jochenalt/Lisbeth/docs/source/index.rst

Welcome to Lisbeth's documentation
==================================

**Lisbeth** is my moody dog. 

.. toctree::
   :hidden:
   :maxdepth: 2

   introduction
   controller
   mechanics
   imu
