jochenalt/Lisbeth/docs/theory.xlsx

Calculation Belt length and shaft distance in HTD 3M
Teeth distance | 3 | [mm]
Teeth1 | 10 | #
Teeth2 | 30 | #
Estimated shaft distance | 71 | [mm]
Length of the belt (without teeth) | 203.3 | [mm]
Actual belt Length | 204 | [mm]
Used Belt lenth | 204 | [mm]
Shaft Distance | 71.36 | [mm]
