jochenalt/Lisbeth/docs/source/images/all/IMG_20220222_164507.jpg

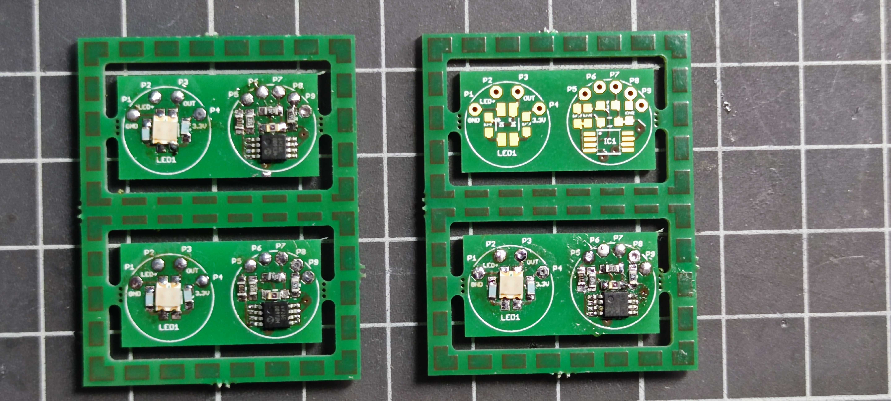
docs/source/images/all/IMG_20220222_164507.jpg
