jochenalt/Lisbeth/docs/source/images/all/IMG_20220223_130408.jpg

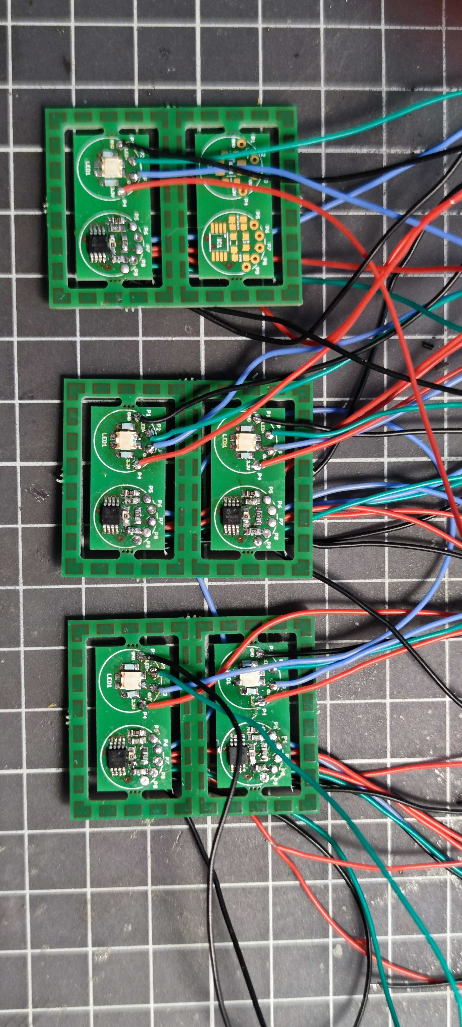
docs/source/images/all/IMG_20220223_130408.jpg
