jochenalt/Lisbeth/docs/source/images/all/IMG_20220223_134208.jpg

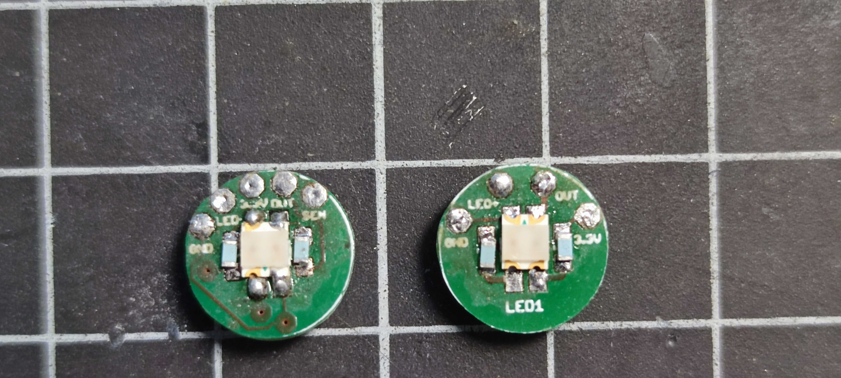
docs/source/images/all/IMG_20220223_134208.jpg
