jochenalt/Lisbeth/docs/source/images/all/IMG_20220308_162108.jpg

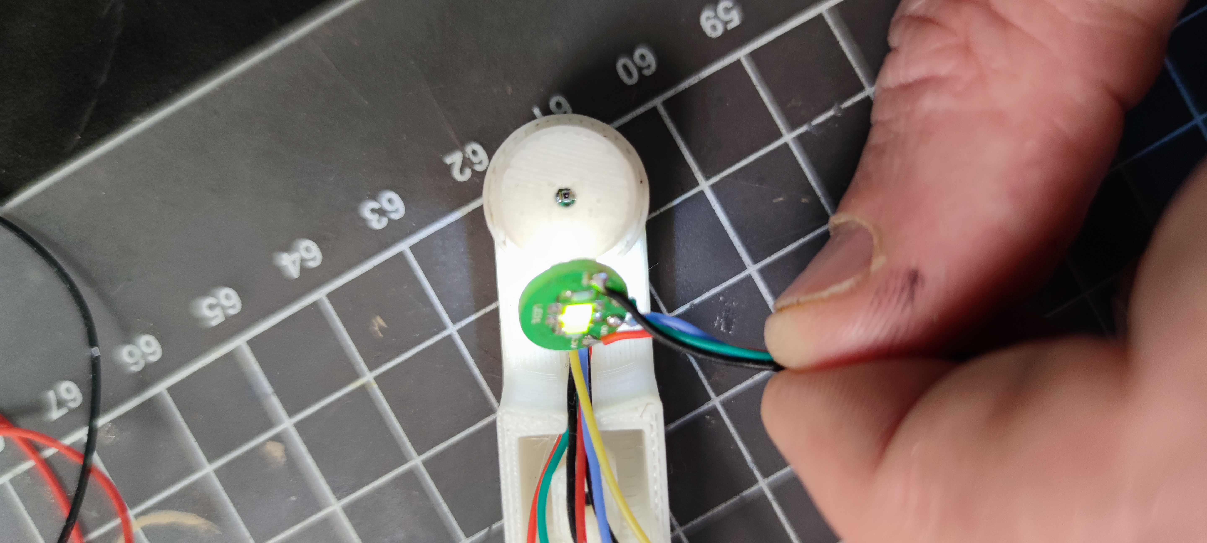
docs/source/images/all/IMG_20220308_162108.jpg
