jochenalt/Lisbeth/docs/source/images/all/IMG_20220308_224854.jpg

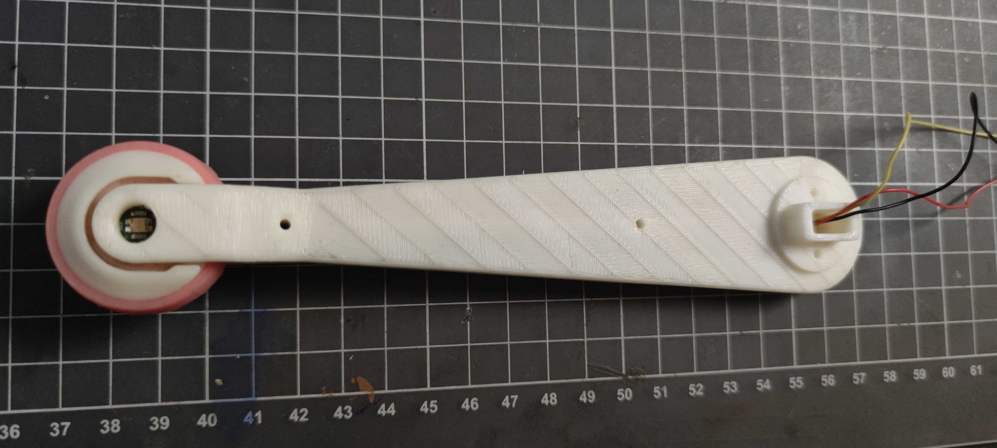
docs/source/images/all/IMG_20220308_224854.jpg
