jochenalt/Lisbeth/docs/source/images/all/IMG_20220308_225036.jpg

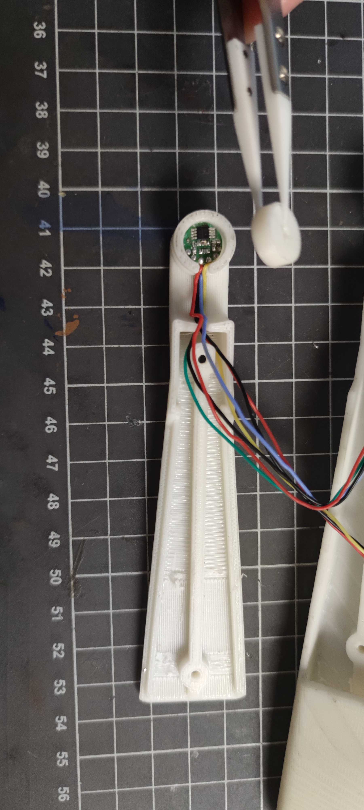
docs/source/images/all/IMG_20220308_225036.jpg
