jochenalt/Lisbeth/docs/source/images/all/IMG_20220308_225524.jpg

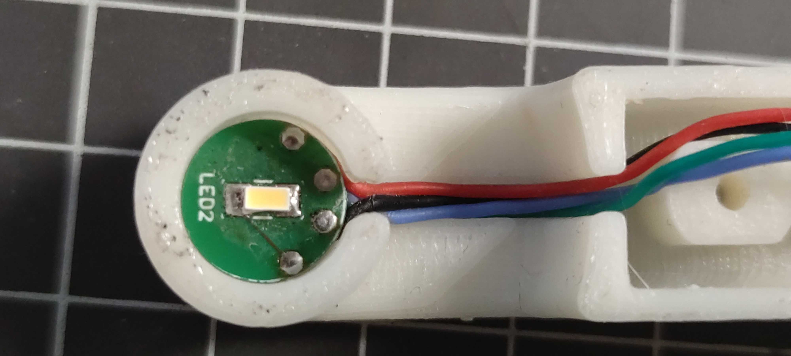
docs/source/images/all/IMG_20220308_225524.jpg
