jochenalt/Lisbeth/docs/source/images/all/WhatsApp Image 2022-03-12 at 16.48.09.jpeg

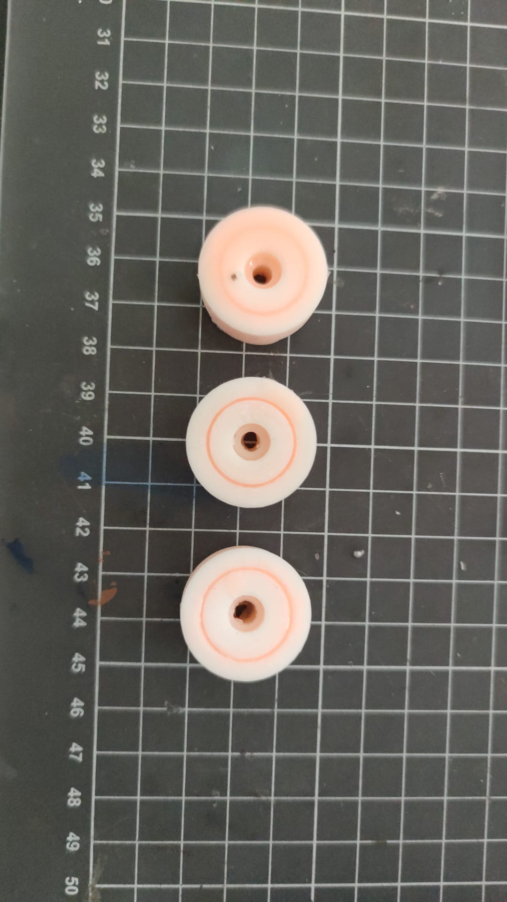
docs/source/images/all/WhatsApp Image 2022-03-12 at 16.48.09.jpeg
