jochenalt/Lisbeth/docs/source/images/IMU_and_Magnetometer_mounted.jpg

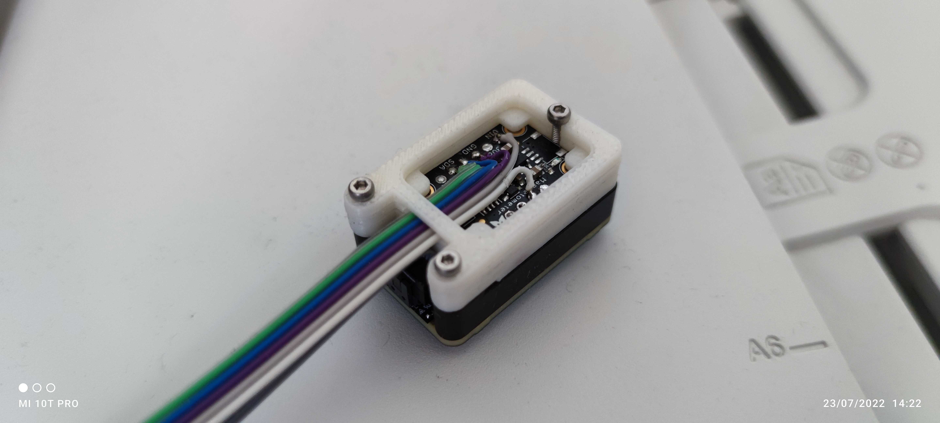
docs/source/images/IMU_and_Magnetometer_mounted.jpg
