jochenalt/Lisbeth/docs/source/images/IMU_Holder.png

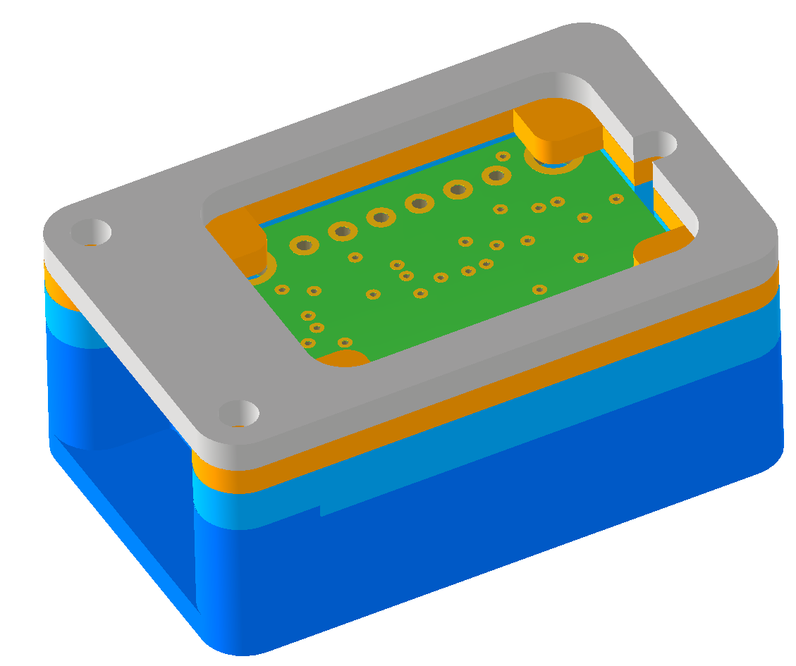
docs/source/images/IMU_Holder.png
