jochenalt/Lisbeth/docs/source/images/Lord_Microstrain_3DMCV5-IMU.png

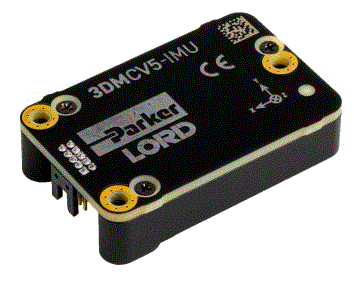
docs/source/images/Lord_Microstrain_3DMCV5-IMU.png
