jochenalt/Lisbeth/docs/source/images/Magnetometer_Original.png

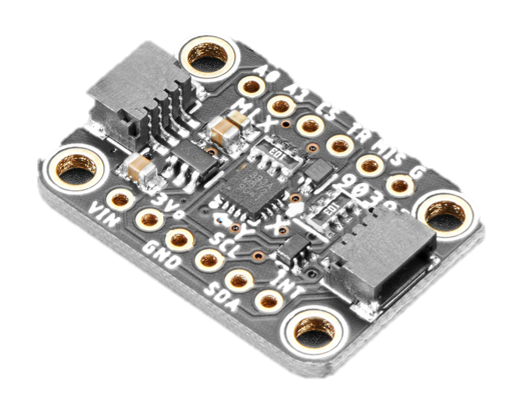
docs/source/images/Magnetometer_Original.png
