jochenalt/Lisbeth/docs/source/images/Magnetometer_without_sockets.png

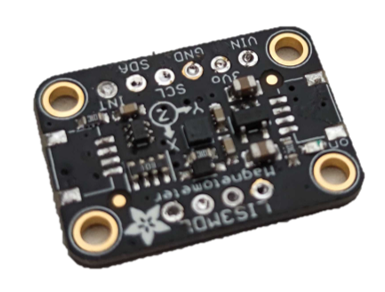
docs/source/images/Magnetometer_without_sockets.png
