jochenalt/Lisbeth/docs/source/images/ODrive_pinout.png

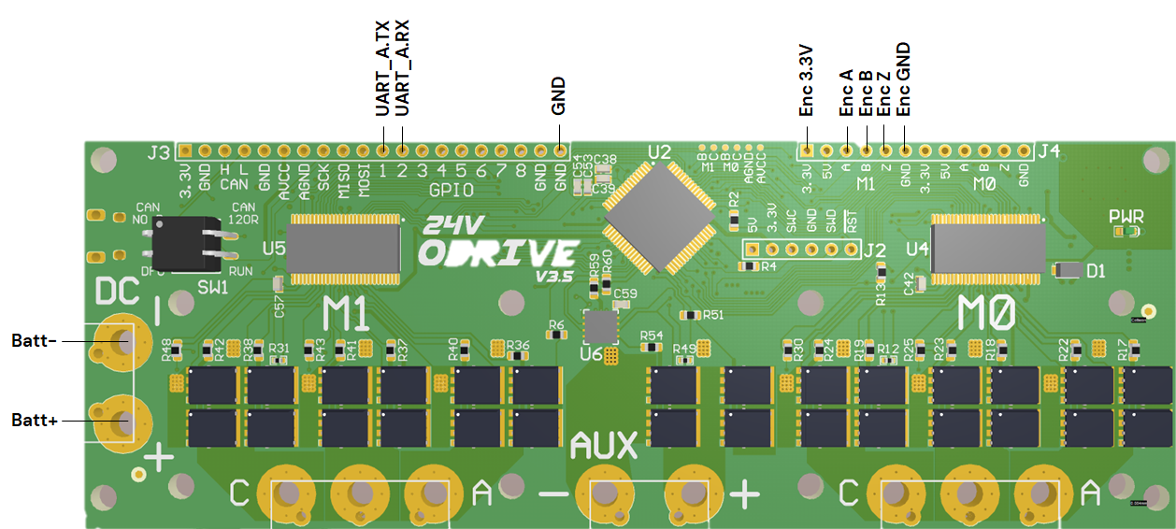
docs/source/images/ODrive_pinout.png
