jochenalt/Lisbeth/docs/source/images/Raspberry_Pinout.png

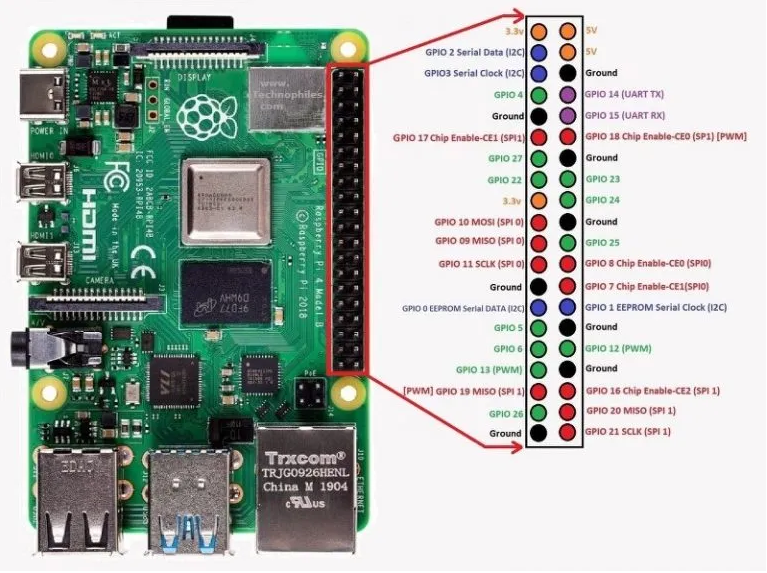
docs/source/images/Raspberry_Pinout.png
