jochenalt/Lisbeth/docs/source/videos/SensorConnect.gif

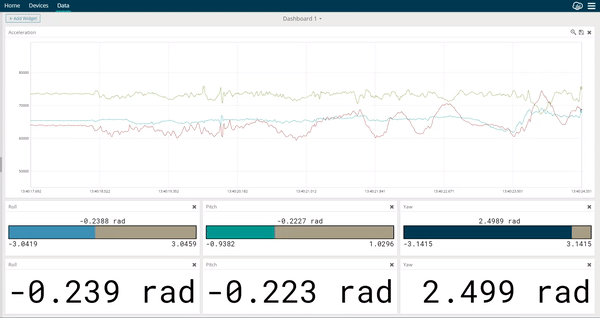
docs/source/videos/SensorConnect.gif
