jochenalt/Lisbeth/BOM.xlsx

Phase | Name | Count | Supplier
Motor Preparation | Reely 2mm Gold Connectors | 18 | https://www.conrad.com/p/reely-1373188-battery-plug-2-mm-gold-plated-2-pair-1373188
