jochenalt/Lisbeth/docs/BOM.xlsx

Sheet: Tabelle1
Phase | Name | Count | Supplier
Motor Preparation | Reely 2mm Gold Connectors | 18 | https://www.conrad.com/p/reely-1373188-battery-plug-2-mm-gold-plated-2-pair-1373188

Sheet: Footsensor
Sensor PCB
Quantity per Sensor | Part | Value | Description | Order code | Part number | Necessary Quantity
1 | IC1 | MCP6V261 | SMD OP Amp rail-to-rail | RS 7559568 | MCP6V26-E/MS | 4
2 | LED1, LED3 | HSFM-C155 | SMD dual LED red/green 20mA 2,1V | Farnell 5790888 | HSMF-C155 | 8
1 | LED2 | LED_SMD_WHITE_1206 | SMD LED White 20mA 3V | Farnell 2470224 | 158301260 | 4
1 | Q1 | ALS-PT19-315C | SMD phototransistor | Digi-Key 1080-1244-1-ND | ALS-PT19-315C/L177/TR8 | 4
1 | R1, R2, R6, R7 | S51R_0603 | SMD resistor 51Ohm | Farnell 2614454 | MCT06030C5109FP500 | 4
1 | R3 | S10K_0603 | SMD resistor 10kOhm | Farnell 2613718 | RN73C1J10KBTDF | 4
1 | R4 | S51K_0603 | SMD resistor 10kOhm | Farnell 2613718 | RN73C1J10KBTDF | 4
1 | R5 | S5.1K_0603 | SMD resistor 20kOhm | Farnell 1469774 | CRCW060320K0FKEA | 4
1 | R8 | S560R_0603 | SMD resistor 560Ohm | Farnell 2502470 | WR06X5600FTL | 4
