jochenalt/Lisbeth/schematics/cerebellar/bom.xlsx

Board | ID | Number | Type | Product | price | Mouser | Digikey | ordered | stock
Central board | U2 | 1 | MOSFET 100V, 100A |  | 1,89 | https://eu.mouser.com/ProductDetail/Diodes-Incorporated/DMTH8003SPS-13?qs=fAHHVMwC%252BbjFPwZ285SuFQ%3D%3D | https://www.digikey.de/de/products/detail/stmicroelectronics/STL100N10F7/3993110?so=75928733 | 4
Central board | U1 | 1 | MOSFET Gate Driver 80V |  | 5,04 | https://eu.mouser.com/ProductDetail/Analog-Devices/LTC4440EMS8E-5PBF?qs=hVkxg5c3xu%2FQJdHaPBlLZQ%3D%3D | https://www.digikey.de/de/products/detail/analog-devices-inc/LTC7001IMSE-PBF/7363804?so=75928733 | 4
Central board | IC2 | 1 | MAX3232 |  | 6,05 | https://eu.mouser.com/ProductDetail/Maxim-Integrated/MAX3232CSE%2b?qs=1THa7WoU59Fh9XTSJvlIug%3D%3D | https://www.digikey.de/de/products/detail/analog-devices-inc-maxim-integrated/MAX3222ECWN-T/1514556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 | 1 | 1
Central board | R3 | 1 | Shunt 0.0004Ohm
Central board | C1 | 1 | LDO Regulator 3.3.V | AP2128K-3.3TRG1 |  |  | https://www.digikey.de/de/products/detail/diodes-incorporated/AP2128K-3-3TRG1/4470794?so=75928733 | 4 | 0
