jochenalt/Lisbeth/CAD/Common/Encoder/encoder_codewheel_5000cpr_pwb_7mm.SLDPRT

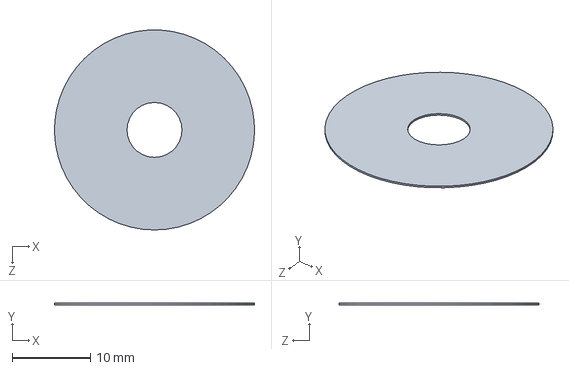
[picture p53: CAD file, 2022-01-15]
CAD/Common/Encoder/encoder_codewheel_5000cpr_pwb_7mm.SLDPRT
25.5 x 0.2 x 25.5 mm
