jochenalt/Lisbeth/CAD/STL/Accessories/IMU Holder - middle.stl

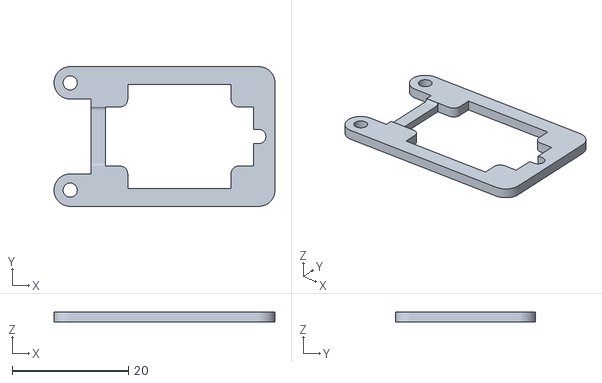
[picture p54: CAD file, 2022-07-19]
CAD/STL/Accessories/IMU Holder - middle.stl
38.1 x 24.1 x 1.80
