jochenalt/Lisbeth/CAD/STL/Body/BodyDampener Mold Lid.stl

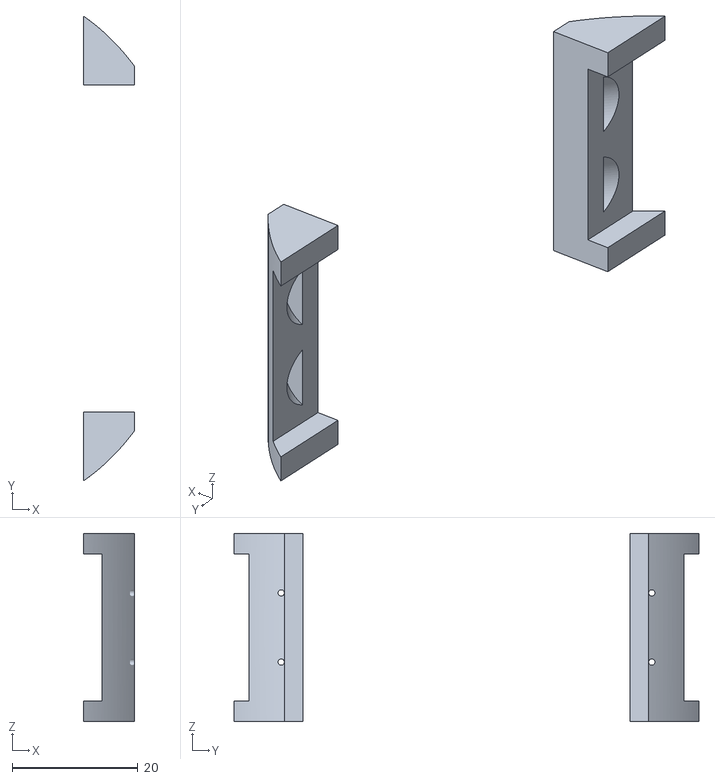
[picture p55: CAD file, 2022-04-11]
CAD/STL/Body/BodyDampener Mold Lid.stl
8.16 x 74.0 x 30.0
