jochenalt/Lisbeth/CAD/STL/Hip/HipBody Short Base.stl

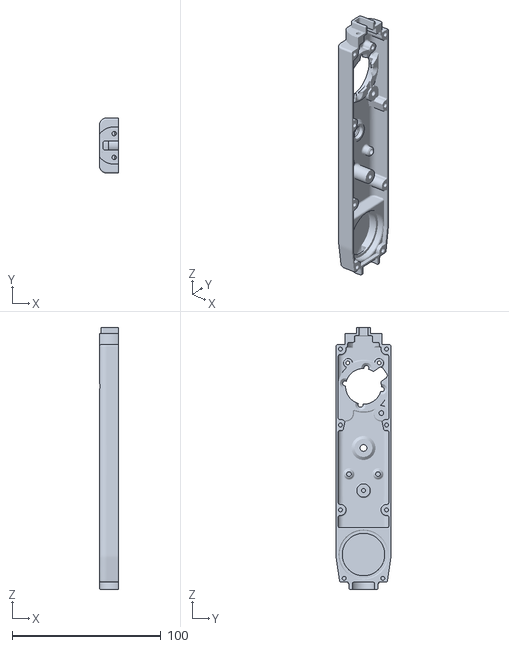
[picture p56: CAD file, 2022-04-11]
CAD/STL/Hip/HipBody Short Base.stl
13.0 x 37.0 x 176.0
