jochenalt/Lisbeth/CAD/STL/Lower Leg/LowerLeg Base.stl

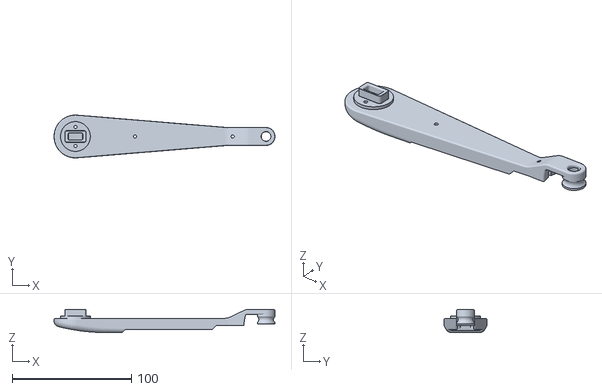
[picture p57: CAD file, 2022-03-24]
CAD/STL/Lower Leg/LowerLeg Base.stl
185.5 x 36.0 x 19.5
