jochenalt/Lisbeth/CAD/STL/Lumbar/Lumbar Long Base.stl

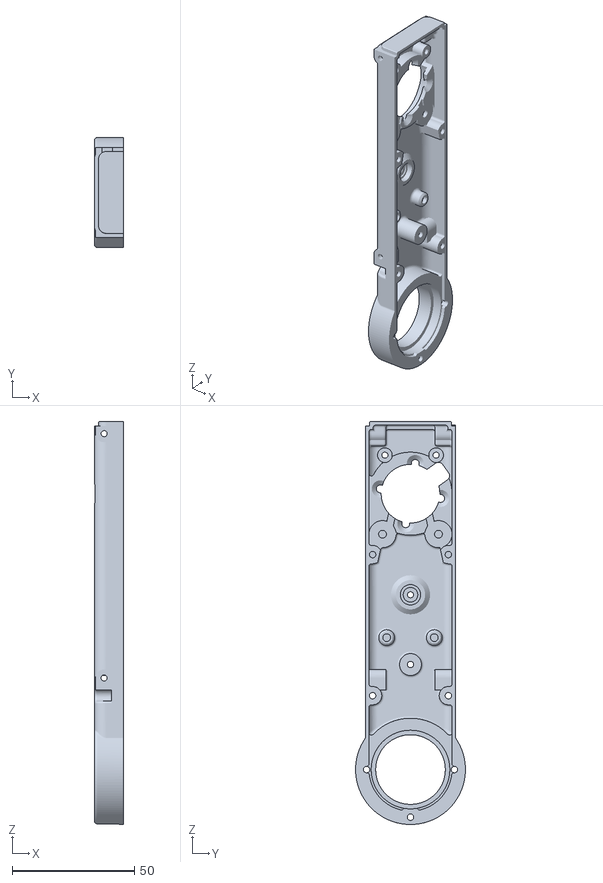
[picture p58: CAD file, 2022-04-11]
CAD/STL/Lumbar/Lumbar Long Base.stl
12.0 x 45.0 x 165.0
