jochenalt/Lisbeth/CAD/STL/Thigh/ThighBody Base.stl

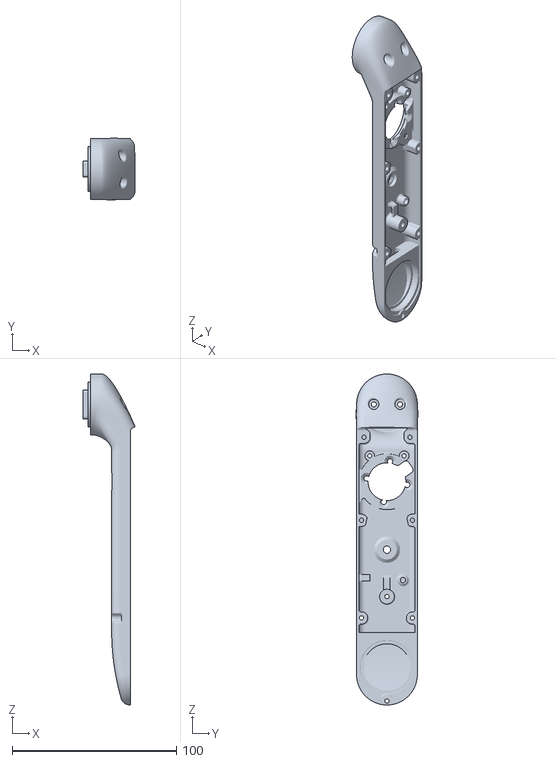
[picture p59: CAD file, 2022-04-11]
CAD/STL/Thigh/ThighBody Base.stl
31.8 x 37.5 x 201.5
