jochenalt/Lisbeth/CAD/STL/Toe Mold/ToeMold InnerTop.stl

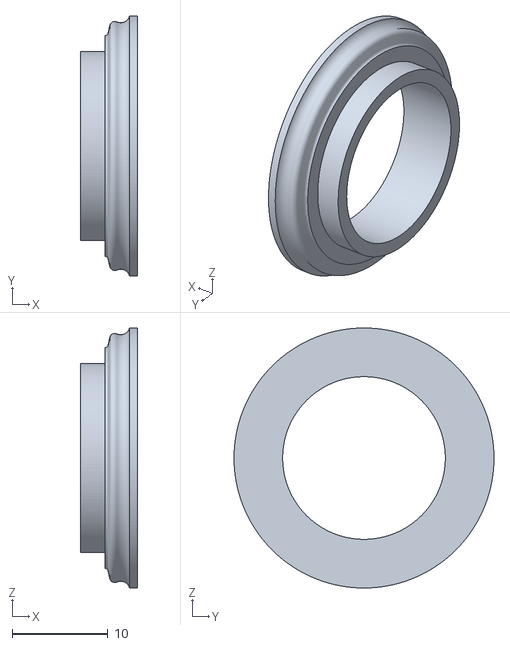
[picture p60: CAD file, 2022-03-24]
CAD/STL/Toe Mold/ToeMold InnerTop.stl
6.00 x 27.2 x 27.2
