jochenalt/Lisbeth/CAD/STL/Tools/FootSensorCalibrationTool.stl

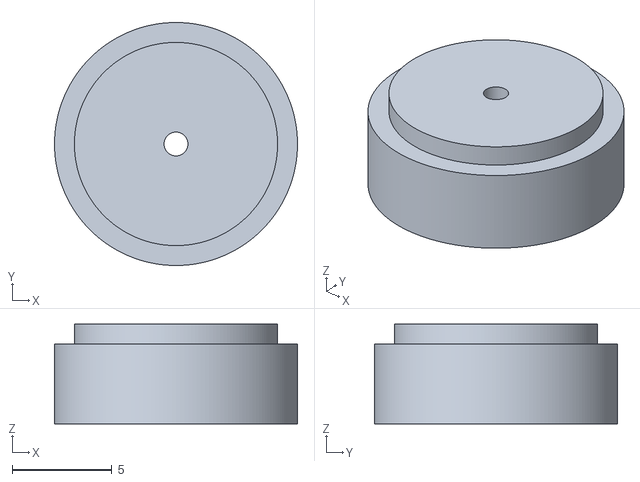
[picture p61: CAD file, 2022-03-09]
CAD/STL/Tools/FootSensorCalibrationTool.stl
12.2 x 12.2 x 5.00
