jochenalt/Lisbeth/CAD/STL/Transmission/EncoderCodeWheelMount.stl

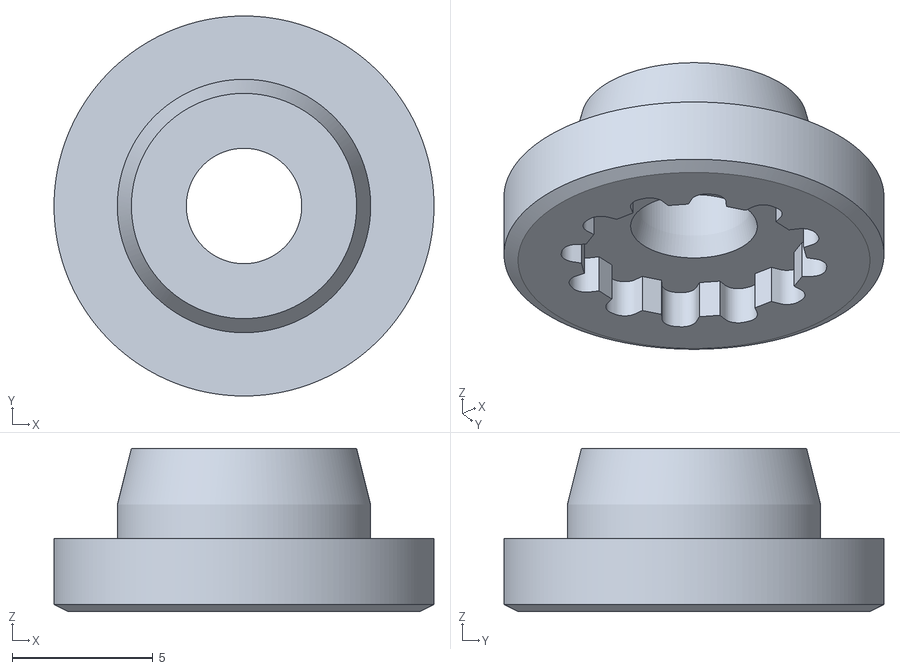
[picture p62: CAD file, 2022-04-11]
CAD/STL/Transmission/EncoderCodeWheelMount.stl
13.5 x 13.5 x 5.80
