jochenalt/Lisbeth/CAD/Tools/Motor/tool_code_wheel_bonding.STL

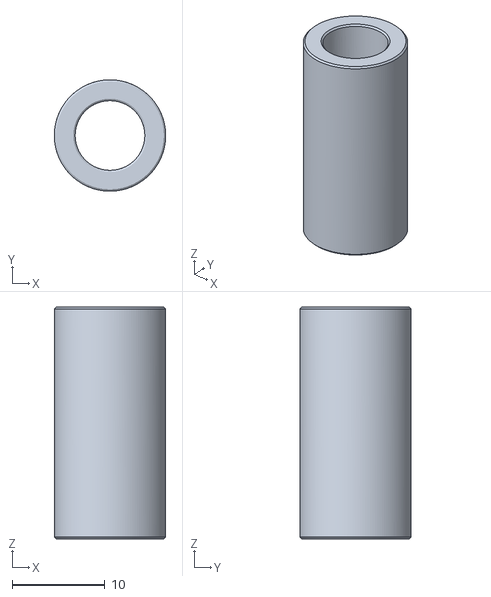
[picture p63: CAD file, 2022-03-09]
CAD/Tools/Motor/tool_code_wheel_bonding.STL
12.0 x 12.0 x 25.0
