jochenalt/Lisbeth/code/controller/scripts/bauzil_stairs.stl

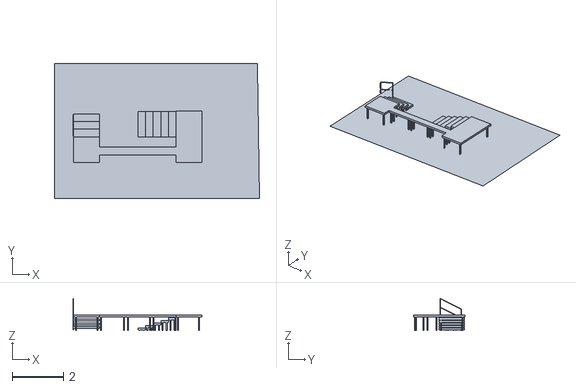
[picture p64: CAD file, 2022-01-27]
code/controller/scripts/bauzil_stairs.stl
8.00 x 5.25 x 1.25
