jochenalt/Lisbeth/description/meshes/stl/hip_fe_fl.stl

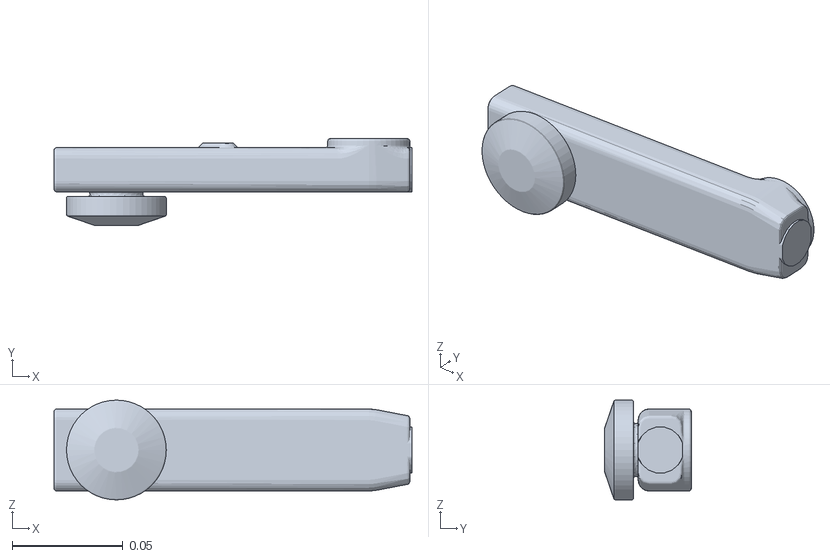
[picture p65: CAD file, 2022-02-14]
description/meshes/stl/hip_fe_fl.stl
0.161 x 0.0391 x 0.045
