jochenalt/Lisbeth/CAD/STL/Accessories/IMU Holder - top.stl

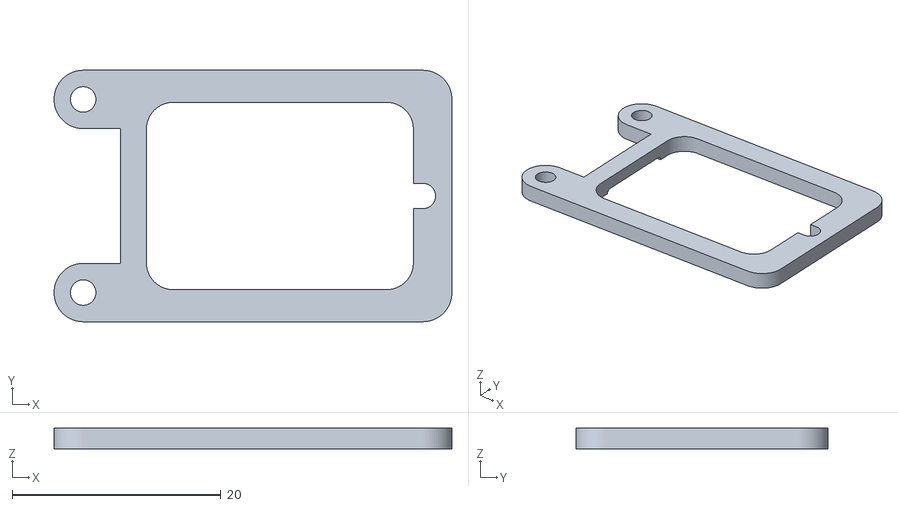
[picture p66: CAD file, 2022-07-19]
CAD/STL/Accessories/IMU Holder - top.stl
38.1 x 24.1 x 2.00
