jochenalt/Lisbeth/CAD/STL/Body/BodyDampener Mold Mid.stl

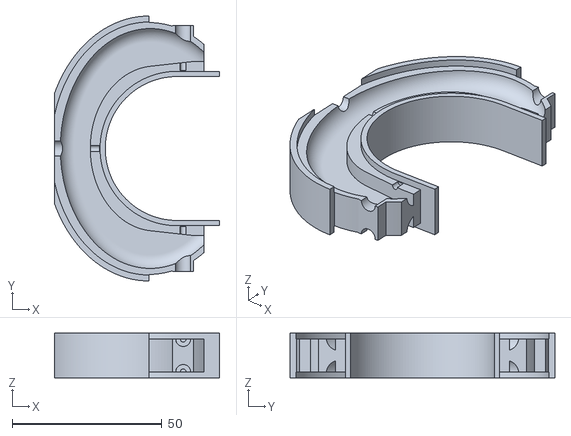
[picture p67: CAD file, 2022-04-11]
CAD/STL/Body/BodyDampener Mold Mid.stl
55.2 x 88.4 x 15.0
