jochenalt/Lisbeth/CAD/STL/Hip/HipBody Short Cover.stl

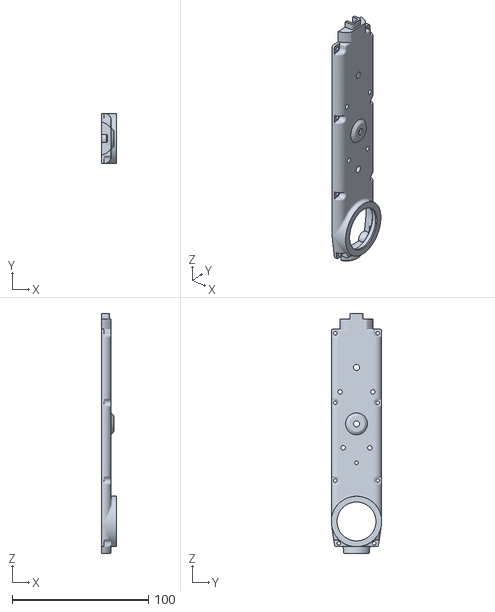
[picture p68: CAD file, 2022-04-11]
CAD/STL/Hip/HipBody Short Cover.stl
11.0 x 37.0 x 176.0
