jochenalt/Lisbeth/CAD/STL/Lower Leg/LowerLeg Cover.stl

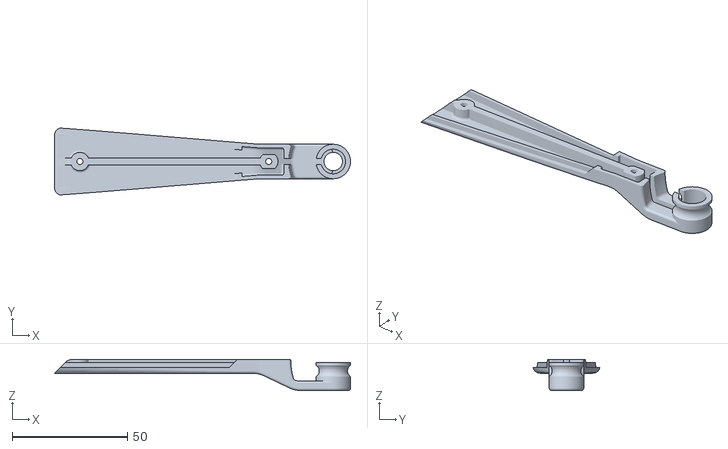
[picture p69: CAD file, 2022-03-24]
CAD/STL/Lower Leg/LowerLeg Cover.stl
128.5 x 29.0 x 13.5
