jochenalt/Lisbeth/CAD/STL/Thigh/ThighBody Cover.stl

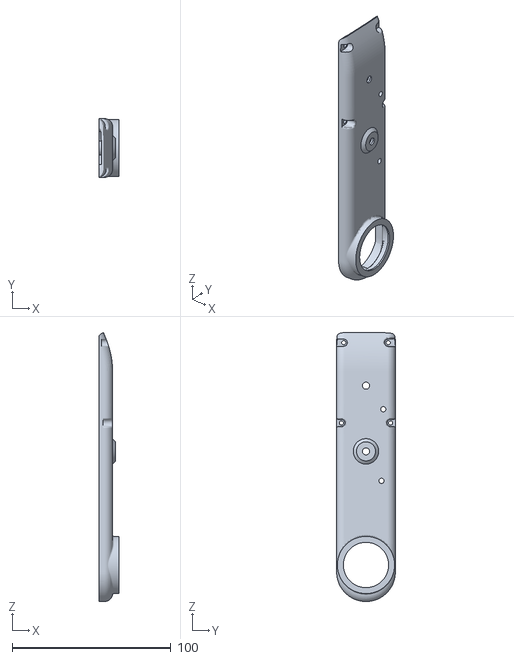
[picture p70: CAD file, 2022-04-11]
CAD/STL/Thigh/ThighBody Cover.stl
12.5 x 37.0 x 169.4
