jochenalt/Lisbeth/CAD/STL/Toe Mold/ToeMold Base.stl

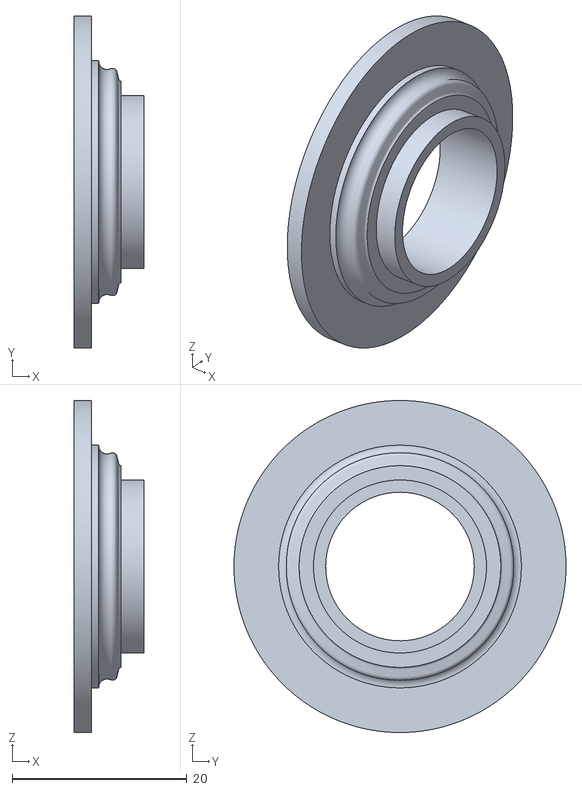
[picture p71: CAD file, 2022-03-24]
CAD/STL/Toe Mold/ToeMold Base.stl
8.00 x 38.0 x 38.0
