jochenalt/Lisbeth/CAD/STL/Transmission/TransmissionCenterBigPulley.stl

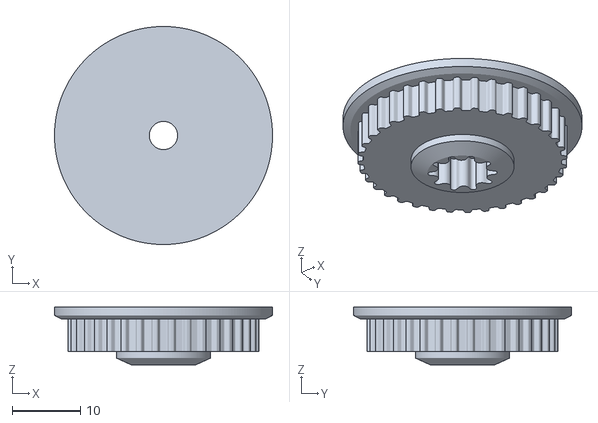
[picture p72: CAD file, 2022-04-11]
CAD/STL/Transmission/TransmissionCenterBigPulley.stl
32.0 x 32.0 x 8.50
