jochenalt/Lisbeth/CAD/Tools/Motor/tool_motor_shaft_pulley_bonding.STL

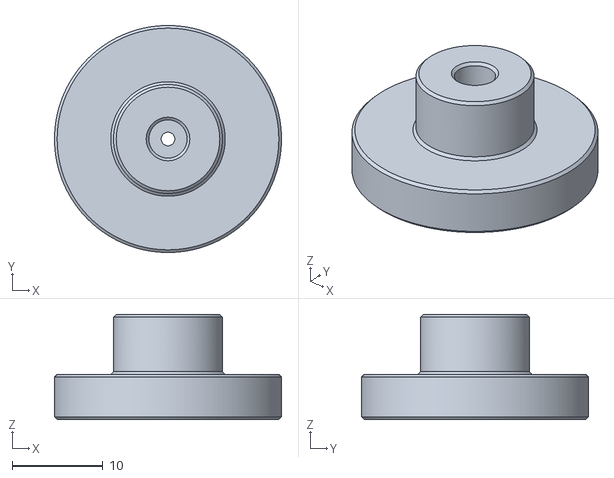
[picture p73: CAD file, 2022-03-09]
CAD/Tools/Motor/tool_motor_shaft_pulley_bonding.STL
25.0 x 25.0 x 11.6
