jochenalt/Lisbeth/CAD/STL/Accessories/IMU Holder - bottom.stl

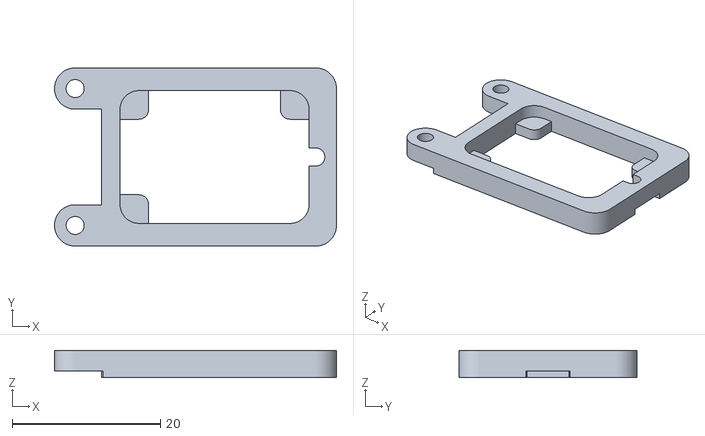
[picture p74: CAD file, 2022-07-19]
CAD/STL/Accessories/IMU Holder - bottom.stl
38.1 x 24.1 x 3.70
