jochenalt/Lisbeth/CAD/STL/Body/BodyDampener Mold Right.stl

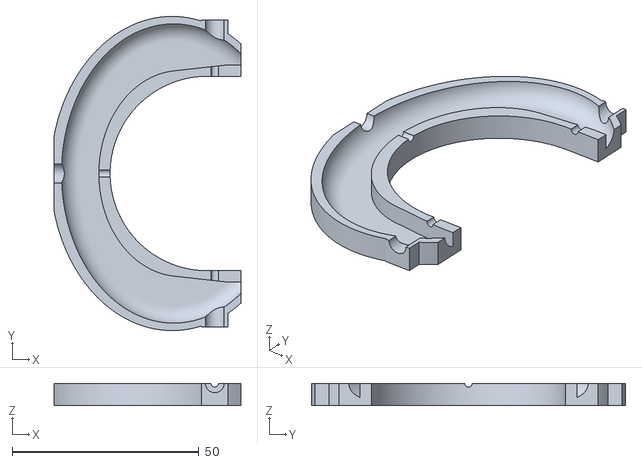
[picture p75: CAD file, 2022-04-11]
CAD/STL/Body/BodyDampener Mold Right.stl
50.0 x 84.0 x 6.00
