jochenalt/Lisbeth/CAD/STL/Hip/HipBody Long Base.stl

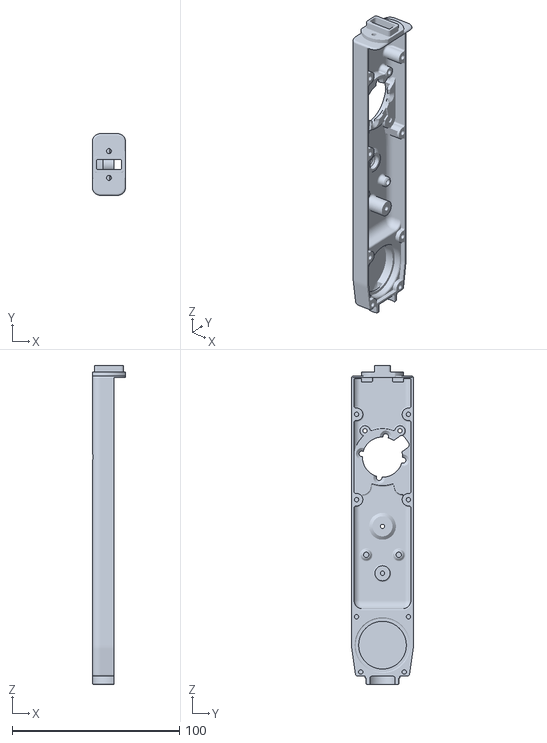
[picture p76: CAD file, 2022-03-24]
CAD/STL/Hip/HipBody Long Base.stl
20.0 x 37.0 x 190.7
