jochenalt/Lisbeth/CAD/STL/Lower Leg/Toe.stl

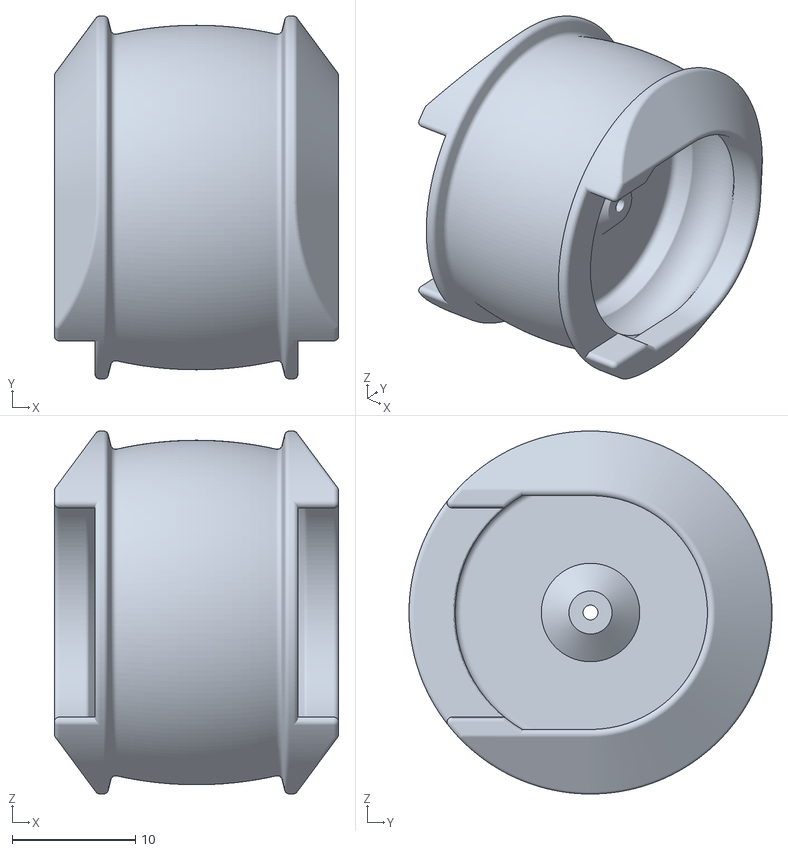
[picture p77: CAD file, 2022-03-24]
CAD/STL/Lower Leg/Toe.stl
23.1 x 29.5 x 29.5
