jochenalt/Lisbeth/CAD/STL/Lumbar/Lumbar Short Cover.stl

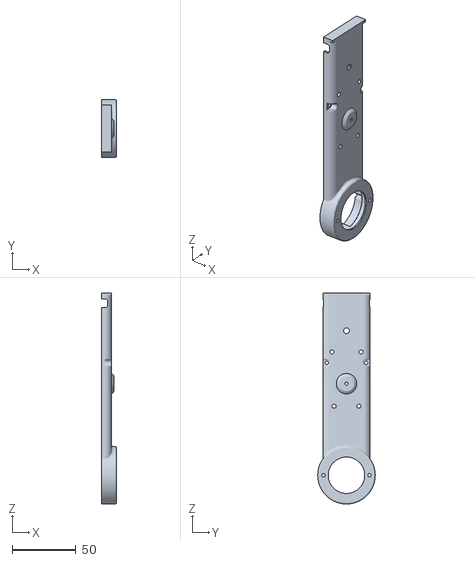
[picture p78: CAD file, 2022-04-11]
CAD/STL/Lumbar/Lumbar Short Cover.stl
12.0 x 45.0 x 165.0
