jochenalt/Lisbeth/CAD/STL/Toe Mold/ToeMold InnerPipe.stl

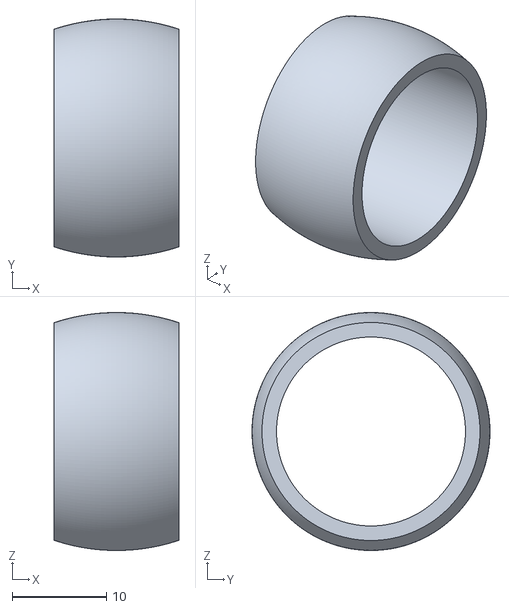
[picture p79: CAD file, 2022-03-24]
CAD/STL/Toe Mold/ToeMold InnerPipe.stl
13.2 x 25.2 x 25.2
