jochenalt/Lisbeth/CAD/STL/Transmission/TransmissionPulleyOutput.stl

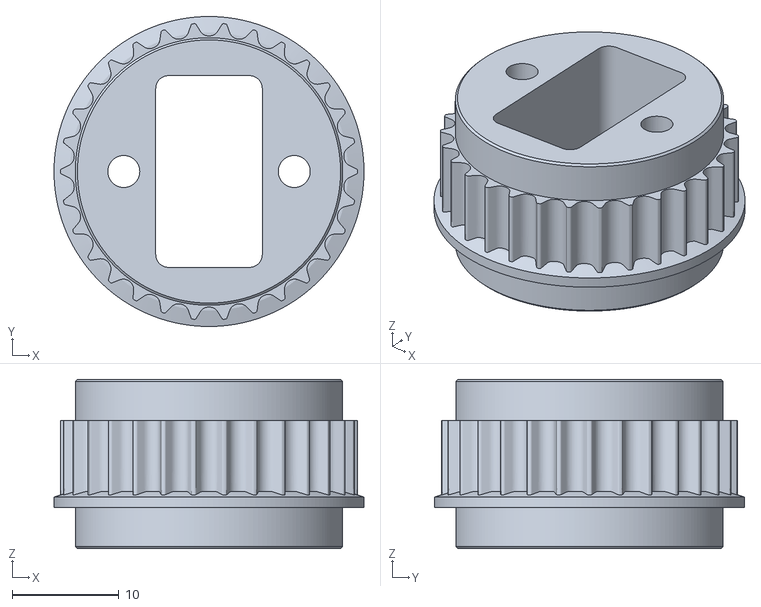
[picture p80: CAD file, 2022-03-24]
CAD/STL/Transmission/TransmissionPulleyOutput.stl
29.1 x 29.1 x 15.9
