jochenalt/Lisbeth/CAD/Tools/Motor/tool_motor_shaft_extraction.STL

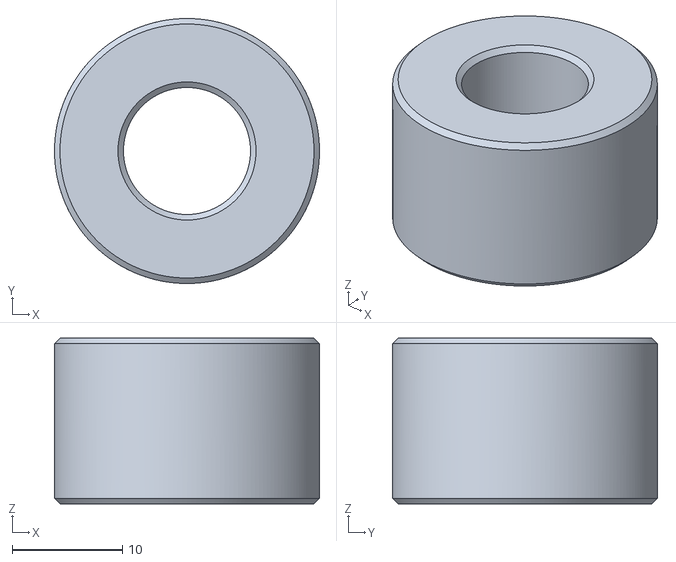
[picture p81: CAD file, 2022-01-15]
CAD/Tools/Motor/tool_motor_shaft_extraction.STL
24.0 x 24.0 x 15.0
