jochenalt/Lisbeth/CAD/STL/Hip/HipBody Long Cover.stl

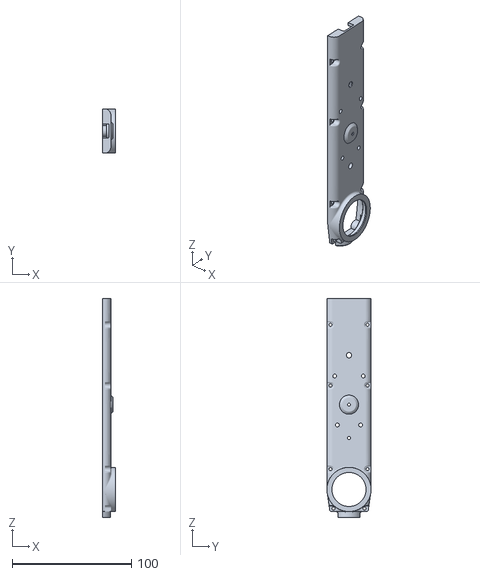
[picture p82: CAD file, 2022-03-24]
CAD/STL/Hip/HipBody Long Cover.stl
11.0 x 37.0 x 183.5
