jochenalt/Lisbeth/CAD/STL/Toe Mold/ToeMold OuterTop.stl

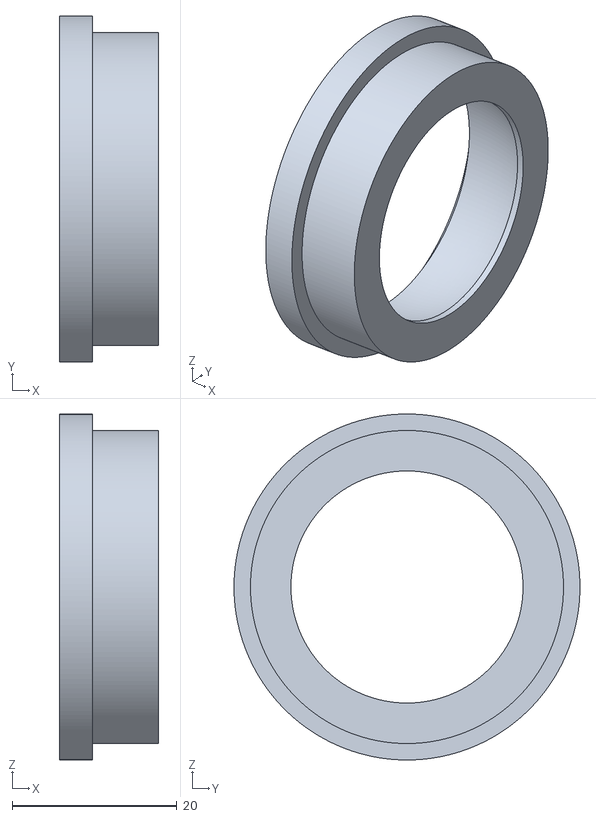
[picture p83: CAD file, 2022-03-24]
CAD/STL/Toe Mold/ToeMold OuterTop.stl
12.0 x 42.0 x 42.0
