jochenalt/Lisbeth/CAD/STL/Transmission/BeltTensionerRoller 10mm.stl

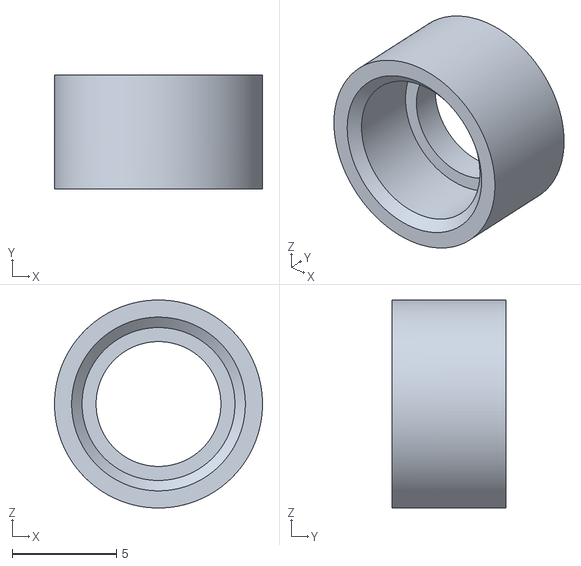
[picture p84: CAD file, 2022-03-09]
CAD/STL/Transmission/BeltTensionerRoller 10mm.stl
10.0 x 5.50 x 10.00
