jochenalt/Lisbeth/description/meshes/stl/foot.stl

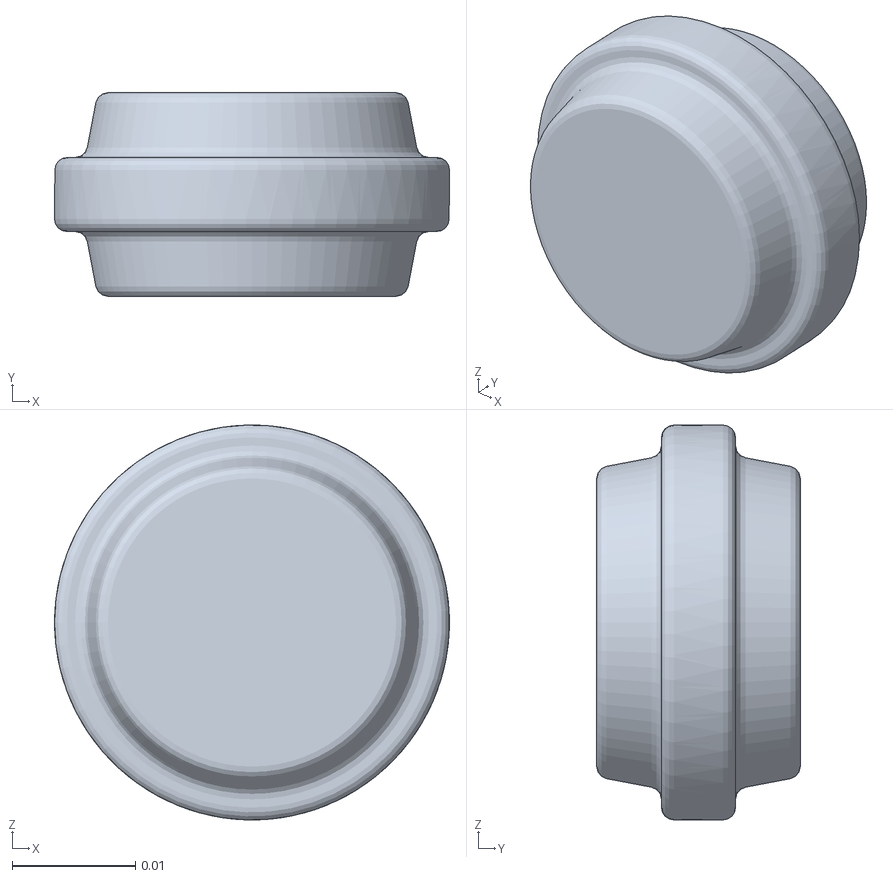
[picture p85: CAD file, 2022-02-14]
description/meshes/stl/foot.stl
0.032 x 0.0165 x 0.032
