jochenalt/Lisbeth/CAD/STL/Body/BodyDampener Holes.stl

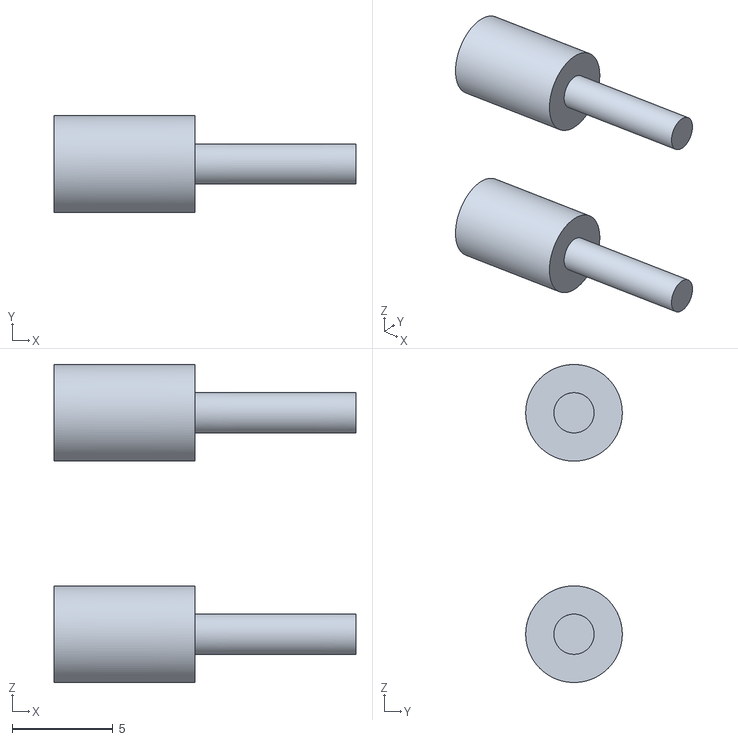
[picture p86: CAD file, 2022-04-11]
CAD/STL/Body/BodyDampener Holes.stl
15.0 x 4.80 x 15.8
