jochenalt/Lisbeth/CAD/STL/Toe Mold/ToeMold OuterBottom.stl

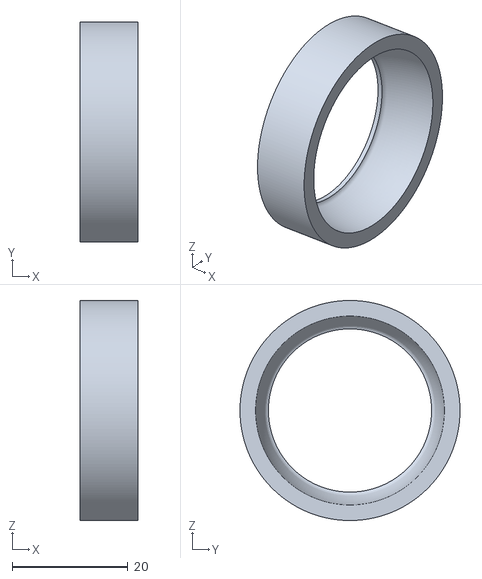
[picture p87: CAD file, 2022-03-24]
CAD/STL/Toe Mold/ToeMold OuterBottom.stl
10.0 x 38.0 x 38.0
