jochenalt/Lisbeth/CAD/STL/Transmission/MotorBeltTensionerRoller 10mm.stl

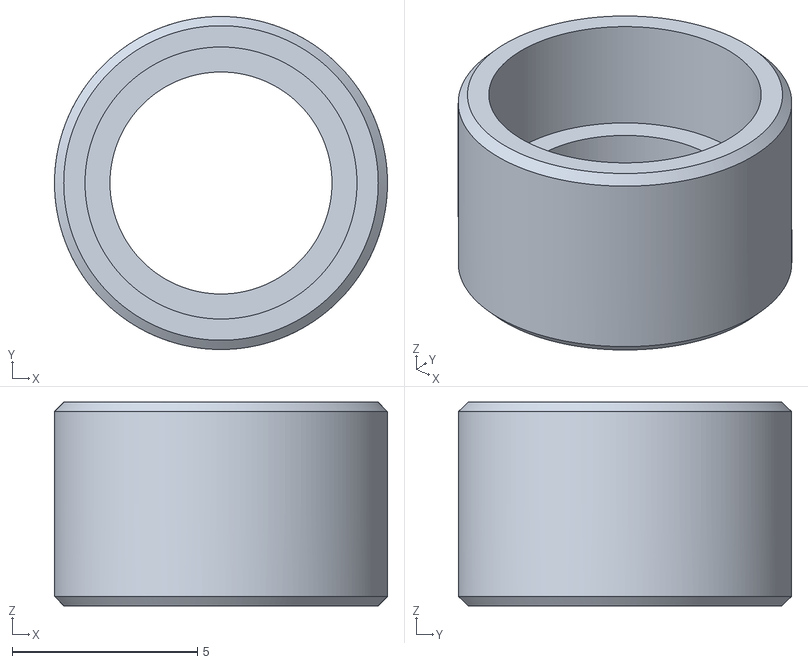
[picture p88: CAD file, 2022-03-09]
CAD/STL/Transmission/MotorBeltTensionerRoller 10mm.stl
9.00 x 9.00 x 5.50
