jochenalt/Lisbeth/description/meshes/stl/body.stl

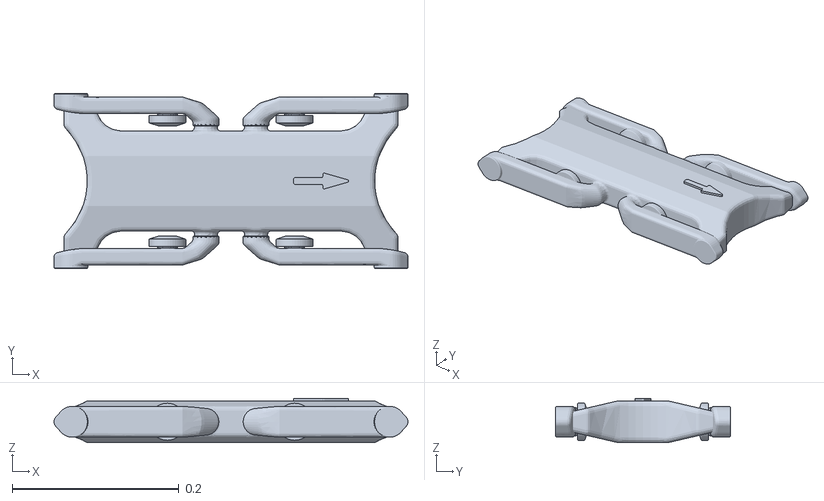
[picture p89: CAD file, 2022-02-14]
description/meshes/stl/body.stl
0.424 x 0.209 x 0.053
