jochenalt/Lisbeth/CAD/STL/Toe Mold/ToeDampenerMold Cover.stl

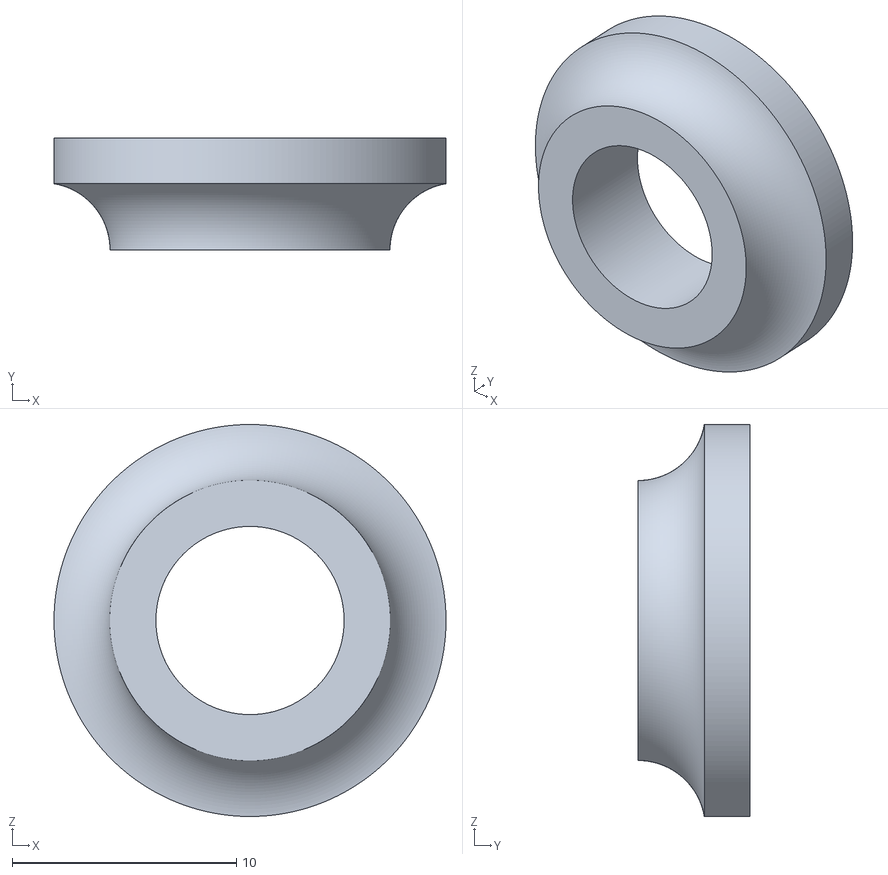
[picture p90: CAD file, 2022-03-09]
CAD/STL/Toe Mold/ToeDampenerMold Cover.stl
17.5 x 5.00 x 17.5
