jochenalt/Lisbeth/CAD/STL/Toe Mold/ToeDampenerMold Base.stl

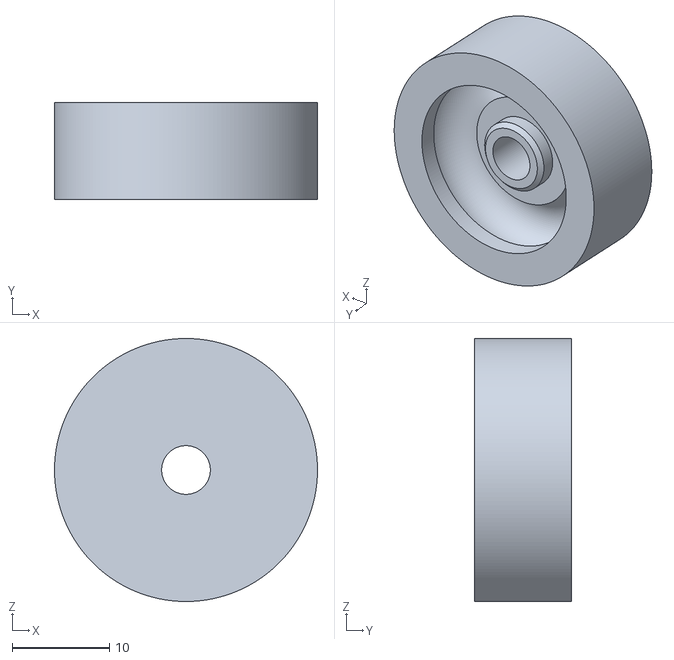
[picture p91: CAD file, 2022-03-09]
CAD/STL/Toe Mold/ToeDampenerMold Base.stl
27.0 x 10.0 x 27.0
