jochenalt/Lisbeth/description/meshes/stl/lower_leg_right_side.stl

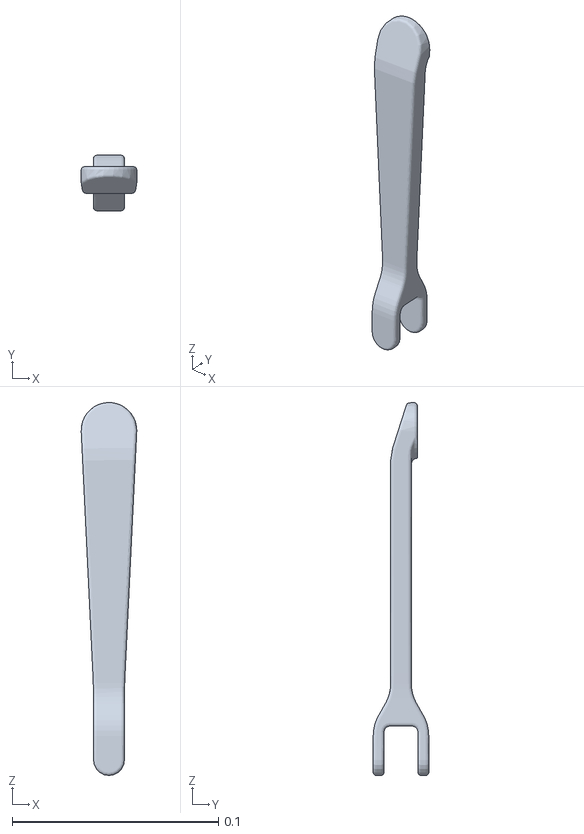
[picture p92: CAD file, 2022-02-14]
description/meshes/stl/lower_leg_right_side.stl
0.027 x 0.027 x 0.181
