jochenalt/Lisbeth/description/meshes/stl/upper_leg_left_side.stl

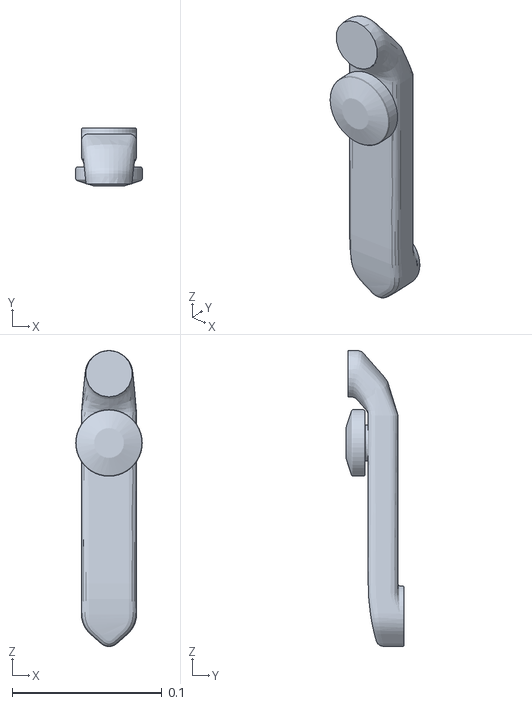
[picture p93: CAD file, 2022-02-14]
description/meshes/stl/upper_leg_left_side.stl
0.0444 x 0.0389 x 0.198
