jochenalt/Lisbeth/description/meshes/stl/base.stl

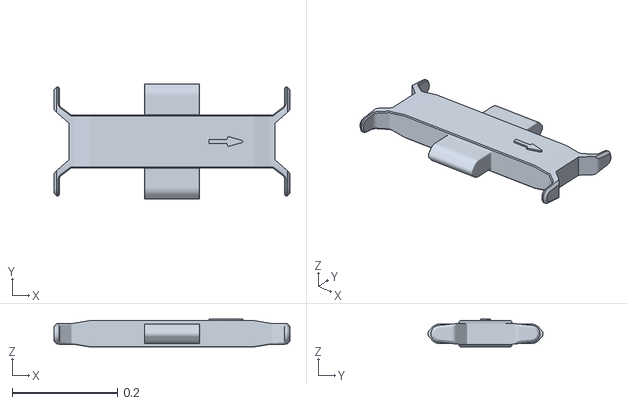
[picture p94: CAD file, 2022-02-14]
description/meshes/stl/base.stl
0.448 x 0.219 x 0.053
