jochenalt/Lisbeth/(list of files, cad)

Other CAD files:
CAD/STL/Lumbar/Lumbar Short Base.stl
description/meshes/stl/hip_fe_fr.stl
description/meshes/stl/hip_fe_hr.stl
CAD/STL/Body/BodyDampener Mold Left.stl
CAD/STL/Lumbar/Lumbar Long Cover.stl
CAD/STL/Body/BodyDampener MoldSleeve.stl
description/meshes/stl/hip_fe_hl.stl
description/meshes/stl/lower_leg_left_side.stl
description/meshes/stl/upper_leg_right_side.stl
CAD/Body/BodyCover.ipt
CAD/Body/BodyDampener Mold.ipt
CAD/Body/BodyDampener.ipt
CAD/Body/BodyHipSupport.iam
CAD/Body/BodyStructure Centre Top.ipt
CAD/Body/BodyStructure Front.ipt
CAD/Body/BodyStructure Head.ipt
CAD/Body/BodyStructure HipSupport.ipt
CAD/Body/BodyStructure LumbarSupport.ipt
CAD/Body/BodyStructure LumbarSupportSmall.ipt
CAD/Body/BodyStructure Plate.ipt
CAD/Body/BodyStructure Side.ipt
CAD/Body/BodyStructure Tail.ipt
CAD/BodyStructure.iam
CAD/Common/Accessories/Adafruit 2.4 OLED display.ipt
CAD/Common/Accessories/Battery Pack.ipt
CAD/Common/Accessories/IMU Holder.ipt
CAD/Common/Accessories/IMU+Mag.iam
CAD/Common/Accessories/LED 5mm.ipt
CAD/Common/Accessories/Lord Microstrain 3DM-CX5 OEM.ipt
CAD/Common/Bearing/bearing_25_20_4_sbn_ET25202ZVA.ipt
CAD/Common/Bearing/bearing_27_20_4 s61704-2rsr.ipt
CAD/Common/Bearing/bearing_32_25_4_sbn_61705RS.ipt
CAD/Common/Bearing/bearing_7_3_3_sbn_683_2ZVA.ipt
CAD/Common/Bearing/bearing_8_4_2_sbn_MR84VA.ipt
CAD/Common/Belt Tensioner/BeltTensioner 10mm.iam
CAD/Common/Belt Tensioner/BeltTensionerRoller 10mm.ipt
CAD/Common/Belt Tensioner/MotorBeltTensioner 10mm.iam
CAD/Common/Belt Tensioner/MotorBeltTensionerAxis.ipt
CAD/Common/Belt Tensioner/MotorBeltTensionerGuide.ipt
CAD/Common/Belt Tensioner/MotorBeltTensionerRoller 10mm.ipt
CAD/Common/Belt Tensioner/MotorBeltTensionerSleeve 5mm.ipt
CAD/Common/Belt Tensioner/OldVersions/Belt Tensioner 10mm.0001.iam
CAD/Common/Belt Tensioner/OutputBeltTensionerSleeve 5mm.ipt
CAD/Common/Encoder/EncoderCodeWheelMount HTD-3M.ipt
CAD/Common/Encoder/EncoderCodeWheelMount T2.5.ipt
CAD/Common/Encoder/EncoderCodeWheelMount.ipt
CAD/Common/Encoder/encoder.iam
CAD/Common/Encoder/encoder_avago_aedt_9810.ipt
CAD/Common/Encoder/encoder_codewheel_5000cpr_pwb_7mm.ipt
CAD/Common/Fastener/fastener_fhs_m3_10.ipt
CAD/Common/Fastener/fastener_fhs_m3_5.ipt
CAD/Common/Motor/Motor AntiGravity 4004 Custom Shaft.ipt
CAD/Common/Motor/Motor AntiGravity 4004 Rotor.ipt
CAD/Common/Motor/Motor AntiGravity 4004 Brass Spacer.ipt
CAD/Common/Motor/Motor AntiGravity 4004 Stator.ipt
CAD/Common/Motor/Motor AntiGravity 4004 with Custom Shaft.iam
CAD/Common/Motor/MotorModule.iam
CAD/Common/Pulley/HTD 3M/17031000.stp
CAD/Common/Pulley/HTD 3M/17033000.stp
CAD/Common/Pulley/MotorPulley.ipt
CAD/Common/Pulley/Pulley HTD 3M 10T.ipt
CAD/Common/Transmission/Transmission Pulley.iam
CAD/Common/Transmission/TransmissionCenterBigPulley.ipt
CAD/Common/Transmission/TransmissionPulleyCenter.iam
CAD/Common/Transmission/TransmissionPulleyCentreAxis.ipt
CAD/Common/Transmission/TransmissionPulleyOutput.ipt
CAD/Common/Transmission/transmission_output_pulley.iam
CAD/Common/Up2/0717A0BA99C.ipt
CAD/Common/Up2/1304300140.ipt
CAD/Common/Up2/1601000990.ipt
CAD/Common/Up2/1652503109.ipt
CAD/Common/Up2/1654801010.ipt
CAD/Common/Up2/1654809302.ipt
CAD/Common/Up2/1654818301.ipt
CAD/Common/Up2/1654907009.ipt
CAD/Common/Up2/1655802020.ipt
CAD/Common/Up2/1655910130.ipt
CAD/Common/Up2/2230-MINI-PCIE_3.ipt
CAD/Common/Up2/3VD1120X-XHJ0-4H_20160602.ipt
CAD/Common/Up2/530470210.ipt
CAD/Common/Up2/ASM0111_ASM.iam
CAD/Common/Up2/ASSEMBLY-1_ASM.iam
CAD/Common/Up2/AXK6S60547Y.ipt
CAD/Common/Up2/AYF333135-CLOSED.ipt
CAD/Common/Up2/CHIKE-1.ipt
CAD/Common/Up2/CHOKE.ipt
CAD/Common/Up2/CN3.ipt
CAD/Common/Up2/CPU.ipt
CAD/Common/Up2/FH35-21S-03SHW.ipt
CAD/Common/Up2/FH35-21S-0_3SHW_ASM.iam
CAD/Common/Up2/FH35-41S-03SHW.ipt
CAD/Common/Up2/FH35-41S-0_3SHW_ASM.iam
CAD/Common/Up2/HEATSINK-ALL-9W-ING.ipt
CAD/Common/Up2/M-2_ASM.iam
CAD/Common/Up2/MINI-PCI-EXPRESS-52PIN.ipt
CAD/Common/Up2/PCB-85-85.ipt
CAD/Common/Up2/PIN-HEADER-2P0-06.ipt
CAD/Common/Up2/PIN-HEADER-DUAL-254-040.ipt
CAD/Common/Up2/PRT0210_3.ipt
CAD/Common/Up2/PRT0211_3.ipt
CAD/Common/Up2/PRT0212_3.ipt
CAD/Common/Up2/PRT0213_3.ipt
CAD/Common/Up2/R47.ipt
CAD/Common/Up2/SO-GUIDE-M3_STANDOFFS-_5P0.ipt
CAD/Common/Up2/SO-M2P5-STANDOFF-L5P0.ipt
CAD/Common/Up2/THERMAL-PAD-CUP.ipt
CAD/Common/Up2/THERMAL-PAD-IC.ipt
CAD/Common/Up2/U10.ipt
CAD/Common/Up2/U11.ipt
CAD/Common/Up2/U43.ipt
CAD/Common/Up2/U52.ipt
CAD/Common/Up2/WAFER-JST-B02B-PH-K-S.ipt
CAD/Common/Up2/pcba-up2-85-56_asm-106-03-01.iam
CAD/Common/Washer/Washer m2.5.ipt
CAD/Common/odrive/724056776.iam
CAD/Common/odrive/781542576.iam
CAD/Common/odrive/781542712.iam
CAD/Common/odrive/781542984.iam
CAD/Common/odrive/781543120.iam
CAD/Common/odrive/781543256.iam
CAD/Common/odrive/781543392.iam
CAD/Common/odrive/781543528.iam
CAD/Common/odrive/781543664.iam
CAD/Common/odrive/781543800.iam
CAD/Common/odrive/781543936.iam
CAD/Common/odrive/781544072.iam
CAD/Common/odrive/781544208.iam
CAD/Common/odrive/781544344.iam
CAD/Common/odrive/781544480.iam
CAD/Common/odrive/781544616.iam
CAD/Common/odrive/781544888.iam
CAD/Common/odrive/781545024.iam
CAD/Common/odrive/781545160.iam
CAD/Common/odrive/781545296.iam
CAD/Common/odrive/781637824.iam
CAD/Common/odrive/781637952.iam
CAD/Common/odrive/781638592.iam
CAD/Common/odrive/823287408.iam
CAD/Common/odrive/Board.ipt
CAD/Common/odrive/Body.iam
CAD/Common/odrive/C1.iam
CAD/Common/odrive/C10.iam
CAD/Common/odrive/C11.iam
CAD/Common/odrive/C12.iam
CAD/Common/odrive/C13.iam
CAD/Common/odrive/C14.iam
CAD/Common/odrive/C15.iam
CAD/Common/odrive/C16.iam
CAD/Common/odrive/C17.iam
CAD/Common/odrive/C18.iam
CAD/Common/odrive/C19.iam
CAD/Common/odrive/C2.iam
CAD/Common/odrive/C20.iam
CAD/Common/odrive/C21.iam
CAD/Common/odrive/C22.iam
CAD/Common/odrive/C23.iam
CAD/Common/odrive/C24.iam
CAD/Common/odrive/C25.iam
CAD/Common/odrive/C26.iam
CAD/Common/odrive/C27.iam
CAD/Common/odrive/C28.iam
CAD/Common/odrive/C29.iam
CAD/Common/odrive/C3.iam
CAD/Common/odrive/C30.iam
CAD/Common/odrive/C31.iam
CAD/Common/odrive/C32.iam
CAD/Common/odrive/C33.iam
CAD/Common/odrive/C34.iam
CAD/Common/odrive/C35.iam
CAD/Common/odrive/C36.iam
CAD/Common/odrive/C37.iam
CAD/Common/odrive/C38.iam
CAD/Common/odrive/C39.iam
CAD/Common/odrive/C4.iam
CAD/Common/odrive/C40.iam
CAD/Common/odrive/C41.iam
CAD/Common/odrive/C42.iam
CAD/Common/odrive/C43.iam
CAD/Common/odrive/C44.iam
CAD/Common/odrive/C45.iam
CAD/Common/odrive/C46.iam
CAD/Common/odrive/C47.iam
CAD/Common/odrive/C48.iam
CAD/Common/odrive/C49.iam
CAD/Common/odrive/C5.iam
CAD/Common/odrive/C50.iam
CAD/Common/odrive/C51.iam
CAD/Common/odrive/C52.iam
CAD/Common/odrive/C53.iam
CAD/Common/odrive/C54.iam
CAD/Common/odrive/C55.iam
CAD/Common/odrive/C56.iam
CAD/Common/odrive/C57.iam
CAD/Common/odrive/C58.iam
CAD/Common/odrive/C59.iam
CAD/Common/odrive/C6.iam
CAD/Common/odrive/C60.iam
CAD/Common/odrive/C61.iam
CAD/Common/odrive/C62.iam
CAD/Common/odrive/C63.iam
CAD/Common/odrive/C64.iam
CAD/Common/odrive/C65.iam
CAD/Common/odrive/C66.iam
CAD/Common/odrive/C67.iam
CAD/Common/odrive/C68.iam
CAD/Common/odrive/C69.iam
CAD/Common/odrive/C7.iam
CAD/Common/odrive/C8.iam
CAD/Common/odrive/C9.iam
CAD/Common/odrive/CAP_Alum_Elec_Size_G.ipt
CAD/Common/odrive/Cylinder.ipt
CAD/Common/odrive/Cylinder_1.ipt
CAD/Common/odrive/Cylinder_2.ipt
CAD/Common/odrive/D1.iam
CAD/Common/odrive/D2.iam
CAD/Common/odrive/DFN5x6_SO8FL.iam
CAD/Common/odrive/Extruded.ipt
CAD/Common/odrive/Extruded_1.ipt
CAD/Common/odrive/Extruded_10.ipt
CAD/Common/odrive/Extruded_11.ipt
CAD/Common/odrive/Extruded_12.ipt
CAD/Common/odrive/Extruded_13.ipt
CAD/Common/odrive/Extruded_14.ipt
CAD/Common/odrive/Extruded_15.ipt
CAD/Common/odrive/Extruded_16.ipt
CAD/Common/odrive/Extruded_17.ipt
CAD/Common/odrive/Extruded_18.ipt
CAD/Common/odrive/Extruded_19.ipt
CAD/Common/odrive/Extruded_2.ipt
CAD/Common/odrive/Extruded_3.ipt
CAD/Common/odrive/Extruded_4.ipt
CAD/Common/odrive/Extruded_5.ipt
CAD/Common/odrive/Extruded_6.ipt
CAD/Common/odrive/Extruded_7.ipt
CAD/Common/odrive/Extruded_8.ipt
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
