jochenalt/Lisbeth/schematics/master-board-master/documentation/masterboard_ordering_soldering.md

# Master Board Ordering and Preparation
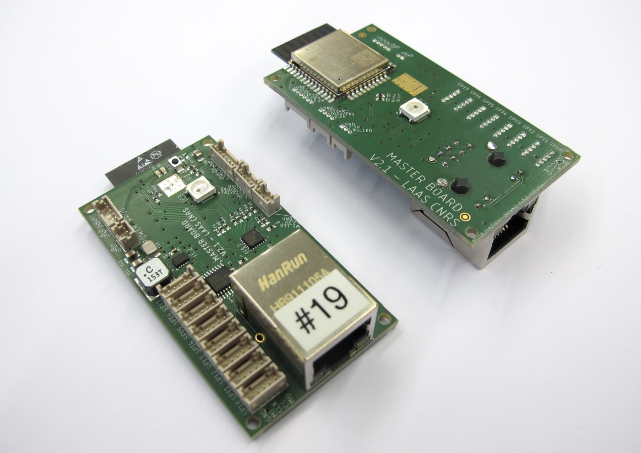
[picture p95: schematics/master-board-master/images/master_boards_assembled_2.jpg]
<br>

## Description
* Master Board v2
* communicates with up to 8 MicroDriver Boards via SPI
* controls up to 16 brushless motors at 1kHz
* collects the IMU data at 1kHz
* ethernet or wifi communication with control pc at 1kHz
* dimensions: 65mm x 35mm
* mounting holes: ø 2,1 / spacing 61mm x 31mm
* 2 layer board / FR4 1,6mm / copper thickness 35μm
* 2 x RGB NeoPixel status leds
* supply voltage: 5V - 30V
* weight: 19g

## Ordering Instructions
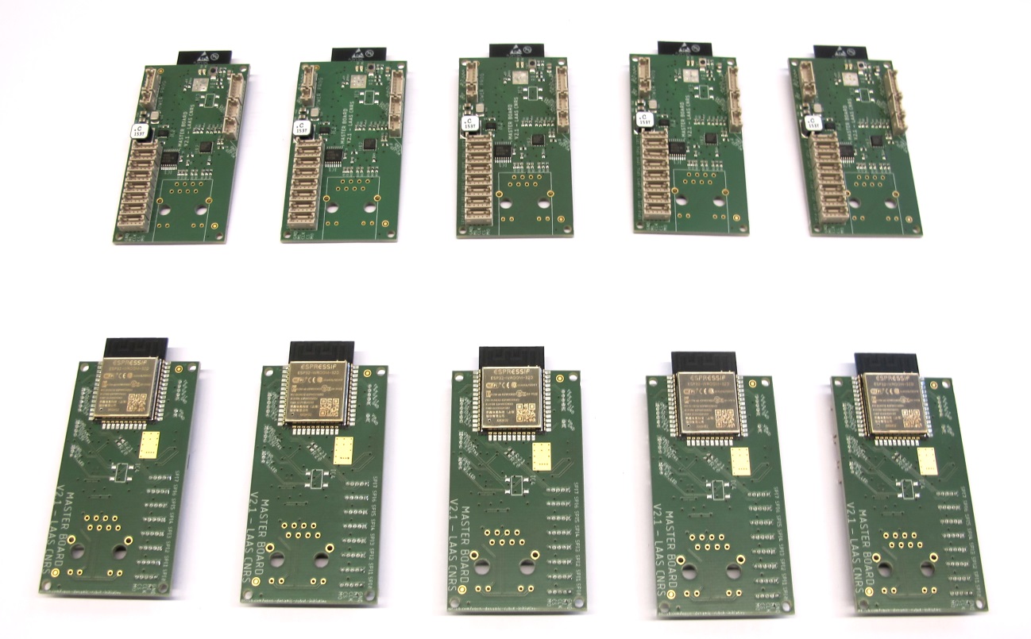
[picture p96: schematics/master-board-master/images/master_board_delivery_1.jpg]
<br>*Master Boards as delivered by BetaLayout.*<br>

We have been ordering the Master Boards from [BetaLayout](https://us.beta-layout.com/pcb/).
Beta Layout has the permission to replicate our MasterBoard v2 order for anybody who is interested - they ship worldwide.

Send an email to info.de@beta-layout.com and ask for a quote for replicating the Master Board v2 order according to the quote number **AN5eea24ae72697**. Specify the desired quantity and your location.

BetaLayout will send you a quote for producing the boards and for the placing and soldering service *- NOT including the cost of the electronic components.*

After you have placed the order for the boards Beta Layout will search for the components and will send you the component list with the actual component prices for your approval. For our last orders the component price was around 35€ per board.

We order the boards with all the components placed and soldered - except for the Ethernet jack and the NeoPixel leds. The soldering of those components is described [below](#preparing-the-master-board). The NeoPixel leds are very useful for visual status feedback but are not required to operate the Master Board.

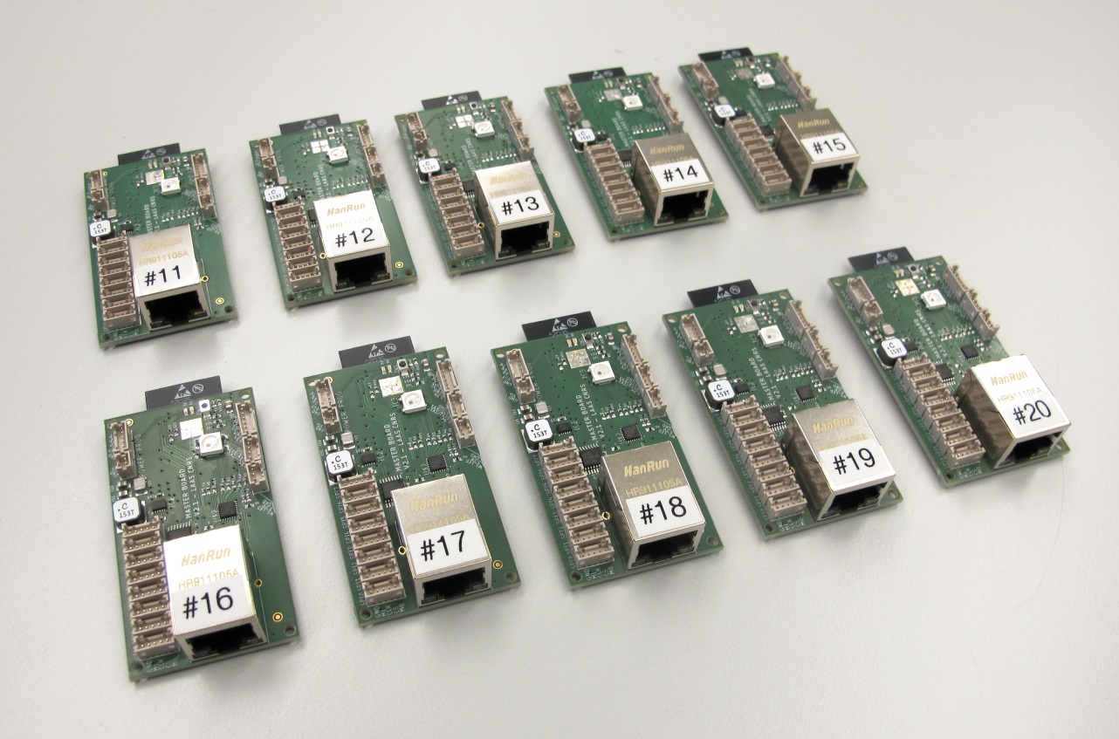
[picture p97: schematics/master-board-master/images/master_boards_assembled_1.jpg]
<br>*Fully prepared Master Boards.*<br>

## Required Components
|Description|Details|Ordering Information|Comments|
|---|---|---|---|
|MasterBoard v2|esp32_master_board.brd|[BetaLayout](https://us.beta-layout.com/pcb/)|[Ordering Instructions](#ordering-instructions)|
|Ethernet Jack|HanRun RJ45 HR911105A|[CSD Electronics](https://csd-electronics.de/Mechanical-Comp-/Connectors/Modular/Network/HanRun-RJ45-jack-HR911105A-2xLED::12367.html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)|CSD Electronics ships worldwide.|
|Neo Pixel Led|WS2818B LED SMD 5050 with WS2811 controller|[Amazon](https://www.amazon.de/-/en/Set-100-LED-5050-Ws2811-WS2812B-Controller/dp/B00KFOLQ5O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ück+led+rgb+smd+5050&qid=1611738540&sr=8-5)||

## Preparing the Master Board
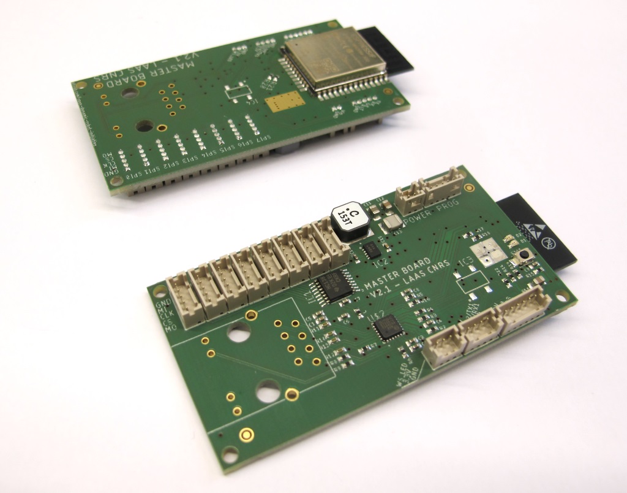
[picture p98: schematics/master-board-master/images/master_board_delivery_2.jpg]
<br>*Master Boards as delivered.*<br>

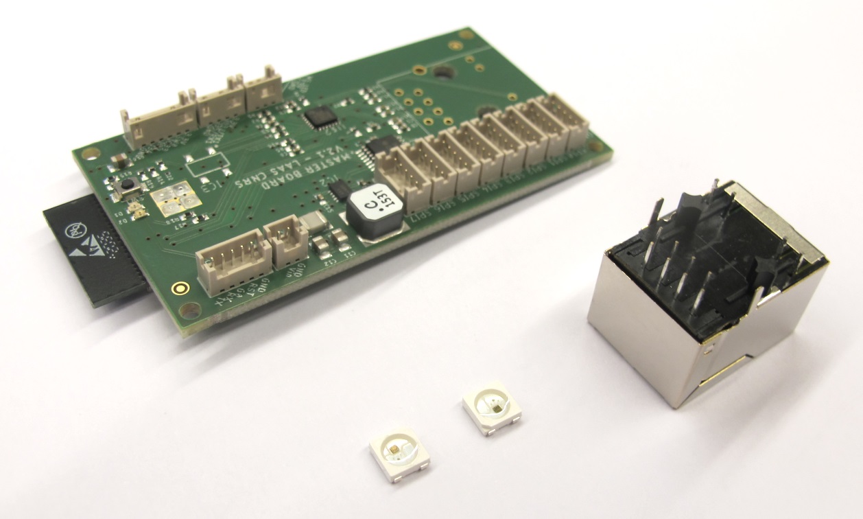
[picture p99: schematics/master-board-master/images/master_board_preparation_1.jpg]
<br>*Master Board, HanRun ethernet jack and NeoPixel leds.*<br>

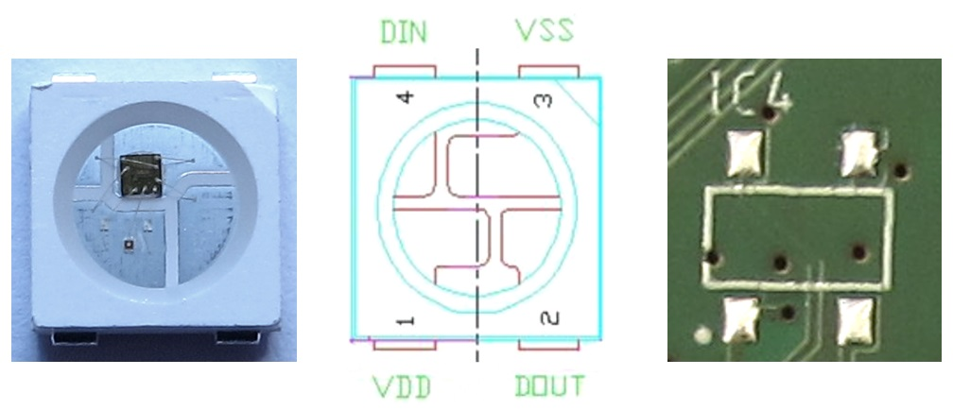
[picture p100: schematics/master-board-master/images/neo_pixel_pinout.jpg]
<br>*The NeoPixel package is unsusual and misleading.<br>The cut-off corner marks pin 3 instead of pin 1 as you might expect.<br>Pin 1 is marked with a dot on the Master Board. <br>Make sure that the cut-off corner is opposite of the dot as shown below.*<br>

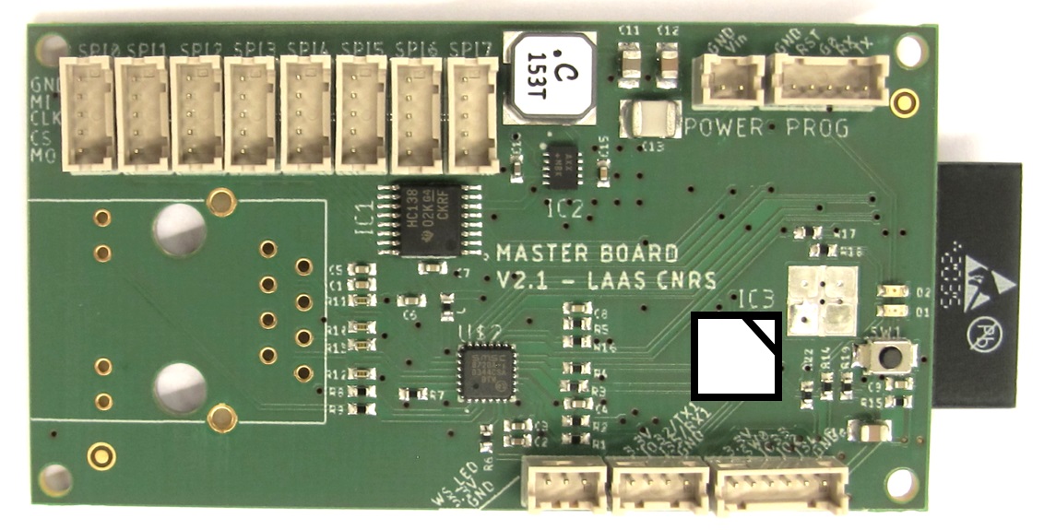
[picture p101: schematics/master-board-master/images/master_board_preparation_3.jpg]
<br>*NeoPixel led orientation - top side.*<br>

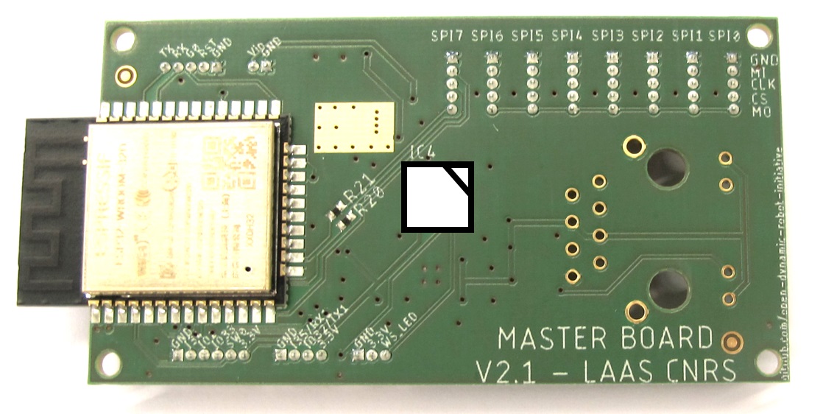
[picture p102: schematics/master-board-master/images/master_board_preparation_2.jpg]
<br>*NeoPixel led orientation - bottom side.*<br>

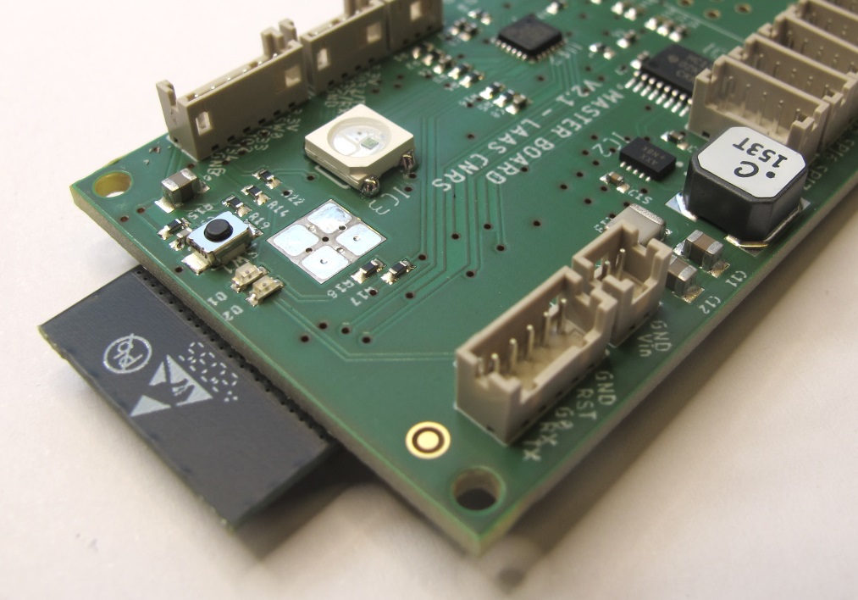
[picture p103: schematics/master-board-master/images/master_board_preparation_4.jpg]
<br>*Solder the NeoPixel led to the top side of the board.*<br>

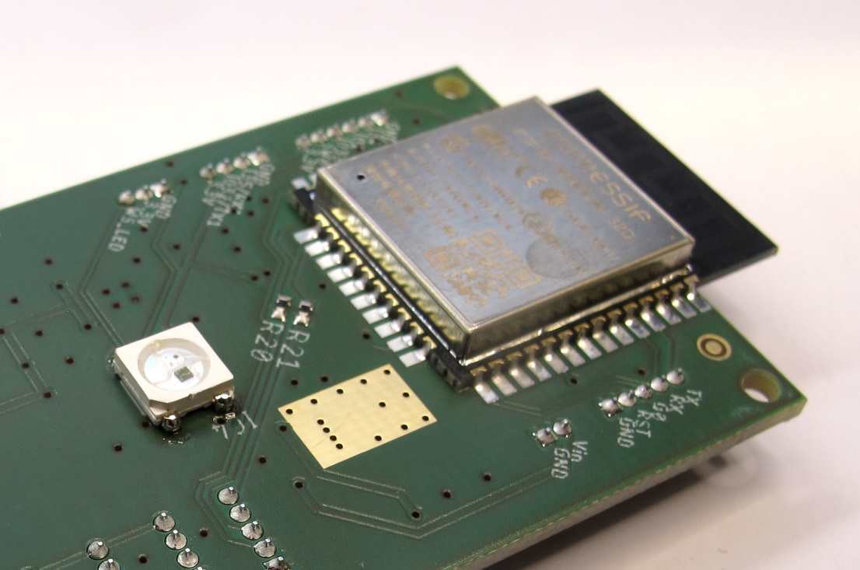
[picture p104: schematics/master-board-master/images/master_board_preparation_5.jpg]
<br>*Solder the second NeoPixel led to the bottom side of the board.*<br>

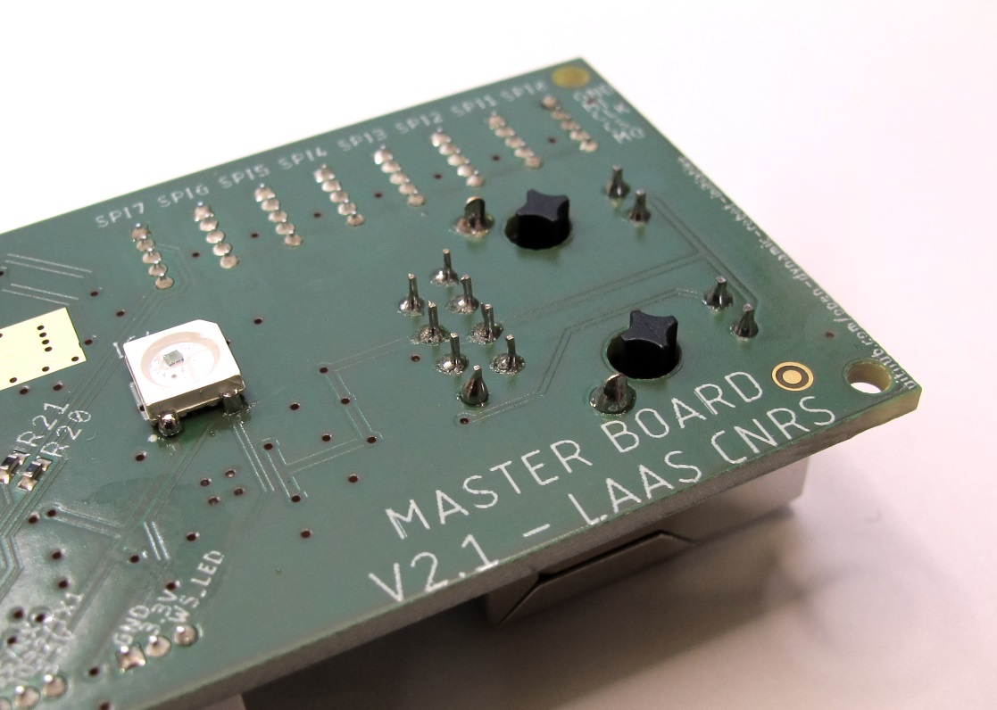
[picture p105: schematics/master-board-master/images/master_board_preparation_6.jpg]
<br>*Place the HanRun Ethernet Jack on the board.<br>Solder and shorten the pins.*<br>

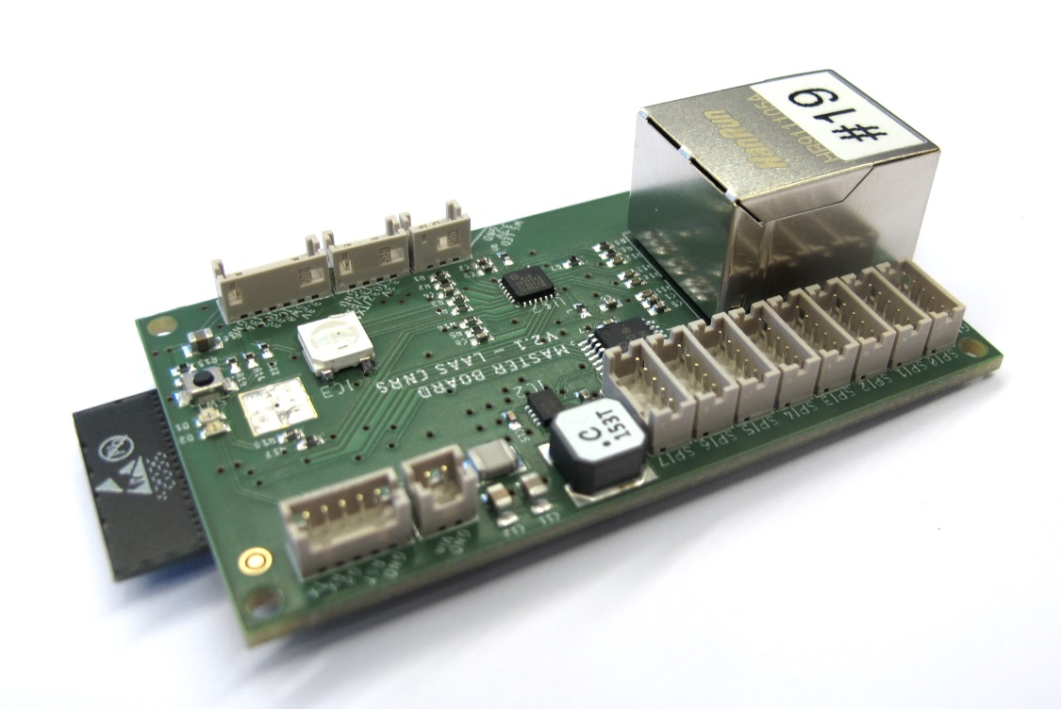
[picture p106: schematics/master-board-master/images/master_board_preparation_7.jpg]
<br>*The Master Board is now ready to be flashed and used.*<br>

---
## More Information
[Open Dynamic Robot Initiative - Webpage](https://open-dynamic-robot-initiative.github.io)<br>
[Open Dynamic Robot Initiative - YouTube Channel](https://www.youtube.com/channel/UCx32JW2oIrax47Gjq8zNI-w)<br>
[Open Dynamic Robot Initiative - Forum](https://odri.discourse.group/categories)<br>
[Open Dynamic Robot Initiative - Paper](https://arxiv.org/pdf/1910.00093.pdf)<br>
[Hardware Overview](https://github.com/open-dynamic-robot-initiative/open_robot_actuator_hardware#open-robot-actuator-hardware)<br>
[Software Overview](https://github.com/open-dynamic-robot-initiative/open-dynamic-robot-initiative.github.io/wiki)<br>

## Authors
Thomas Flayols<br>
Felix Grimminger

## License
BSD 3-Clause License

## Copyright
Copyright (c) 2019-2021, LAAS-CNRS, Max Planck Gesellschaft and New York University
