jochenalt/Lisbeth/schematics/Wiring.pptx

## Wiring Encoder

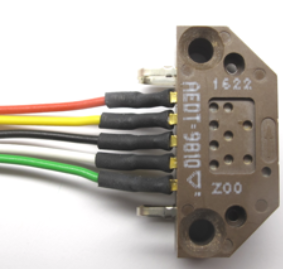
[picture p108: figure]
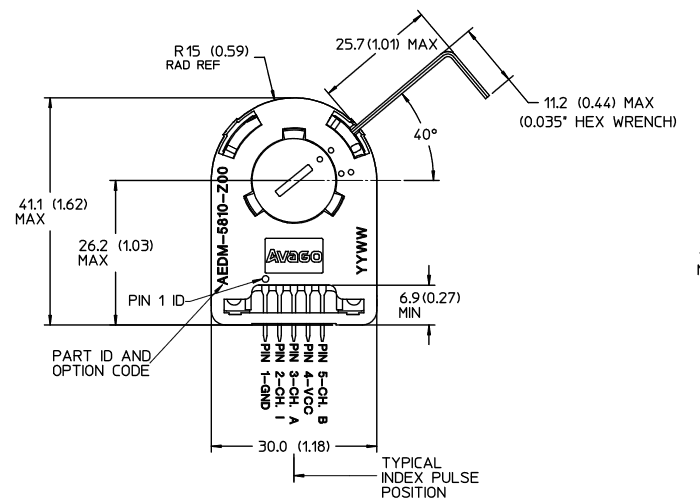
[picture p109: figure]

B

5V

A

I

GND

## Slide 2

Wiring IMU

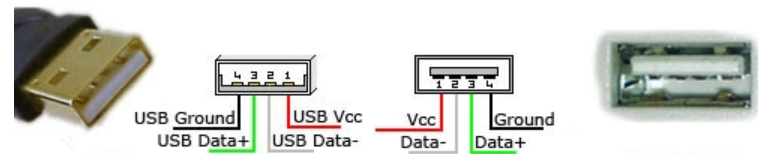
[picture p110: figure]

USB socket DB9 Cable
USB 1 = USB Vcc Pin 3 red
USB 2 = D- Pin 1 black
USB 3 = D+ Pin 2 brown
USB 4 = GND Pin 8 lilac
UART Host IMU
GND Pin 8 lilac GND
RX Pin 5 yellow TX
TX Pin 4 orange RX
Vcc Pin 3 red VCC

## Slide 3

Documentation
https://www.microstrain.com/inertial/3dm-gx3-25?qt-product_quicktab=2#qt-product_quicktab

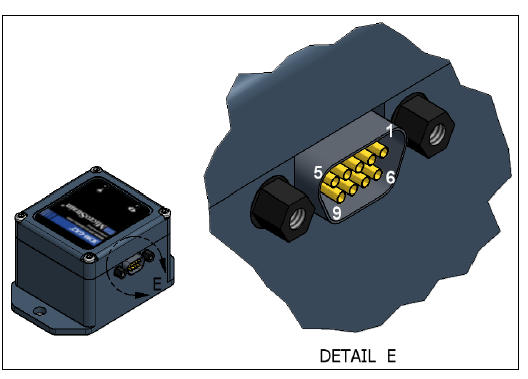
[picture p111: figure]

3.2-5.2V

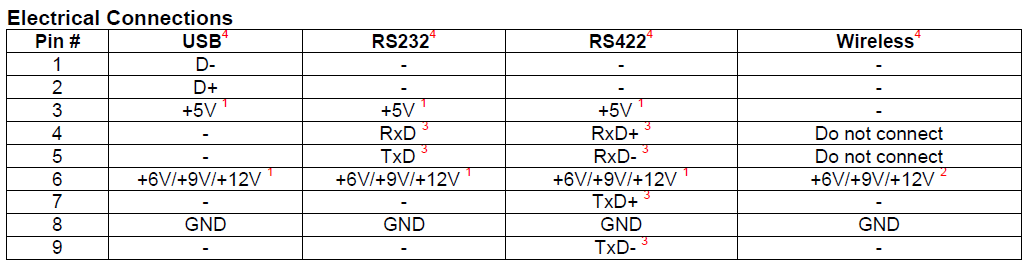
[picture p112: figure]

TX

RX

D+

D-

GND

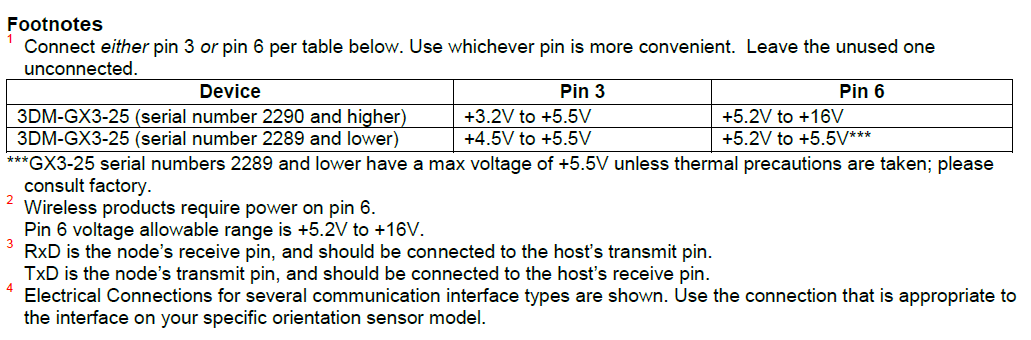
[picture p113: figure]

USB socket DB9 Cable
USB 1 = USB Vcc Pin 3 red
USB 2 = D- Pin 1 black
USB 3 = D+ Pin 2 brown
USB 4 = GND Pin 8 lilac
UART Host IMU
GND Pin 8 lilac GND
RX Pin 5 yellow TX
TX Pin 4 orange RX
Vcc Pin 3 red VCC

## Slide 4

https://www.sparkfun.com/products/11189

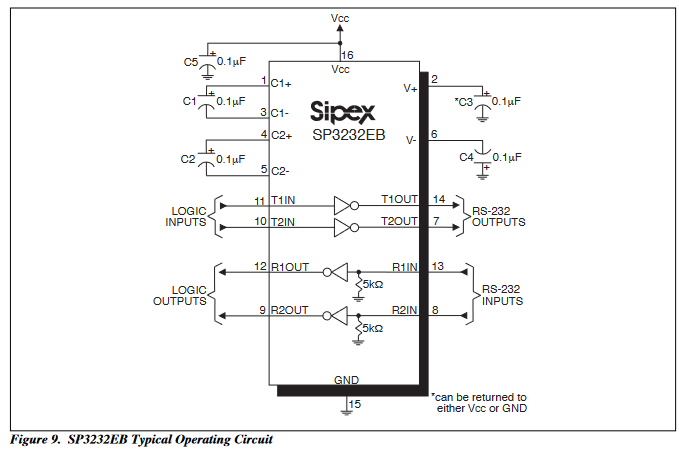
[picture p114: figure]
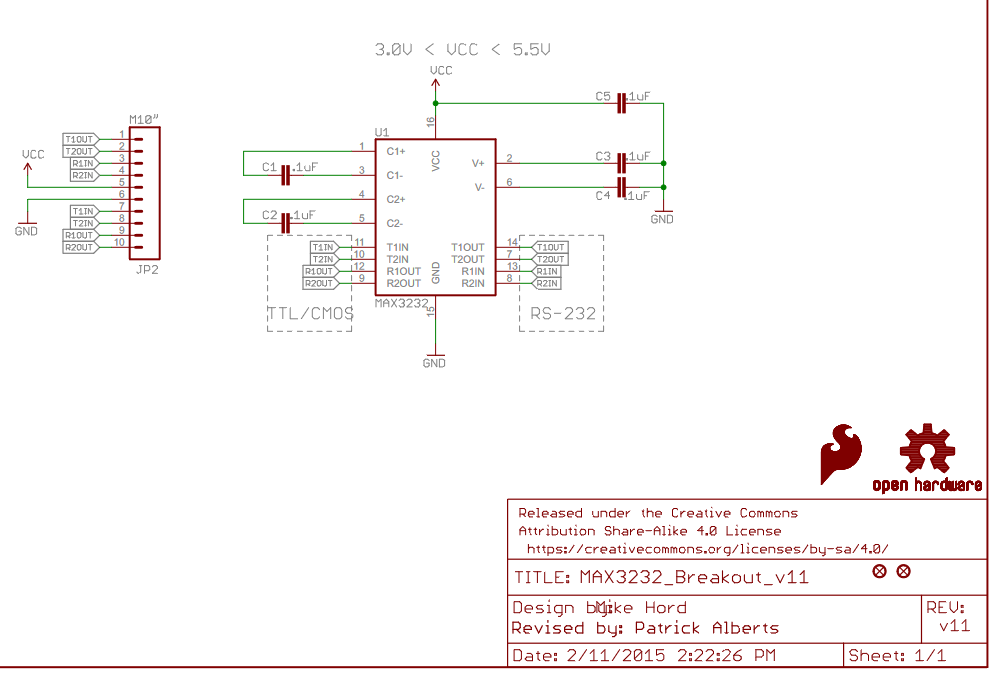
[picture p115: figure]
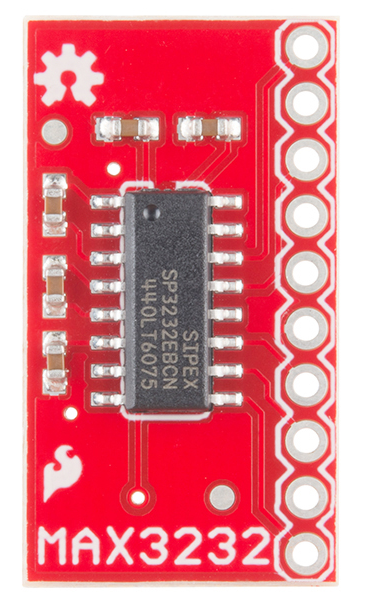
[picture p116: figure]
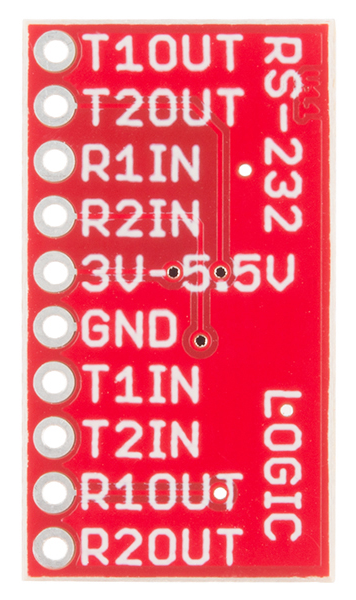
[picture p117: figure]

## Slide 5

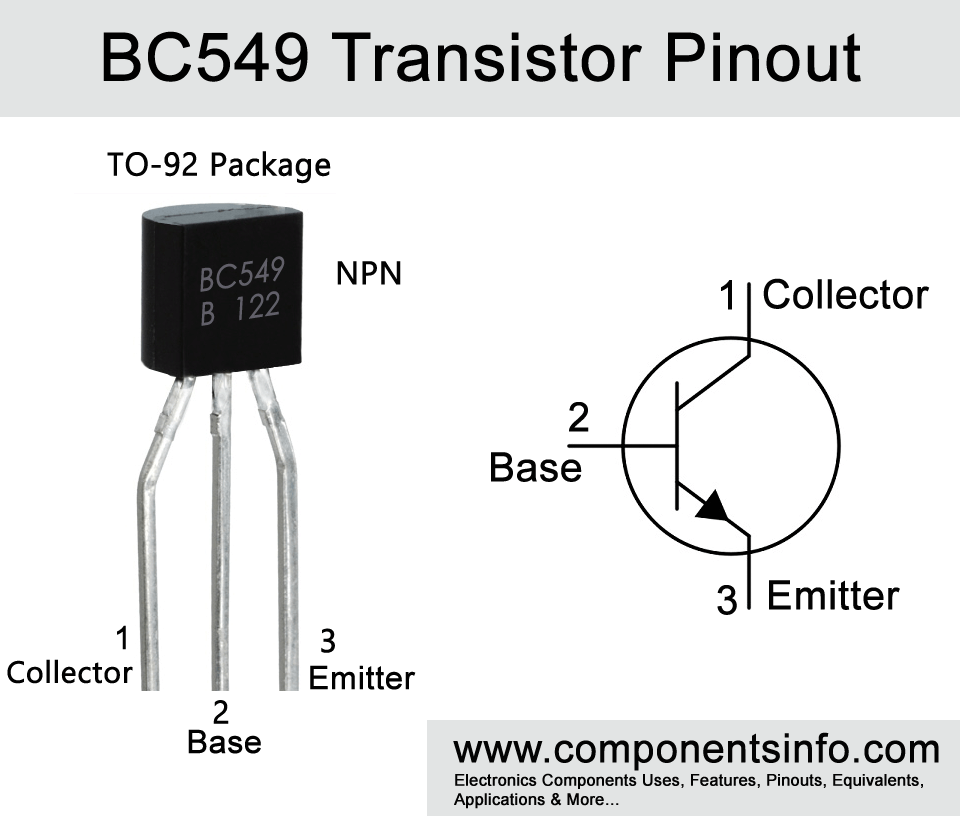
[picture p118: figure]
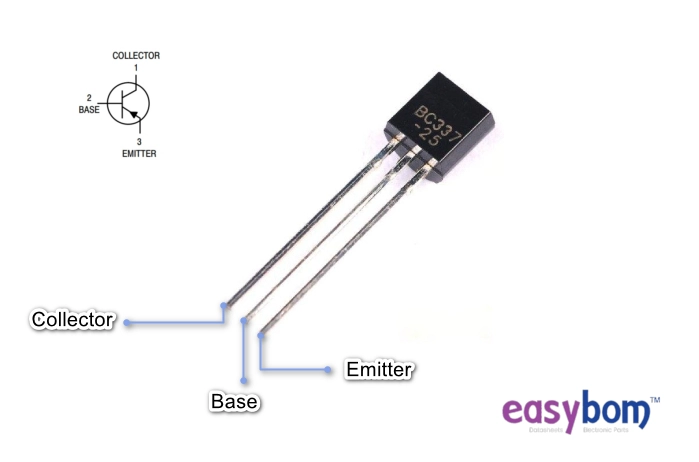
[picture p119: figure]

http://picprojects.org.uk/projects/simpleSIO/ssio.htm

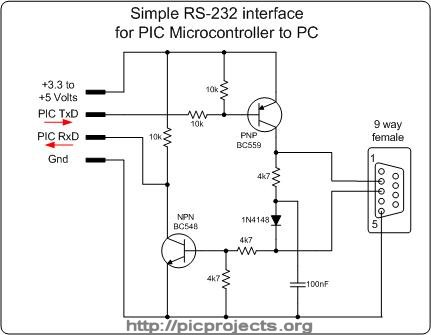
[picture p120: figure]
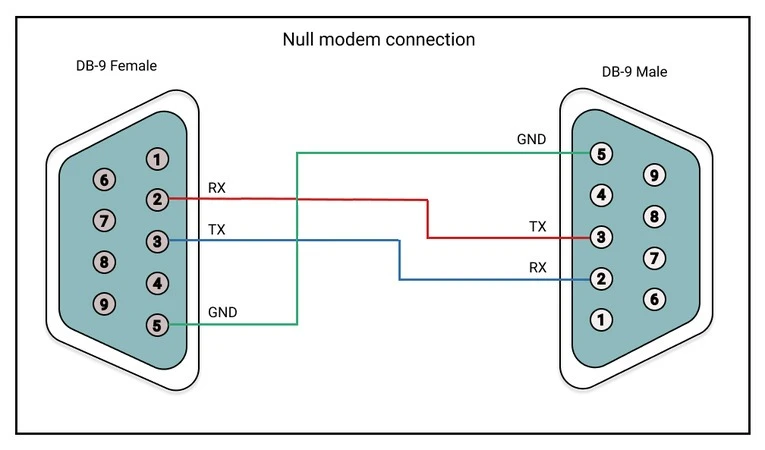
[picture p121: figure]

## Slide 6

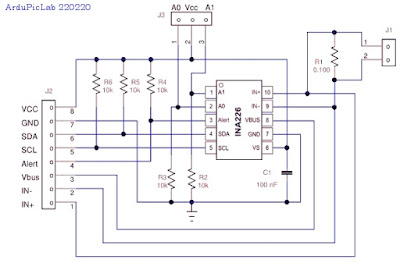
[picture p122: figure]
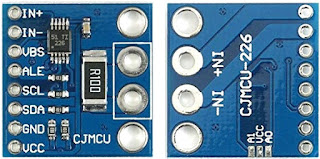
[picture p123: figure]

## Slide 7

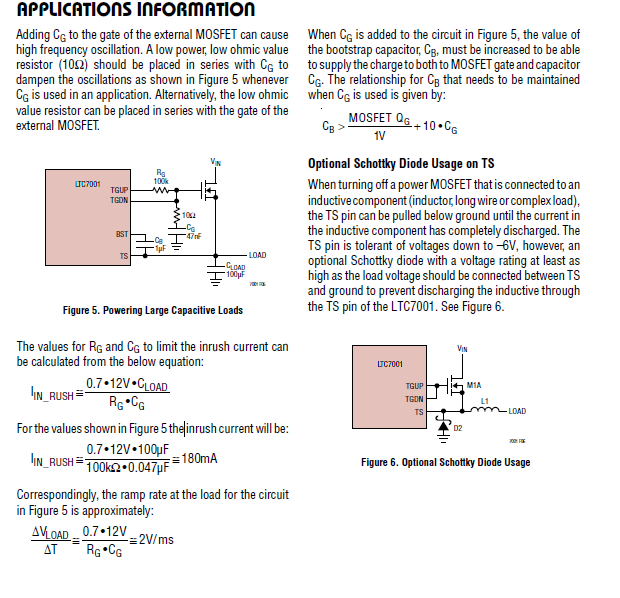
[picture p124: figure]

Cload = 6*2.2uF

CG = 47nF

RG = 22k

-> IIN_RUSH = 0.1 A

CB = 2.2uF

## Slide 8

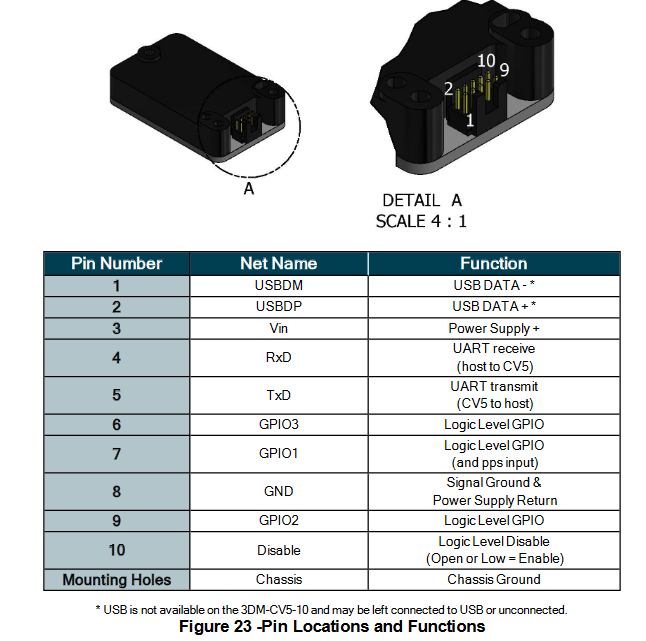
[picture p125: figure]
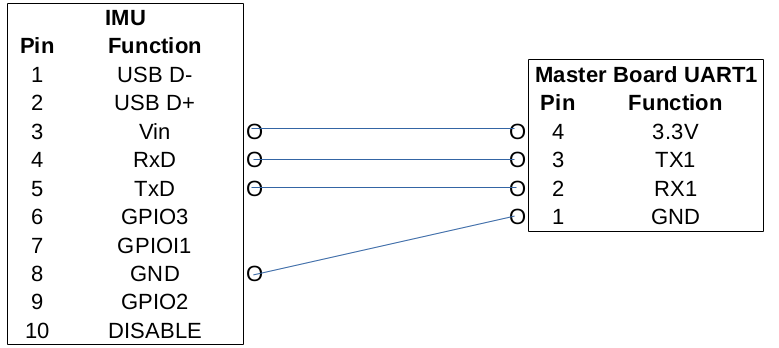
[picture p126: figure]

RX

GND

4

4

8

Disable

3

5

TX

3.2-5.2V

GND

## Slide 9

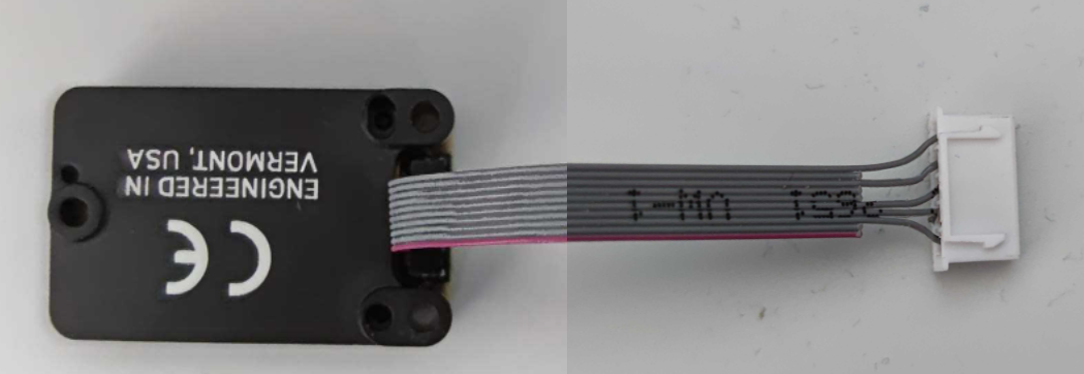
[picture p127: figure]

IMU PIN Function Teensy
10 5 Disable 32
8 4 GND GND
5 3 TxD RX7
4 2 RxD TX7
3 1 Vin 3.3V

## Slide 10

Acceleration

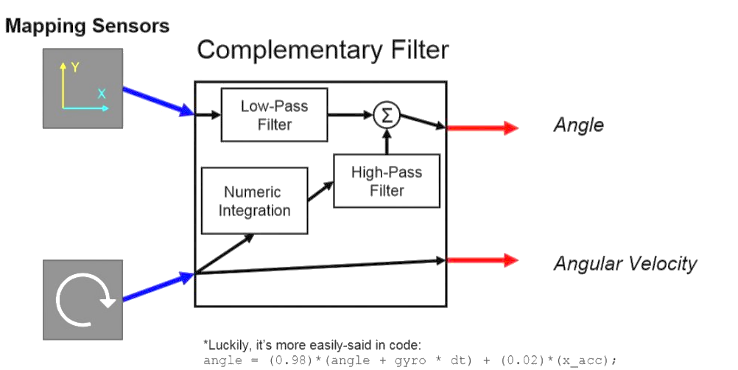
[picture p128: figure]

Angle

Gyro

Angular Rate

## Slide 11

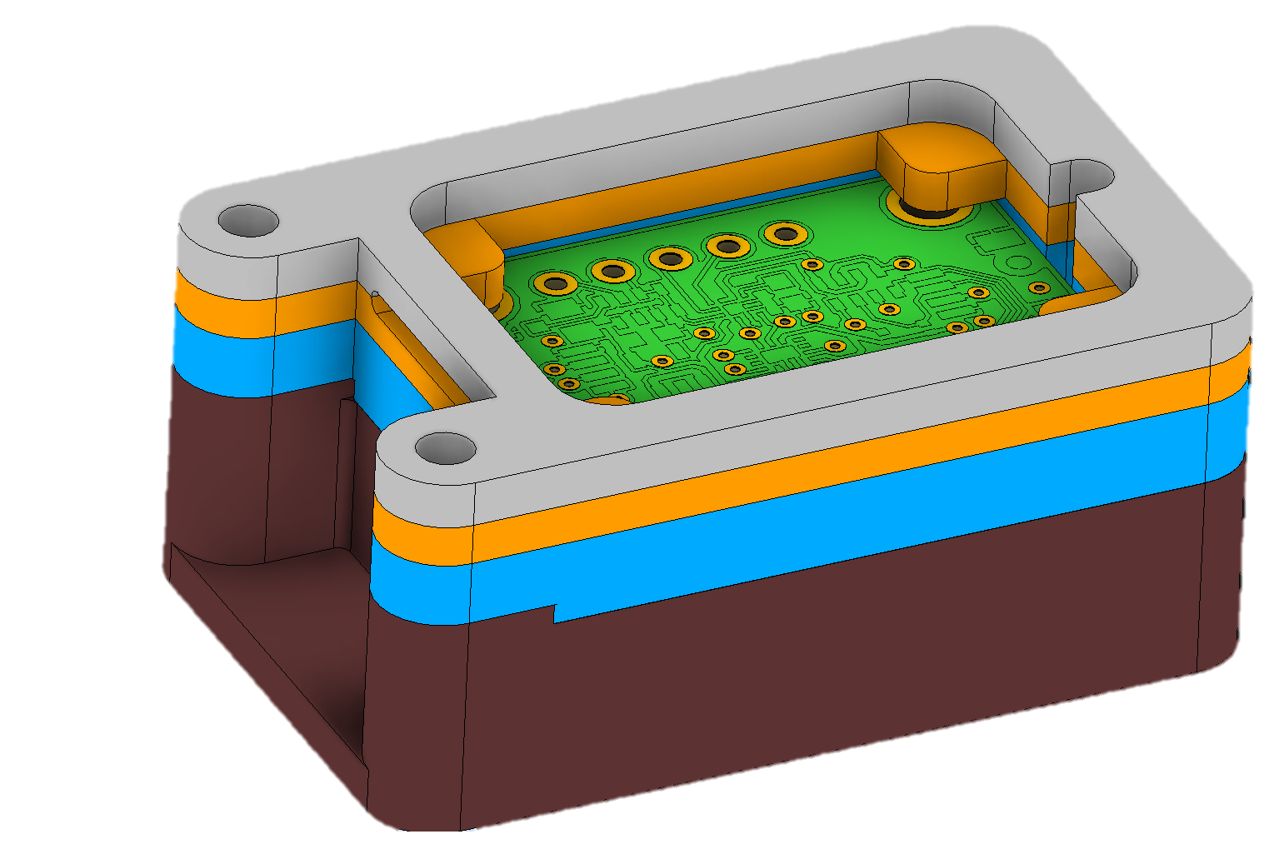
[picture p129: figure]

## Slide 12

IMU Manager

Microstrain

LIS3DM
