jochenalt/Lisbeth/CAD/Common/Up2/pcba-up2-85-56-106-05-18-heatsink.pdf

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

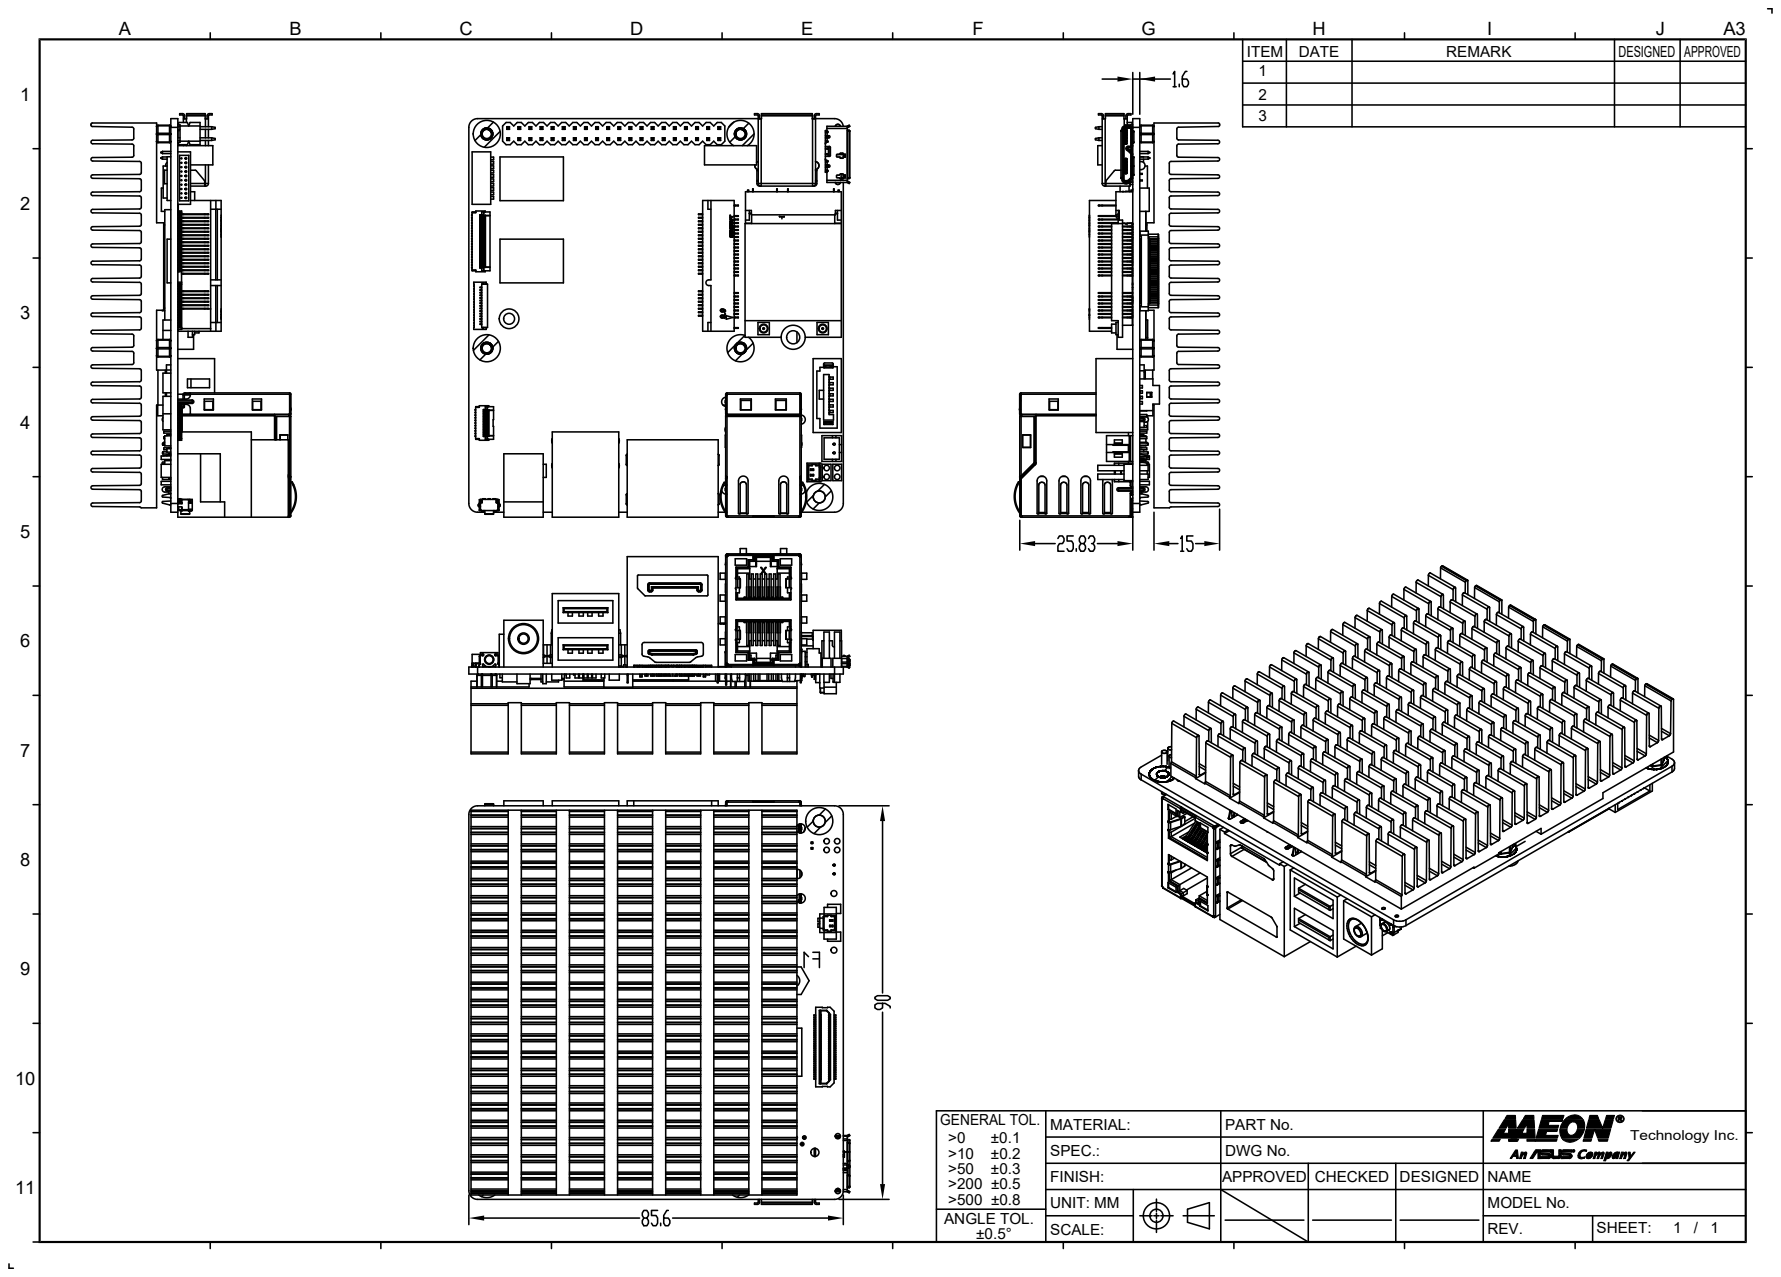
[picture p130: page 1]
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
