jochenalt/Lisbeth/schematics/cerebellar/cerebellar V1.2.brd

## EAGLE design schematics/cerebellar/cerebellar V1.2.brd (2022-07-31)

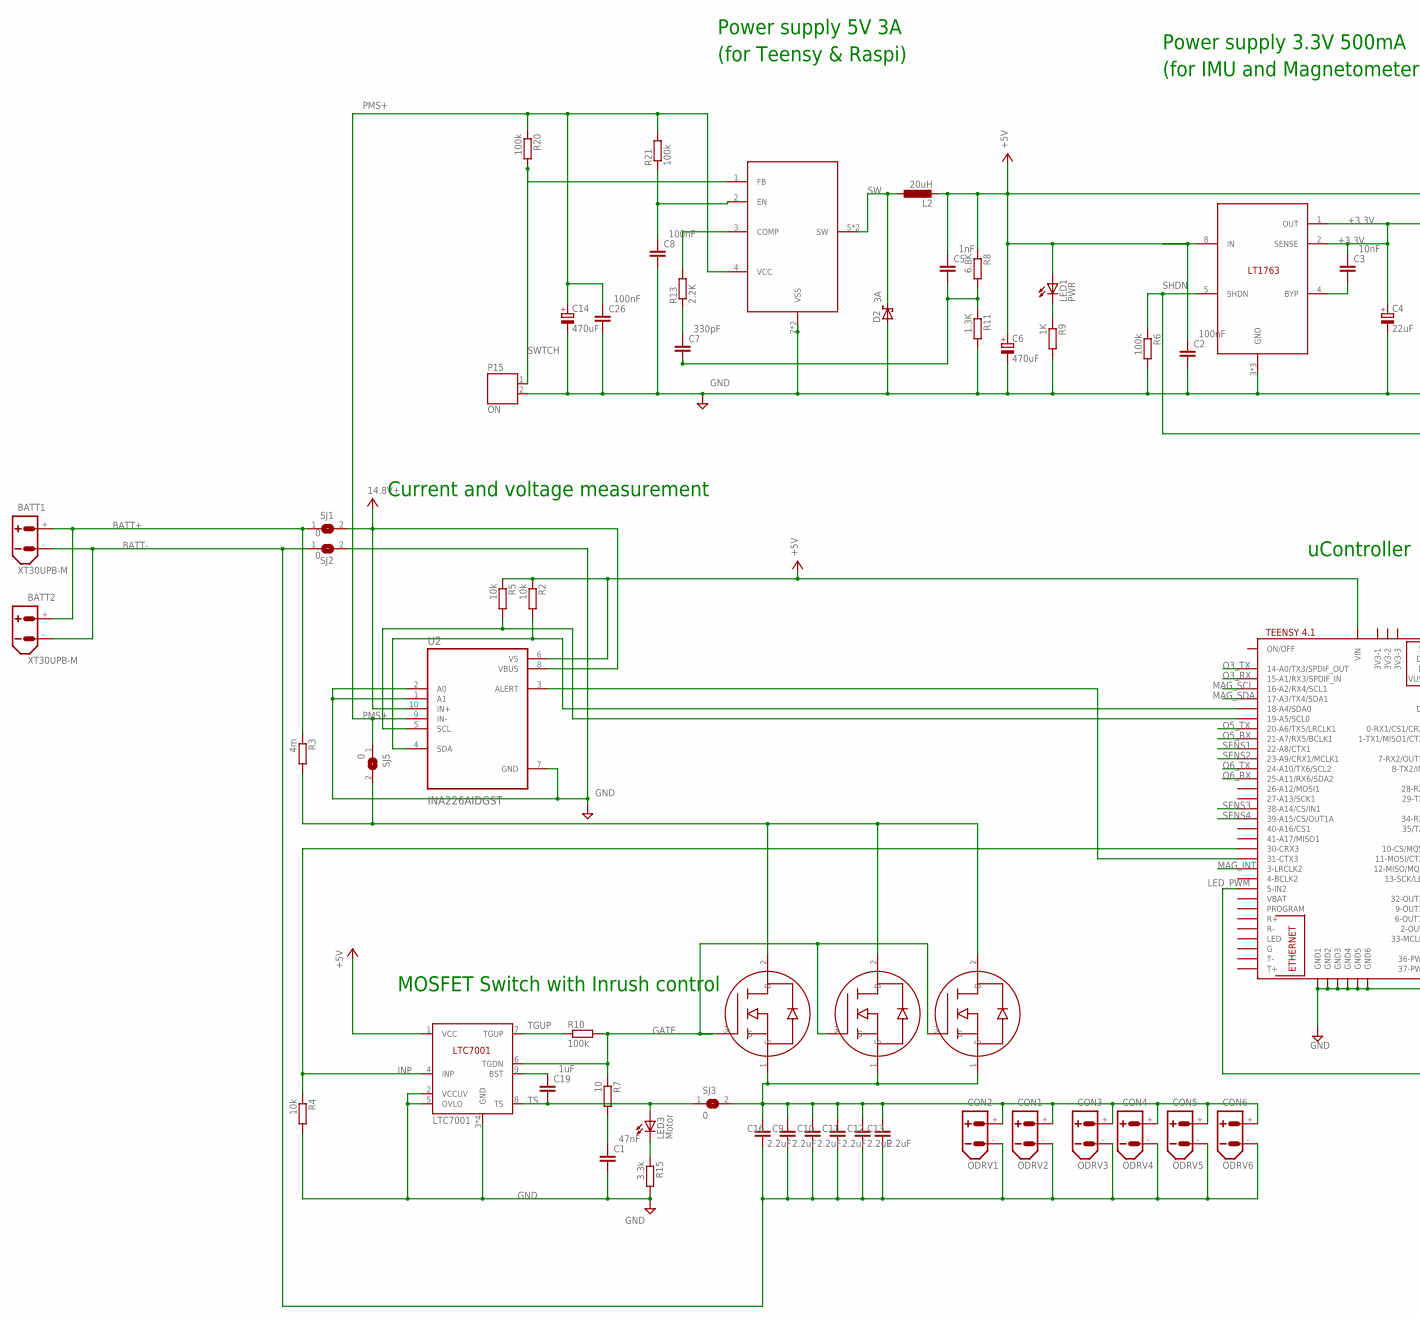
[picture p131: schematic cerebellar V1.2.sch, part in row 1, column 1]

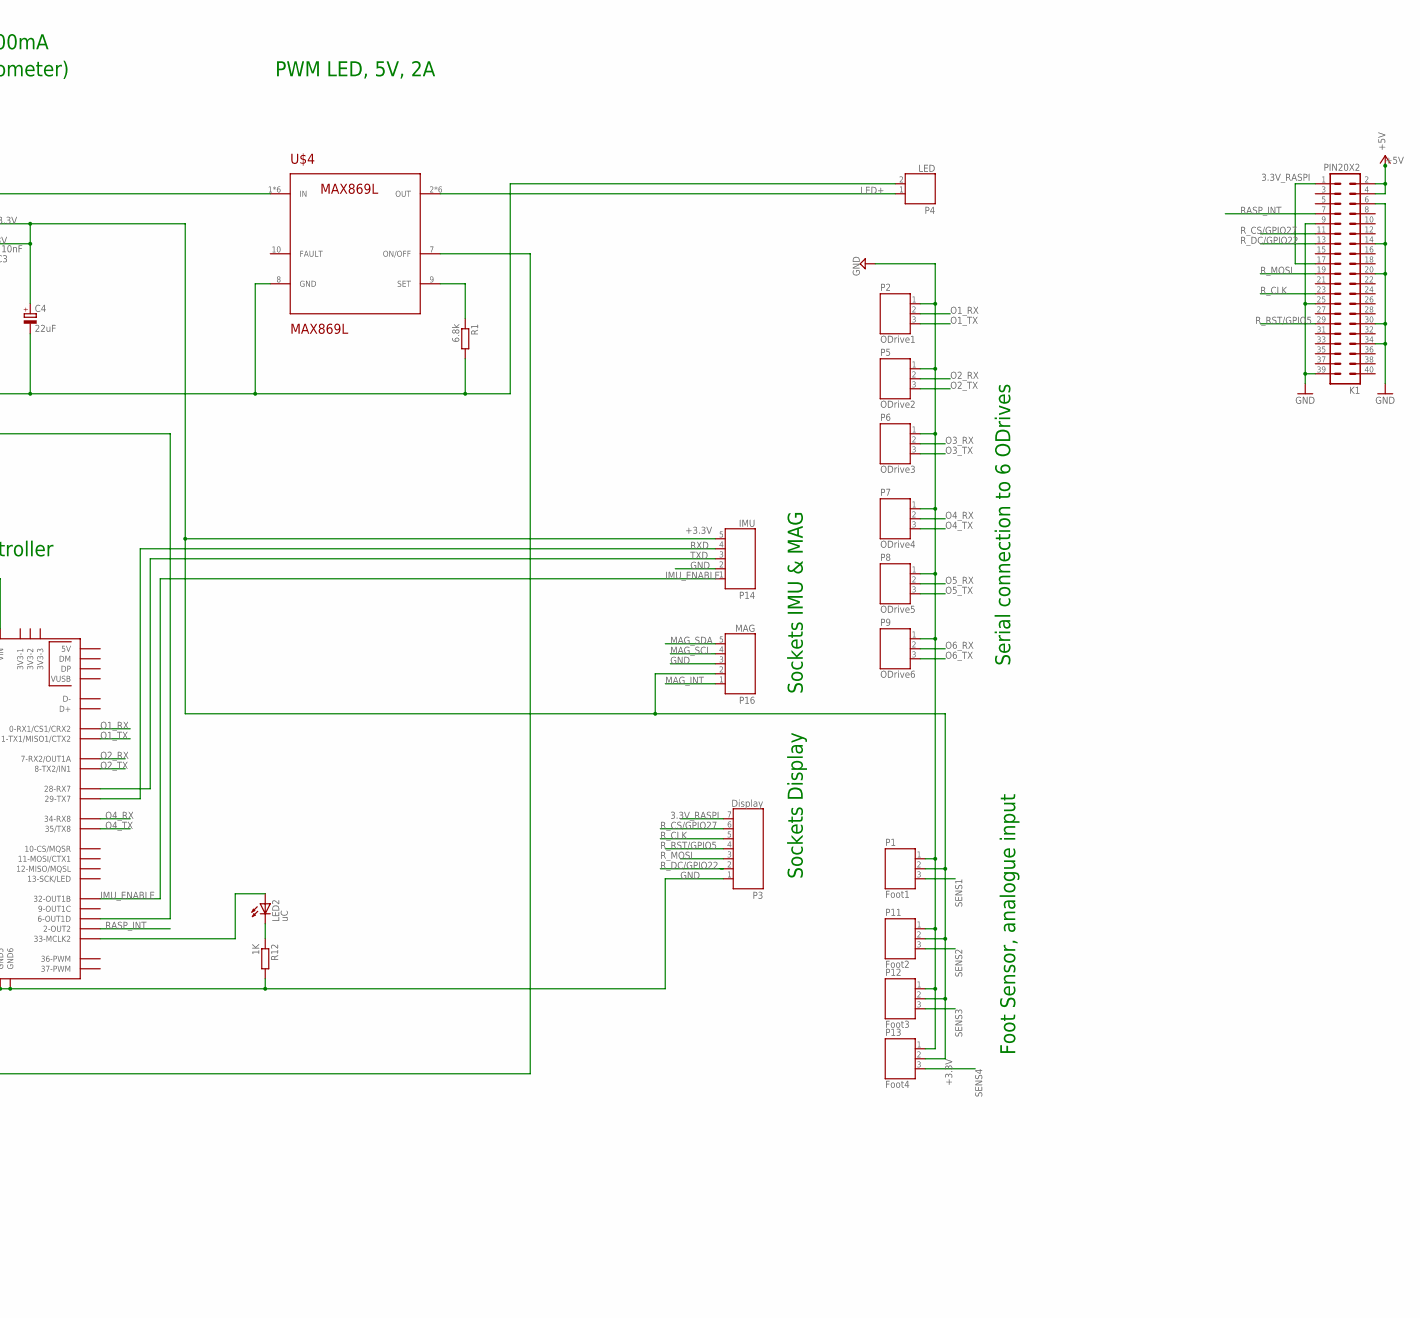
[picture p132: schematic cerebellar V1.2.sch, part in row 1, column 2]

Parts:
BATT1, BATT2: XT30UPB-M
C1: 47nF; C050-024X044
C2, C8, C26: 100nF; C050-024X044
C3: 10nF; C050-024X044
C4: 22uF; E2-4
C5: 1nF; C050-024X044
C6, C14: 470uF; E2,5-6
C7: 330pF; C050-024X044
C9, C10, C11, C12, C13, C16: 2.2uF; C050-024X044
C19: 1uF; C050-024X044
CON1: ODRV2; XT30UPB-F
CON2: ODRV1; XT30UPB-F
CON3: ODRV3; XT30UPB-F
CON4: ODRV4; XT30UPB-F
CON5: ODRV5; XT30UPB-F
CON6: ODRV6; XT30UPB-F
D2: 3A; DO41-10
IC3: LTC7001; MSOP10
K1: PIN20X2; PIN_20X2
L2: 20uH; IRF-3
LED1: PWR; LED3MM
LED2: uC; LED3MM
LED3: Motor; LED3MM
P1: Foot1; JST-PH3
P2: ODrive1; JST-PH3
P3: Display; JST-PH7
P4: LED; JST-PH2
P5: ODrive2; JST-PH3
P6: ODrive3; JST-PH3
P7: ODrive4; JST-PH3
P8: ODrive5; JST-PH3
P9: ODrive6; JST-PH3
P11: Foot2; JST-PH3
P12: Foot3; JST-PH3
P13: Foot4; JST-PH3
P14: IMU; JST-PH5
P15: ON; JST-PH2
P16: MAG; JST-PH5
R1: 6.8k; 0204/7
R2, R4, R5: 10k; 0204/7
R3: 4m; R2512; DIGIKEY 541-WSK25124L000FEACT-ND
R6, R10, R20, R21: 100k; 0204/7
R7: 10; 0204/7
R8: 6.8K; 0204/7
R9, R12: 1K; 0204/7
R11: 1.3K; 0204/7
R13: 2.2K; 0204/7
R15: 3.3k; 0204/7
SJ1, SJ2, SJ3, SJ5: 0; SJ
U2: INA226AIDGST; SOP50P490X110-10N
U$1: TEENSY41
U$2, U$3, U$5: IRF2804-BACK; TO-220H-BACK
U$4: MAX869L; TSSOP-16
U$6: TS2509; SO08
U$8: LT1763; SO08

Connections:
3.3V_RASPI: K1.1, K1.17, P3.7
+3.3V: C3.1, C4.+, P1.2, P11.2, P12.2, P13.2, P14.5, P16.2, U$8.1 (OUT), U$8.2 (SENSE)
+5V: C2.1, C5.1, C6.+, IC3.1 (VCC), K1.2, K1.4, L2.2, LED1.A, R2.1, R5.1, R8.1, U2.6 (VS), U$1.VIN, U$4.1 (IN), U$4.4 (IN), U$4.5 (IN), U$4.12 (IN), U$4.13 (IN), U$4.16 (IN), U$8.8 (IN)
BATT+: BATT1.+, BATT2.+, R3.1, SJ1.1
BATT-: BATT1.-, BATT2.-, C9.2, C10.2, C11.2, C12.2, C13.2, C16.2, CON1.-, CON2.-, CON3.-, CON4.-, CON5.-, CON6.-, SJ2.1
DRAIN: R3.2, SJ5.2, U$2.2 (D), U$3.2 (D), U$5.2 (D)
GATE: IC3.6 (TGDN), R7.1, R10.2, U$2.3 (G), U$3.3 (G), U$5.3 (G)
GND: C1.2, C2.2, C4.-, C6.-, C8.2, C14.-, C26.2, D2.A, IC3.2 (VCCUV), IC3.3 (GND), IC3.5 (OVLO), IC3.10 (GND), IC3.11 (GND), IC3.12 (GND), K1.6, K1.9, K1.14, K1.20, K1.25, K1.30, K1.34, K1.39, P1.1, P2.1, P3.1, P4.2, P5.1, P6.1, P7.1, P8.1, P9.1, P11.1, P12.1, P13.1, P14.2, P15.2, P16.3, R1.2, R4.2, R6.2, R9.2, R11.2, R12.2, R15.2, SJ2.2, U2.1 (A1), U2.2 (A0), U2.7 (GND), U$1.GND1, U$1.GND2, U$1.GND3, U$1.GND4, U$1.GND5, U$1.GND6, U$4.8 (GND), U$6.7 (VSS), U$6.8 (VSS), U$8.3 (GND), U$8.6 (GND), U$8.7 (GND)
IMU_ENABLE: P14.1, U$1.32-OUT1B
INP: IC3.4 (INP), R4.1, U$1.30-CRX3
LED+: P4.1, U$4.2 (OUT), U$4.3 (OUT), U$4.6 (OUT), U$4.11 (OUT), U$4.14 (OUT), U$4.15 (OUT)
LED_PWM: U$1.5-IN2, U$4.7 (ON/OFF)
MAG_INT: P16.1, U$1.3-LRCLK2
MAG_SCL: P16.4, U$1.16-A2/RX4/SCL1
MAG_SDA: P16.5, U$1.17-A3/TX4/SDA1
unnamed: C1.1, R7.2
unnamed: R1.1, U$4.9 (SET)
unnamed: LED2.K (C), R12.1
unnamed: LED2.A, U$1.33-MCLK2
unnamed: U2.3 (ALERT), U$1.31-CTX3
unnamed: C5.2, C7.2, R8.2, R11.1
unnamed: C3.2, U$8.4 (BYP)
unnamed: R13.2, U$6.3 (COMP)
unnamed: C7.1, R13.1
unnamed: R5.2, U2.5 (SCL), U$1.19-A5/SCL0
unnamed: R2.2, U2.4 (SDA), U$1.18-A4/SDA0
unnamed: C19.1, IC3.9 (BST)
unnamed: LED3.K (C), R15.1
unnamed: LED1.K (C), R9.1
unnamed: C8.1, R21.1, U$6.2 (EN)
O1_RX: P2.2, U$1.0-RX1/CS1/CRX2
O1_TX: P2.3, U$1.1-TX1/MISO1/CTX2
O2_RX: P5.2, U$1.7-RX2/OUT1A
O2_TX: P5.3, U$1.8-TX2/IN1
O3_RX: P6.2, U$1.15-A1/RX3/SPDIF_IN
O3_TX: P6.3, U$1.14-A0/TX3/SPDIF_OUT
O4_RX: P7.2, U$1.34-RX8
O4_TX: P7.3, U$1.35-TX8 (35/TX8)
O5_RX: P8.2, U$1.21-A7/RX5/BCLK1
O5_TX: P8.3, U$1.20-A6/TX5/LRCLK1
O6_RX: P9.2, U$1.25-A11/RX6/SDA2
O6_TX: P9.3, U$1.24-A10/TX6/SCL2
PMS+: C14.+, C26.1, R20.1, R21.2, SJ5.1, U2.9 (IN-), U$6.4 (VCC)
POWER+: C9.1, C10.1, C11.1, C12.1, C13.1, C16.1, CON1.+, CON2.+, CON3.+, CON4.+, CON5.+, CON6.+, SJ3.2, U$2.1 (S), U$3.1 (S), U$5.1 (S)
RASP_INT: K1.7, U$1.2-OUT2
RXD: P14.4, U$1.29-TX7
R_CLK: K1.23, P3.5
R_CS/GPIO27: K1.11, P3.6
R_DC/GPIO22: K1.13, P3.2
R_MOSI: K1.19, P3.3
R_RST/GPIO5: K1.29, P3.4
SENS1: P1.3, U$1.22-A8/CTX1
SENS2: P11.3, U$1.23-A9/CRX1/MCLK1
SENS3: P12.3, U$1.38-A14/CS/IN1
SENS4: P13.3, U$1.39-A15/CS/OUT1A
SHDN: R6.1, U$1.6-OUT1D, U$8.5 (SHDN)
SW: D2.C, L2.1, U$6.5 (SW), U$6.6 (SW)
SWTCH: P15.1, R20.2, U$6.1 (FB)
TGUP: IC3.7 (TGUP), R10.1
TS: C19.2, IC3.8 (TS), LED3.A, SJ3.1
TXD: P14.3, U$1.28-RX7
V+: SJ1.2, U2.8 (VBUS), U2.10 (IN+)

Notes on the sheet:
Foot Sensor, analogue input
Serial connection to 6 ODrives
Power supply 5V 3A (for Teensy & Raspi)
Current and voltage measurement
MOSFET Switch with Inrush control
uController
PWM LED, 5V, 2A
Power supply 3.3V 500mA (for IMU and Magnetometer)
Sockets IMU & MAG
Sockets Display

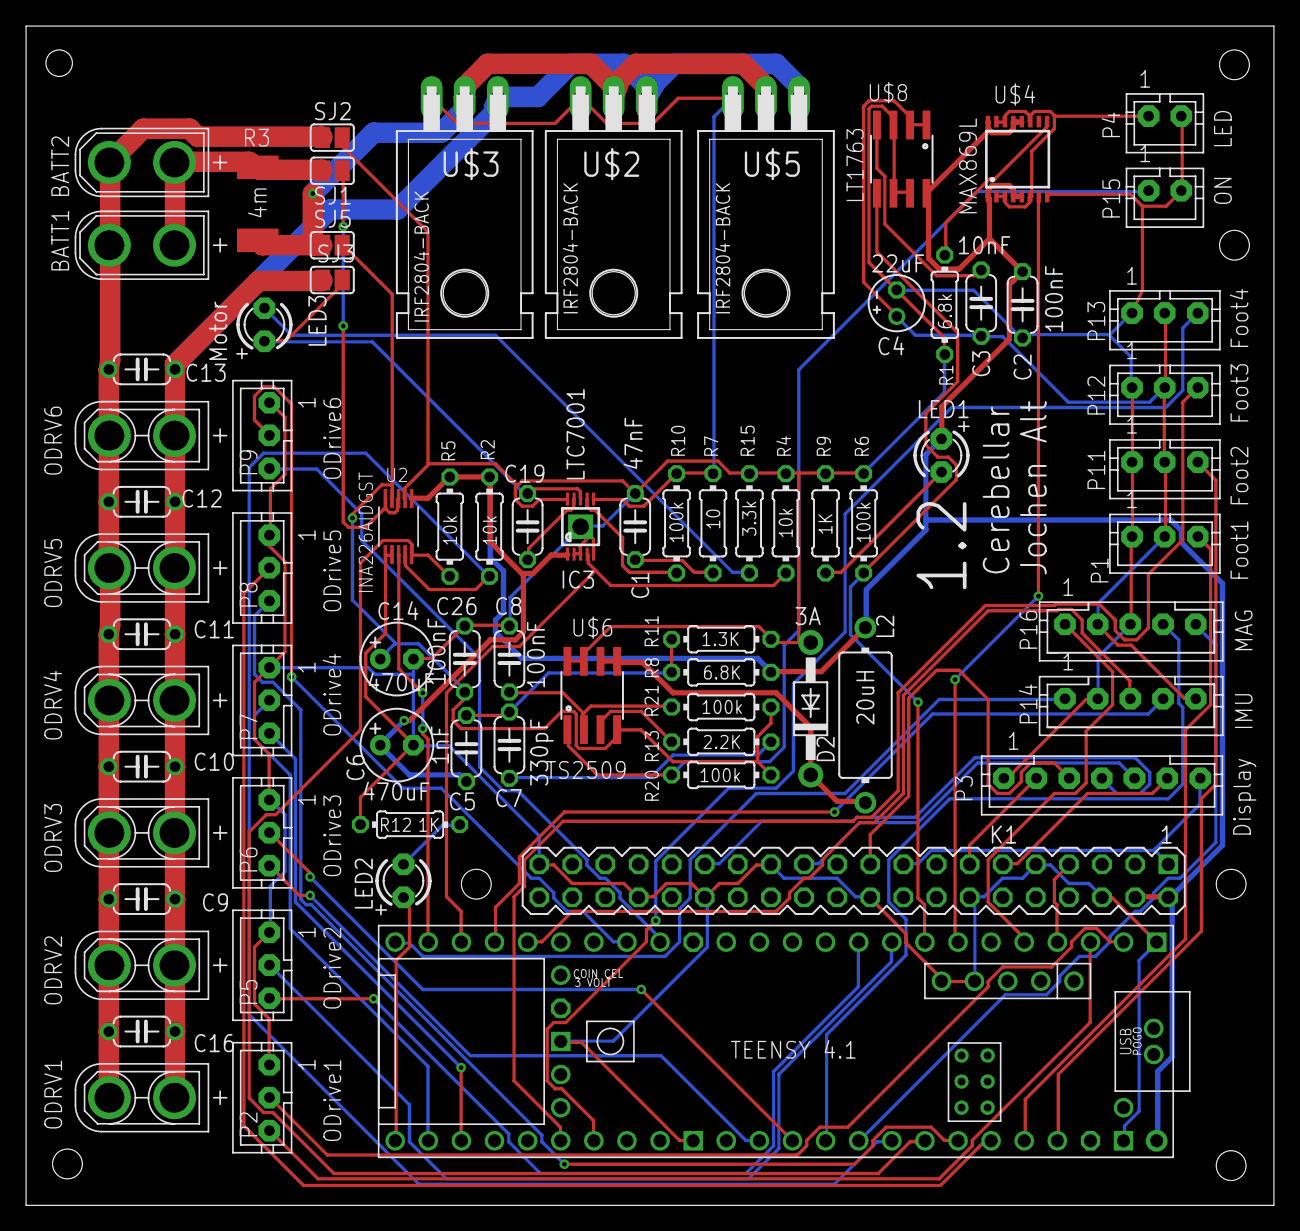
[picture p133: board cerebellar V1.2.brd from above]

Board: 2 copper layers, 95.7 x 90.5 mm, 75 parts (0 on the bottom side), 62 nets.
