jochenalt/Lisbeth/schematics/vestibular/vestibular.brd

## EAGLE design schematics/vestibular/vestibular.brd (2022-06-06)

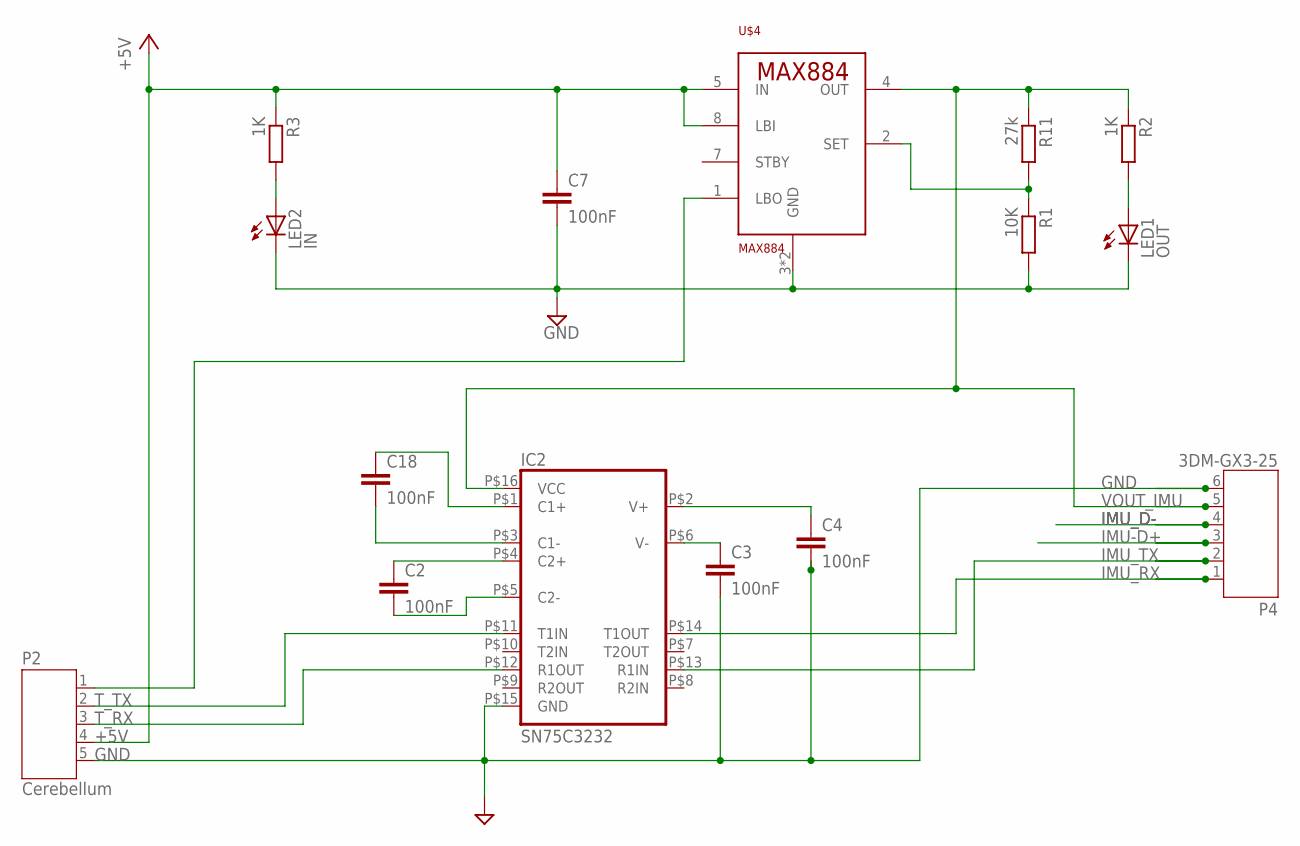
[picture p134: schematic vestibular.sch]

Parts:
C2, C3, C4, C7, C18: 100nF; C025-025X050
IC2: SN75C3232; SOIC16
LED1: OUT; LED3MM
LED2: IN; LED3MM
P2: Cerebellum; JST-PH5
P4: 3DM-GX3-25; JST-PH6
R1: 10K; 0204/7
R2, R3: 1K; 0204/7
R11: 27k; 0204/7
U$4: MAX884; SO08

Connections:
+5V: C7.1, P2.4, R3.1, U$4.5 (IN), U$4.8 (LBI)
GND: C3.2, C4.2, C7.2, IC2.P$15 (GND), LED1.K (C), LED2.K (C), P2.5, P4.6, R1.2, U$4.3 (GND), U$4.6 (GND)
IMU-D+: P4.3
IMU_D-: P4.4
IMU_RX: IC2.P$14 (T1OUT), P4.1
IMU_TX: IC2.P$13 (R1IN), P4.2
unnamed: LED1.A, R2.2
unnamed: LED2.A, R3.2
unnamed: C18.1, IC2.P$1 (C1+)
unnamed: P2.1, U$4.1 (LBO)
unnamed: C18.2, IC2.P$3 (C1-)
unnamed: R1.1, R11.2, U$4.2 (SET)
unnamed: C2.1, IC2.P$4 (C2+)
unnamed: C2.2, IC2.P$5 (C2-)
unnamed: C4.1, IC2.P$2 (V+)
unnamed: C3.1, IC2.P$6 (V-)
T_RX: IC2.P$12 (R1OUT), P2.3
T_TX: IC2.P$11 (T1IN), P2.2
VOUT_IMU: IC2.P$16 (VCC), P4.5, R2.1, R11.1, U$4.4 (OUT)

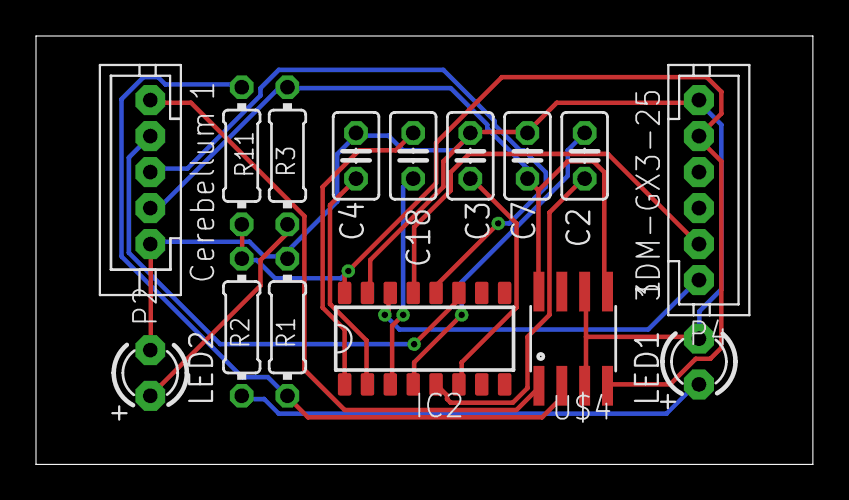
[picture p135: board vestibular.brd from above]

Board: 2 copper layers, 43.2 x 23.8 mm, 15 parts (0 on the bottom side), 17 nets.
