jochenalt/Lisbeth/schematics/master-board-master/hardware/V2/esp32_master_board.brd

## EAGLE design schematics/master-board-master/hardware/V2/esp32_master_board.brd (2022-05-15)

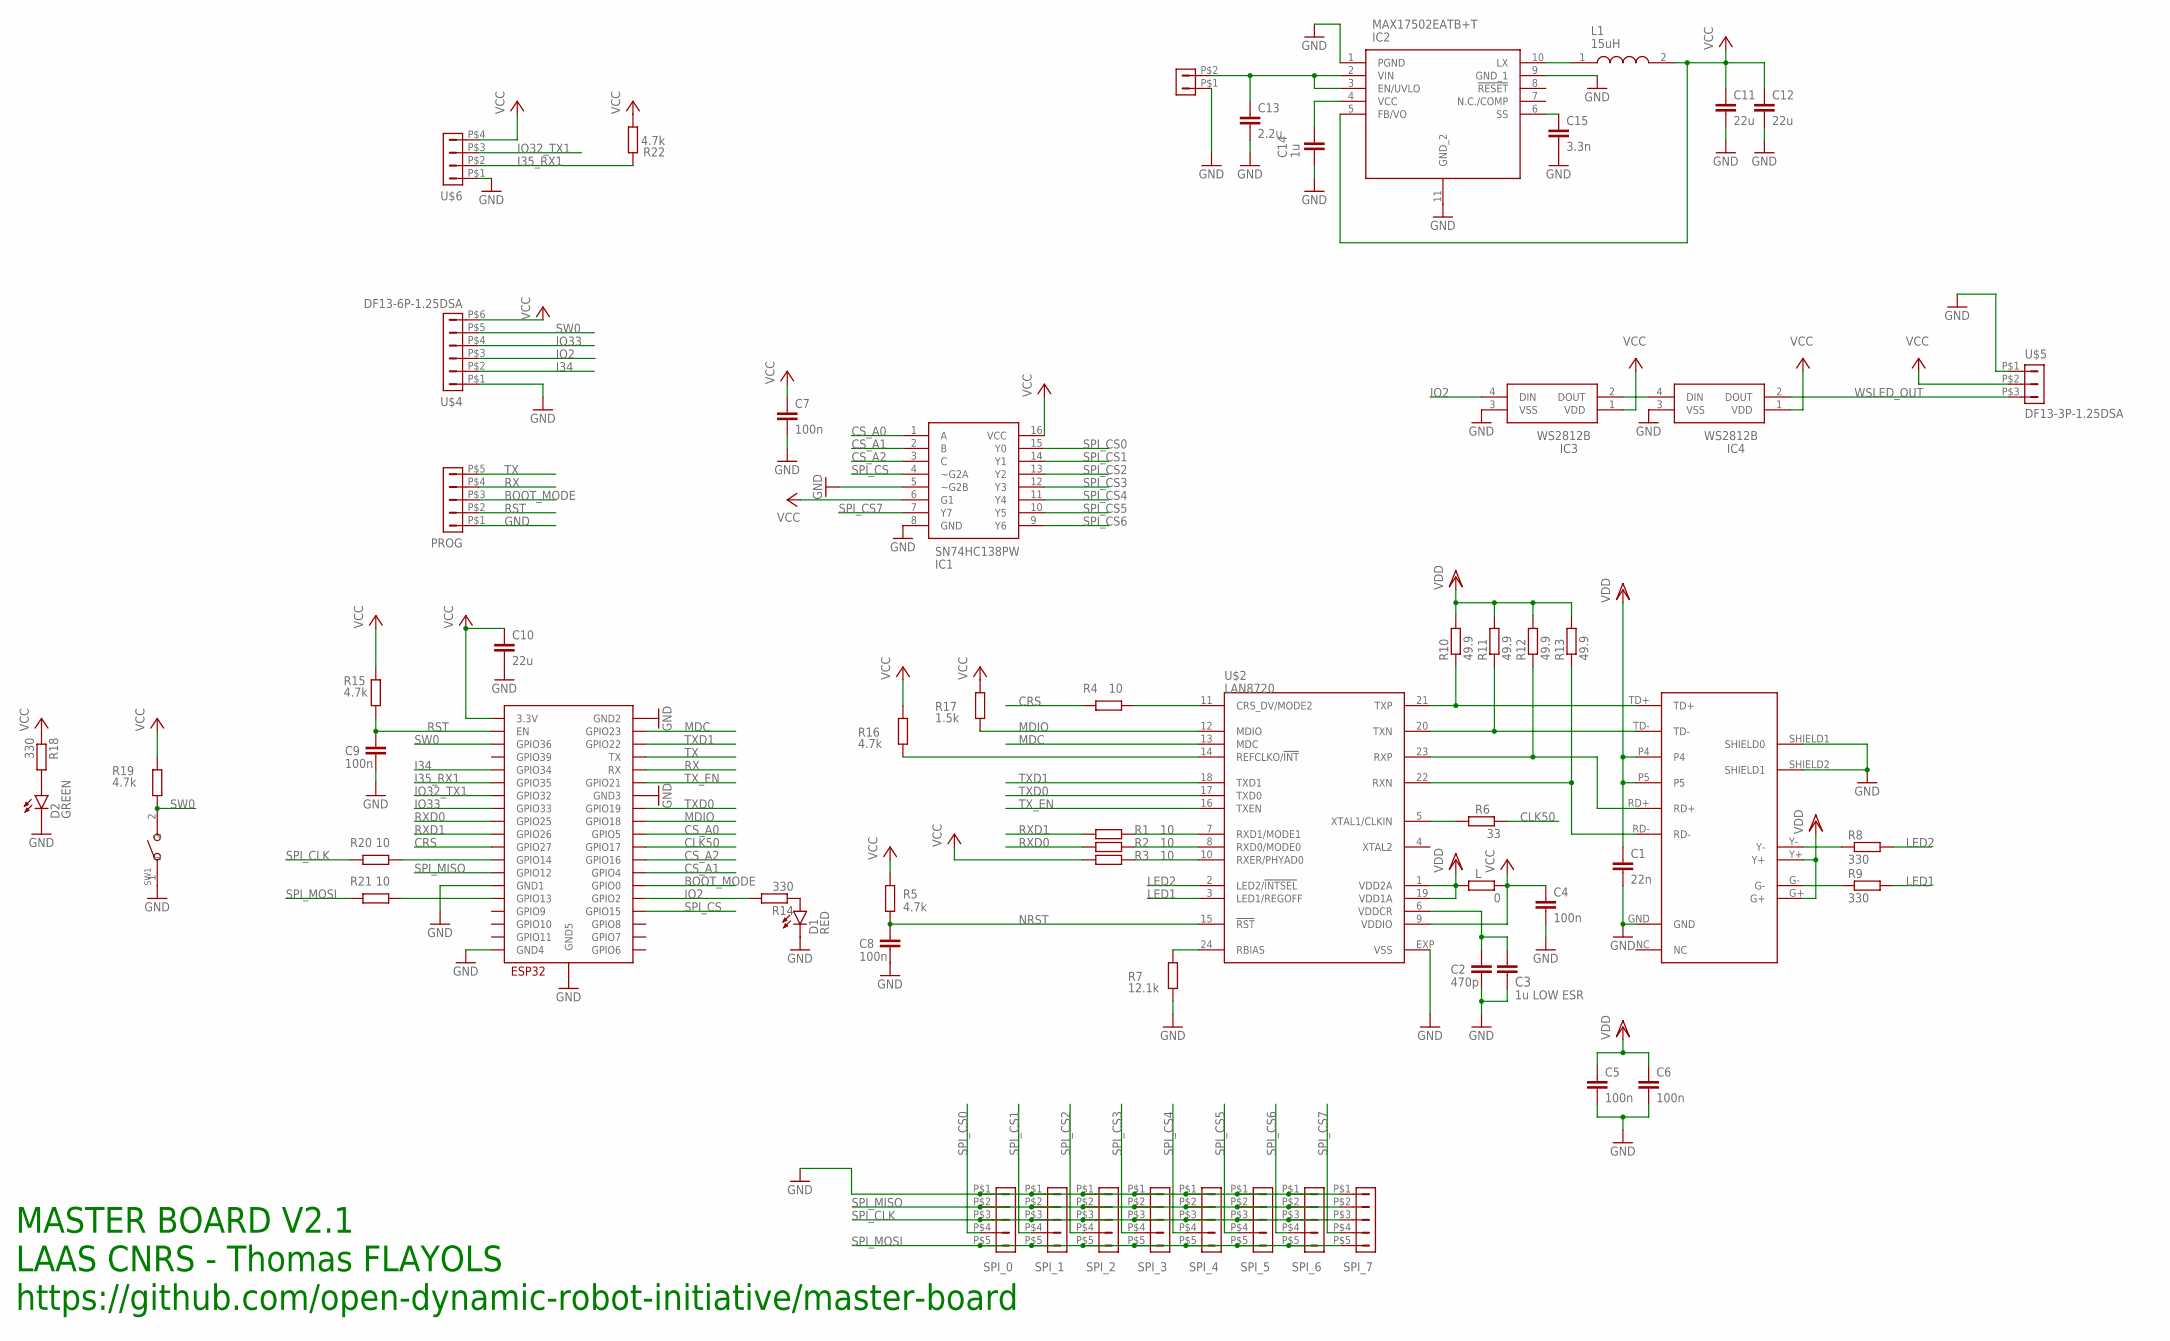
[picture p136: schematic esp32_master_board.sch]

Parts:
C1: 22n; C0402; MANUFACTURER_PART_NUMBER 885012205052
C2: 470p; C0402; MANUFACTURER_PART_NUMBER 0101ZC471KAT2A
C3: 1u LOW ESR; C0402; MANUFACTURER_PART_NUMBER CPL-CAP-X5R-0402-1UF-6.3V
C4, C5, C6, C7, C8, C9: 100n; C0402; MANUFACTURER_PART_NUMBER CPL-CAP-X7R-0402-100NF-16V
C10, C11, C12: 22u; C0805; MANUFACTURER_PART_NUMBER CPL-CAP-X5R-0805-22UF-6.3V
C13: 2.2u; C1210; MANUFACTURER_PART_NUMBER C3225X7R1H225K250AB
C14: 1u; C0402; MANUFACTURER_PART_NUMBER CPL-CAP-X5R-0402-1UF-6.3V
C15: 3.3n; C0402; MANUFACTURER_PART_NUMBER 885012205064
D1: RED; CHIPLED_0603; MANUFACTURER_PART_NUMBER CPL-LED-0603-RED
D2: GREEN; CHIPLED_0603; MANUFACTURER_PART_NUMBER CPL-LED-0603-GREEN
IC1: SN74HC138PW; SOP65P640X120-16N
IC2: MAX17502EATB+T; SON50P200X300X80-11N
IC3, IC4: WS2812B
L: 0; R0402; MANUFACTURER_PART_NUMBER CPL-RES-0402-0-0.063W
L1: 15uH; LPS6235
POWER: DF13-2P-1.25DSA; MANUFACTURER_PART_NUMBER DF13-3P-1.25DSA
PROG: DF13-5P-1.25DSA; MANUFACTURER_PART_NUMBER DF13-5P-1.25DSA
R1, R2, R3, R4, R20, R21: 10; R0402; MANUFACTURER_PART_NUMBER CPL-RES-0402-10-0.063W
R5, R15, R16, R19, R22: 4.7k; R0402; MANUFACTURER_PART_NUMBER CPL-RES-0402-4.7K-0.063W
R6: 33; R0402; MANUFACTURER_PART_NUMBER CRCW040233R0FKEDC
R7: 12.1k; R0402; MANUFACTURER_PART_NUMBER ERJ-U02F1212X
R8, R9, R14, R18: 330; R0402; MANUFACTURER_PART_NUMBER RC0402JR-13330RL
R10, R11, R12, R13: 49.9; R0402; MANUFACTURER_PART_NUMBER CRCW040249R9FKEDC
R17: 1.5k; R0402; MANUFACTURER_PART_NUMBER CPL-RES-0603-1.5K-0.1W
SPI_0, SPI_1, SPI_2, SPI_3, SPI_4, SPI_5, SPI_6, SPI_7: DF13-5P-1.25DSA; MANUFACTURER_PART_NUMBER DF13-5P-1.25DSA
SW1: B3U-1000P-2P-SMD; SW2-2.6-3.0X2.5X1.2+0.4MM; MANUFACTURER_PART_NUMBER B3U-1000P
U$1: ESP32-WROOM; MANUFACTURER_PART_NUMBER ESP32-WROOM-32D
U$2: LAN8720; QFN24; MANUFACTURER_PART_NUMBER LAN8720A-CP
U$3: HR911105A; RJ45; MANUFACTURER_PART_NUMBER HR911105A
U$4: DF13-6P-1.25DSA; MANUFACTURER_PART_NUMBER DF13-6P-1.25DSA
U$5: DF13-3P-1.25DSA; MANUFACTURER_PART_NUMBER DF13-3P-1.25DSA
U$6: DF13-4P-1.25DSA; MANUFACTURER_PART_NUMBER DF13-4P-1.25DSA

Connections:
BOOT_MODE: PROG.P$3 (3), U$1.IO0 (GPIO0)
CLK50: R6.1, U$1.IO17 (GPIO17)
CRS: R4.1, U$1.IO27 (GPIO27)
CS_A0: IC1.1 (A), U$1.IO5 (GPIO5)
CS_A1: IC1.2 (B), U$1.IO4 (GPIO4)
CS_A2: IC1.3 (C), U$1.IO16 (GPIO16)
GND: C1.2, C2.2, C3.2, C4.2, C5.2, C6.2, C7.2, C8.2, C9.2, C10.2, C11.2, C12.2, C13.2, C14.1, C15.2, D1.C, D2.C, IC1.5 (~G2B), IC1.8 (GND), IC2.1 (PGND), IC2.9 (GND_1), IC2.11 (GND_2), IC3.3 (VSS), IC4.3 (VSS), POWER.P$1 (1), PROG.P$1 (1), R7.1, SPI_0.P$1 (1), SPI_1.P$1 (1), SPI_2.P$1 (1), SPI_3.P$1 (1), SPI_4.P$1 (1), SPI_5.P$1 (1), SPI_6.P$1 (1), SPI_7.P$1 (1), SW1.1, U$1.GND1, U$1.GND2, U$1.GND3, U$1.GND4, U$1.GND5, U$2.EXP (VSS), U$3.GND, U$3.SHIELD1 (SHIELD0), U$3.SHIELD2 (SHIELD1), U$4.P$1 (1), U$5.P$1 (1), U$6.P$1 (1)
I34: U$1.IO34 (GPIO34), U$4.P$2 (2)
I35_RX1: R22.2, U$1.IO35 (GPIO35), U$6.P$2 (2)
IO2: IC3.4 (DIN), R14.2, U$1.IO2 (GPIO2), U$4.P$3 (3)
IO32_TX1: U$1.IO32 (GPIO32), U$6.P$3 (3)
IO33: U$1.IO33 (GPIO33), U$4.P$4 (4)
LED1: R9.2, U$2.3 (LED1/REGOFF)
LED2: R8.2, U$2.2 (LED2/!INTSEL)
MDC: U$1.IO23 (GPIO23), U$2.13 (MDC)
MDIO: R17.1, U$1.IO18 (GPIO18), U$2.12 (MDIO)
unnamed: R1.2, U$2.7 (RXD1/MODE1)
unnamed: R2.2, U$2.8 (RXD0/MODE0)
unnamed: R3.2, U$2.10 (RXER/PHYAD0)
unnamed: R4.2, U$2.11 (CRS_DV/MODE2)
unnamed: R6.2, U$2.5 (XTAL1/CLKIN)
unnamed: R7.2, U$2.24 (RBIAS)
unnamed: R10.1, U$2.21 (TXP), U$3.TD+
unnamed: R11.1, U$2.20 (TXN), U$3.TD-
unnamed: R12.1, U$2.23 (RXP), U$3.RD+
unnamed: R13.1, U$2.22 (RXN), U$3.RD-
unnamed: R8.1, U$3.Y-
unnamed: R9.1, U$3.G-
unnamed: R16.1, U$2.14 (REFCLKO/!INT)
unnamed: C2.1, C3.1, U$2.6 (VDDCR)
unnamed: C14.2, IC2.4 (VCC)
unnamed: D1.A, R14.1
unnamed: R21.2, U$1.IO13 (GPIO13)
unnamed: IC2.10 (LX), L1.1
unnamed: IC3.2 (DOUT), IC4.4 (DIN)
unnamed: D2.A, R18.2
unnamed: R20.2, U$1.IO14 (GPIO14)
unnamed: C15.1, IC2.6 (SS)
unnamed: C13.1, IC2.2 (VIN), IC2.3 (EN/UVLO), POWER.P$2 (2)
NRST: C8.1, R5.1, U$2.15 (!RST)
RST: C9.1, PROG.P$2 (2), R15.1, U$1.EN
RX: PROG.P$4 (4), U$1.RX
RXD0: R2.1, U$1.IO25 (GPIO25)
RXD1: R1.1, U$1.IO26 (GPIO26)
SPI_CLK: R20.1, SPI_0.P$3 (3), SPI_1.P$3 (3), SPI_2.P$3 (3), SPI_3.P$3 (3), SPI_4.P$3 (3), SPI_5.P$3 (3), SPI_6.P$3 (3), SPI_7.P$3 (3)
SPI_CS: IC1.4 (~G2A), U$1.IO15 (GPIO15)
SPI_CS0: IC1.15 (Y0), SPI_0.P$4 (4)
SPI_CS1: IC1.14 (Y1), SPI_1.P$4 (4)
SPI_CS2: IC1.13 (Y2), SPI_2.P$4 (4)
SPI_CS3: IC1.12 (Y3), SPI_3.P$4 (4)
SPI_CS4: IC1.11 (Y4), SPI_4.P$4 (4)
SPI_CS5: IC1.10 (Y5), SPI_5.P$4 (4)
SPI_CS6: IC1.9 (Y6), SPI_6.P$4 (4)
SPI_CS7: IC1.7 (Y7), SPI_7.P$4 (4)
SPI_MISO: SPI_0.P$2 (2), SPI_1.P$2 (2), SPI_2.P$2 (2), SPI_3.P$2 (2), SPI_4.P$2 (2), SPI_5.P$2 (2), SPI_6.P$2 (2), SPI_7.P$2 (2), U$1.IO12 (GPIO12)
SPI_MOSI: R21.1, SPI_0.P$5 (5), SPI_1.P$5 (5), SPI_2.P$5 (5), SPI_3.P$5 (5), SPI_4.P$5 (5), SPI_5.P$5 (5), SPI_6.P$5 (5), SPI_7.P$5 (5)
SW0: R19.1, SW1.2, U$1.SENSOR_VP (GPIO36), U$4.P$5 (5)
TX: PROG.P$5 (5), U$1.TX
TXD0: U$1.IO19 (GPIO19), U$2.17 (TXD0)
TXD1: U$1.IO22 (GPIO22), U$2.18 (TXD1)
TX_EN: U$1.IO21 (GPIO21), U$2.16 (TXEN)
VCC: C4.1, C7.1, C10.1, C11.1, C12.1, IC1.6 (G1), IC1.16 (VCC), IC2.5 (FB/VO), IC3.1 (VDD), IC4.1 (VDD), L.1, L1.2, R3.1, R5.2, R15.2, R16.2, R17.2, R18.1, R19.2, R22.1, U$1.3V3 (3.3V), U$2.9 (VDDIO), U$4.P$6 (6), U$5.P$2 (2), U$6.P$4 (4)
VDD: C1.1, C5.1, C6.1, L.2, R10.2, R11.2, R12.2, R13.2, U$2.1 (VDD2A), U$2.19 (VDD1A), U$3.G+, U$3.P4, U$3.P5, U$3.Y+
WSLED_OUT: IC4.2 (DOUT), U$5.P$3 (3)

Notes on the sheet:
MASTER BOARD V2.1 LAAS CNRS - Thomas FLAYOLS https://github.com/open-dynamic-robot-initiative/master-board

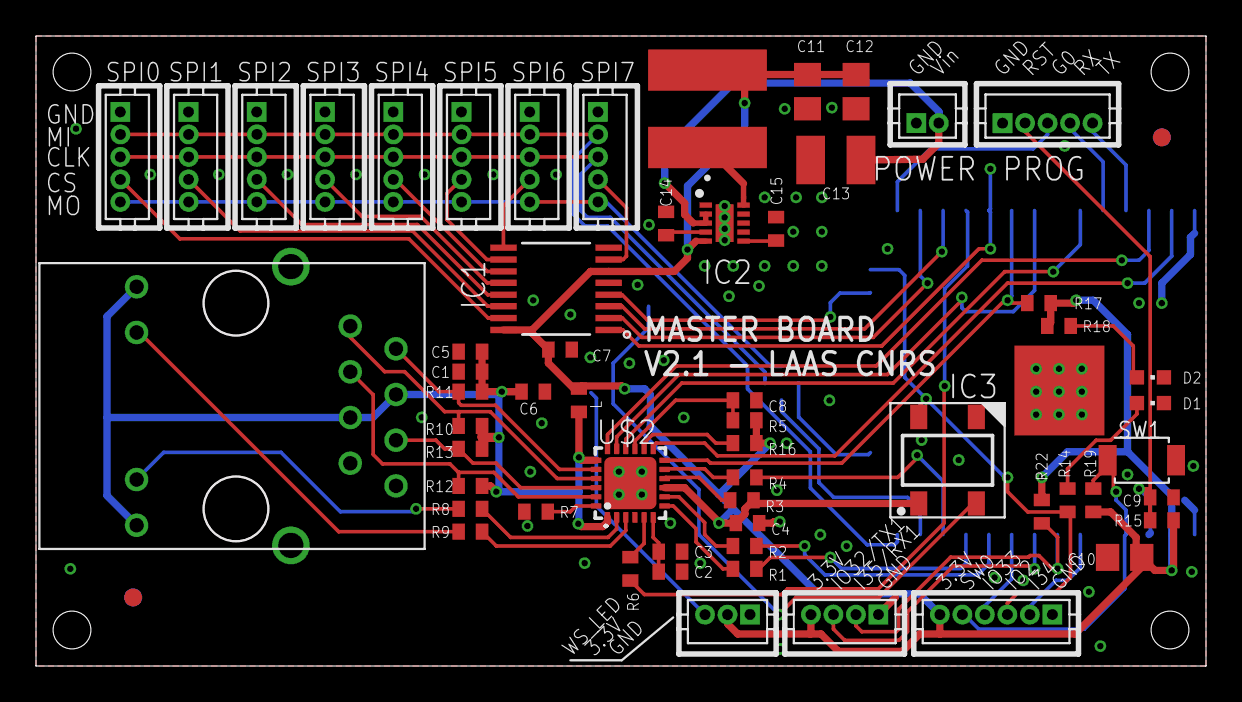
[picture p137: board esp32_master_board.brd from above]

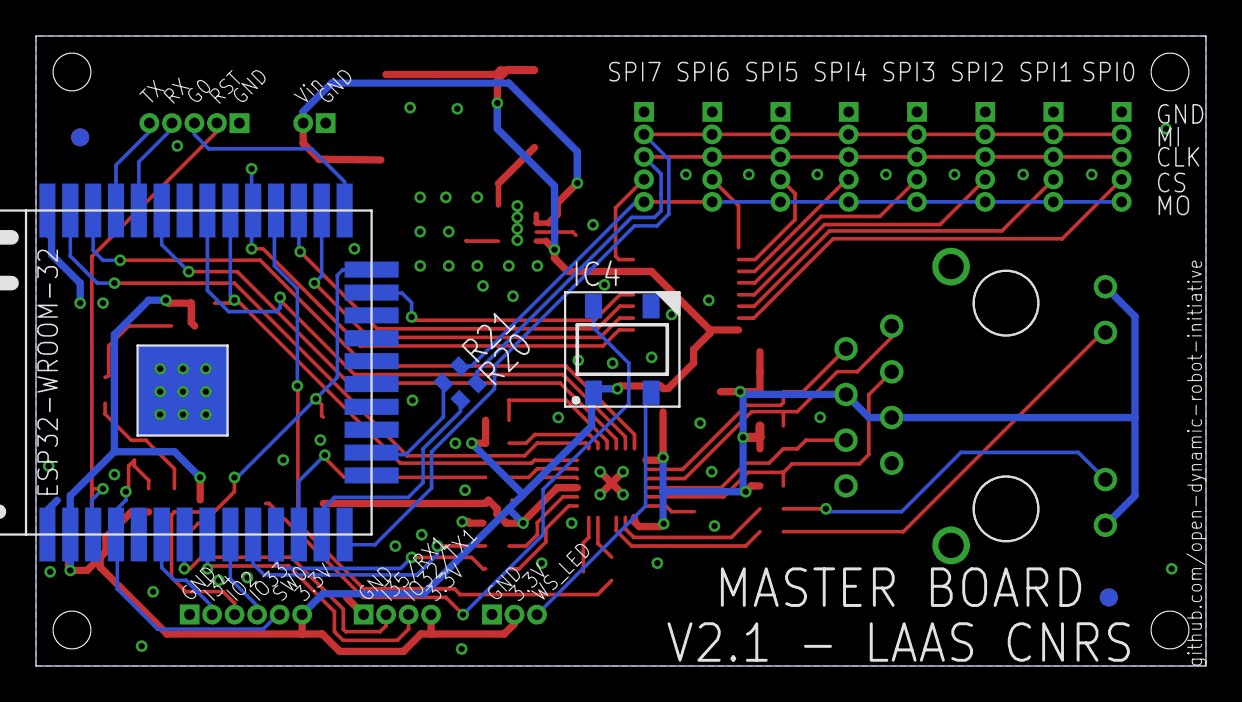
[picture p138: board esp32_master_board.brd from below]

Board: 2 copper layers, 65.0 x 35.0 mm, 66 parts (6 on the bottom side), 64 nets.

Other parts of the board:
REF1, REF2, REF3, REF4: VISION_REF10
