jochenalt/Lisbeth/schematics/FootSensor/FootSensor.brd

## EAGLE design schematics/FootSensor/FootSensor.brd (2022-03-09)

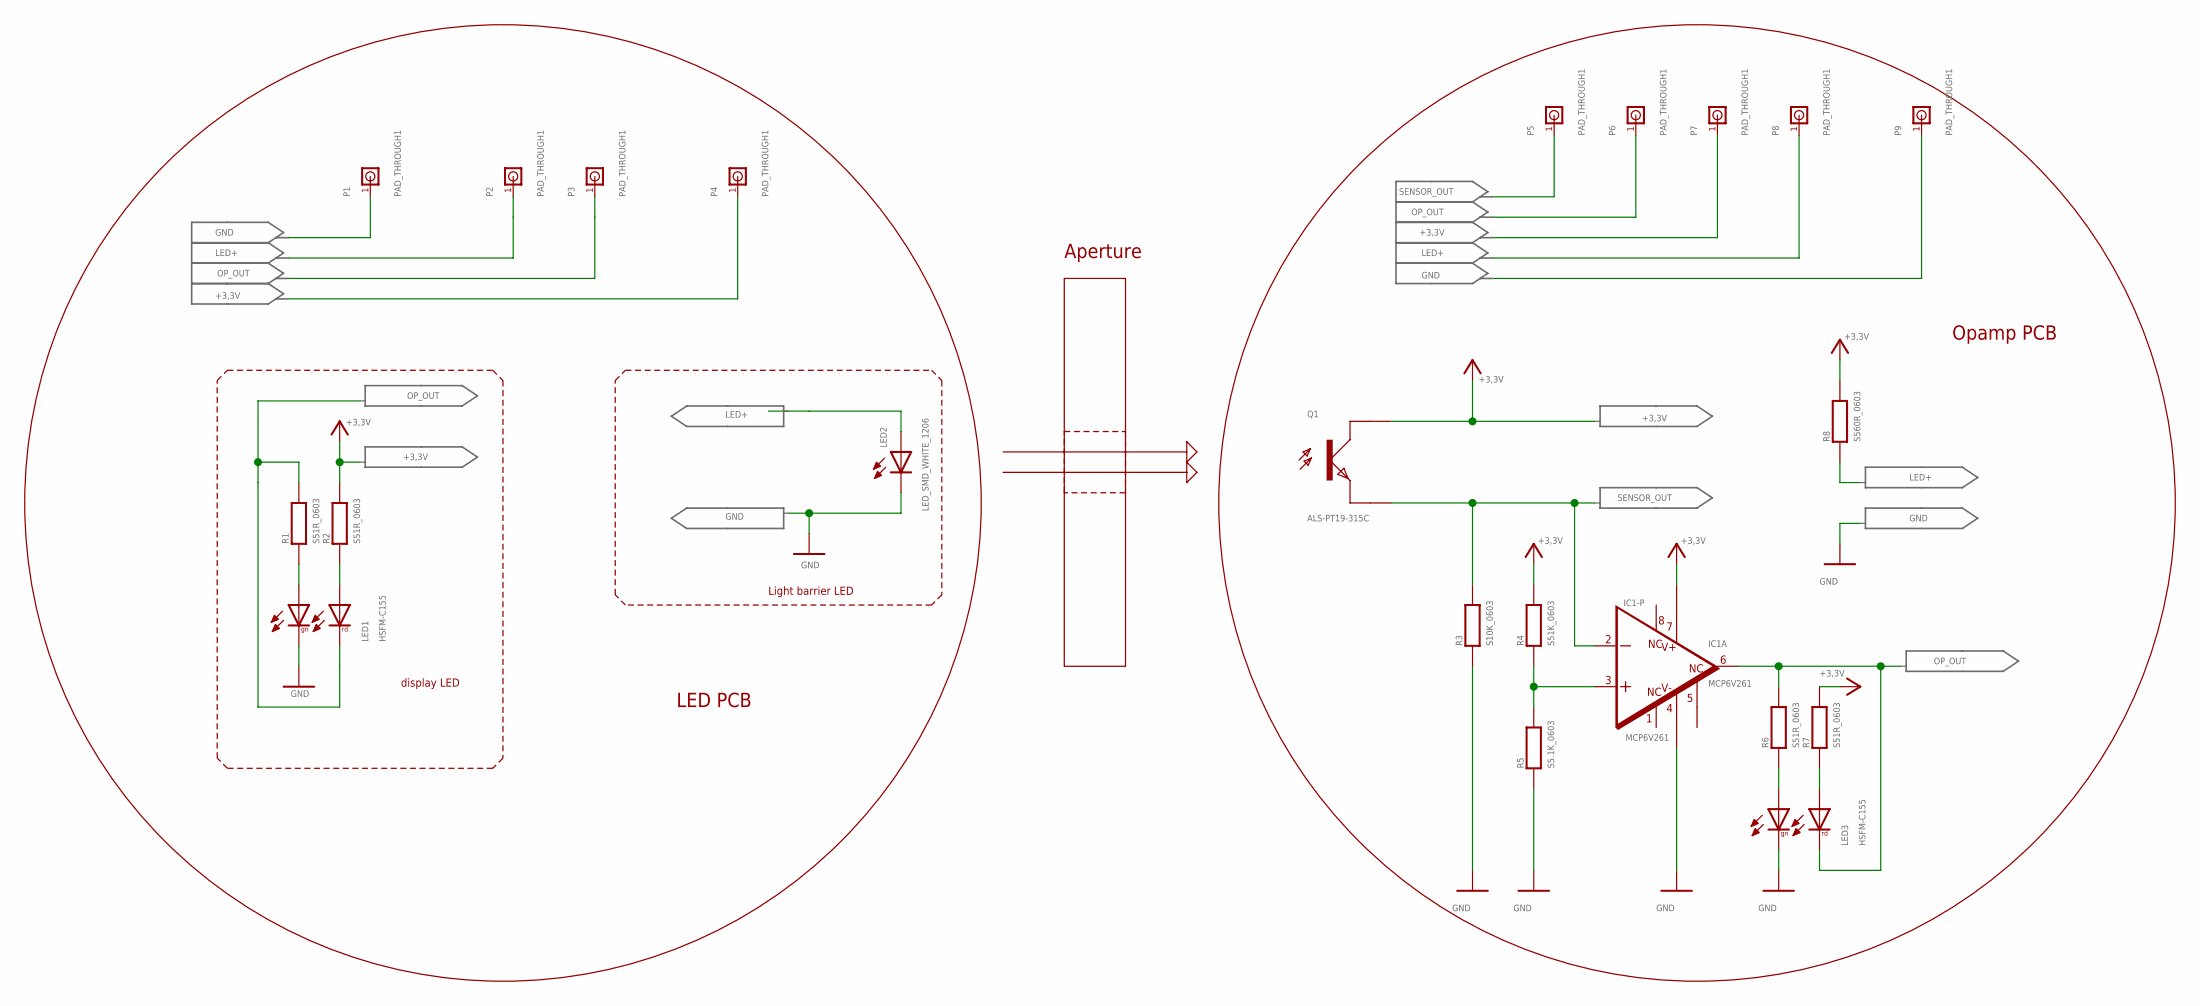
[picture p139: schematic FootSensor.sch]

Parts:
IC1: MCP6V261; MSOP8
LED1, LED3: HSFM-C155; 3225
LED2: LED_SMD_WHITE_1206; 1206C
P1, P2, P3, P4, P5, P6, P7, P8, P9: PAD_THROUGH1; PAD_TH_056X055
Q1: ALS-PT19-315C; FOTOTRANSISTOR
R1, R2, R6, R7: S51R_0603; 0603R
R3: S10K_0603; 0603R
R4: S51K_0603; 0603R
R5: S5.1K_0603; 0603R
R8: S560R_0603; 0603R

Connections:
+3,3V: IC1.7, P4.P$1, P7.P$1, Q1.1 (C), R2.P$2 (2), R4.P$2 (2), R7.P$2 (2), R8.P$2 (2)
GND: IC1.4, LED1.2, LED2.- (C1), LED3.2, P1.P$1, P9.P$1, R3.P$1 (1), R5.P$1 (1)
LED+: LED2.+ (A1), P2.P$1, P8.P$1, R8.P$1 (1)
unnamed: IC1.3, R4.P$1 (1), R5.P$2 (2)
unnamed: LED3.1, R6.P$1 (1)
unnamed: LED3.3, R7.P$1 (1)
unnamed: LED1.1, R1.P$1 (1)
unnamed: LED1.3, R2.P$1 (1)
OP_OUT: IC1.6, LED1.4, LED3.4, P3.P$1, P6.P$1, R1.P$2 (2), R6.P$2 (2)
SENSOR_OUT: IC1.2, P5.P$1, Q1.2 (E), R3.P$2 (2)

Notes on the sheet:
Aperture
LED PCB
Opamp PCB
display LED
Light barrier LED

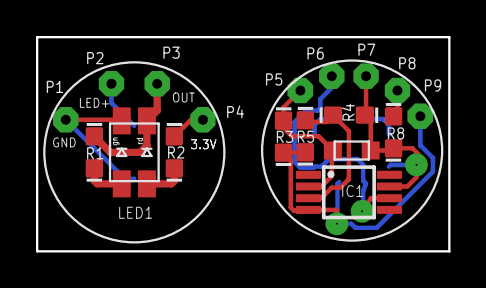
[picture p140: board FootSensor.brd from above]

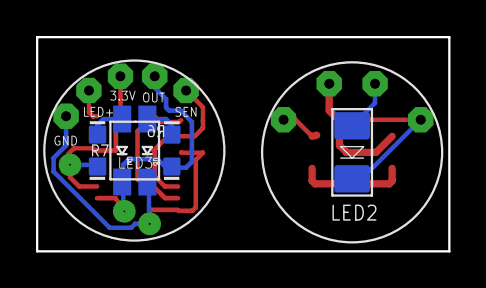
[picture p141: board FootSensor.brd from below]

Board: 2 copper layers, 22.9 x 11.9 mm, 22 parts (4 on the bottom side), 10 nets.
