jochenalt/Lisbeth/code/controller/src/Controller.cpp

#include <vector>
#include "Controller.hpp"

#include "pinocchio/algorithm/compute-all-terms.hpp"
#include "pinocchio/algorithm/crba.hpp"
#include "pinocchio/algorithm/frames.hpp"
#include "pinocchio/math/rpy.hpp"
#include "pinocchio/parsers/urdf.hpp"
#include "pinocchio/algorithm/joint-configuration.hpp"
#include "pinocchio/multibody/model.hpp"
#include "pinocchio/parsers/urdf.hpp"
#include "pinocchio/parsers/srdf.hpp"

 using namespace pinocchio;
 using namespace std;


Controller::Controller()
    : P(Vector12::Zero()),
      D(Vector12::Zero()),
      q_des(Vector12::Zero()),
      v_des(Vector12::Zero()),
      tau_ff(Vector12::Zero()),
      FF(Vector12::Zero()),
      error(false),
      error_flag(0),
      error_value(Vector12::Zero()),
      q_filt_mpc(Vector18::Zero()),
      h_v_filt_mpc(Vector6::Zero()),
      vref_filt_mpc(Vector6::Zero()),
      o_targetFootstep(Matrix34::Zero()),
      q_wbc(Vector18::Zero()),
      dq_wbc(Vector18::Zero()),
      base_targets(Vector12::Zero()),
      hRb(Matrix3::Identity()),
      p_ref_(Vector6::Zero()),
      f_mpc(Vector12::Zero()) {}

void Controller::init_robot() {

	 // Path to the robot URDF
	  const std::string filename = std::string(URDF_MODEL);

	  // Robot model
	  pinocchio::Model model;

	  // Build model from urdf (base is not free flyer)
	  pinocchio::urdf::buildModel(filename, pinocchio::JointModelFreeFlyer(), model, false);

	  // Construct data from model
	  pinocchio::Data data = pinocchio::Data(model);

	  // Update all the quantities of the model
	  VectorN q = VectorN::Zero(model.nq);
	  q(0,0) = 1.0;            //  x transition as defined in SRDF file
	  q(2,0) = 0.235;          // basic height as defined in SRDF file
	  q(6, 0) = 1.0;  		   // Quaternion (0, 0, 0, 1)
	  q.block<12,1>(7,0) = Vector12(params->q_init.data());

	  // Initialisation of model quantities
	  pinocchio::computeAllTerms(model, data, q, VectorN::Zero(model.nv));
	  pinocchio::centerOfMass(model, data, q, VectorN::Zero(model.nv));
	  pinocchio::updateFramePlacements(model, data);
	  pinocchio::crba(model, data, q);

	  // Initialise collision model, consider the disabled collisions from SRDF file
	  pinocchio::GeometryModel geom_model;
	  std::vector<std::string> paths;
	  paths.push_back(DESCRIPTION_PATH);
	  pinocchio::urdf::buildGeom(model,URDF_MODEL,COLLISION,geom_model, paths);
	  geom_model.addAllCollisionPairs();
	  pinocchio::srdf::removeCollisionPairs(model, geom_model, SRDF_MODEL);

	  // Initialisation of the position of footsteps
	  Matrix34 fsteps_init = Matrix34::Zero();
	  int indexes[4] = {static_cast<int>(model.getFrameId("FL_FOOT")), static_cast<int>(model.getFrameId("FR_FOOT")),
	                    static_cast<int>(model.getFrameId("HL_FOOT")), static_cast<int>(model.getFrameId("HR_FOOT"))};

	  for (int i = 0; i < 4; i++) {
		fsteps_init.col(i) = data.oMf[indexes[i]].translation();
        fsteps_init(0,i) -= 1.0;
	  }

	  // Get default height
	  double h_init = 0.0;
	  double h_tmp = 0.0;
	  for (int i = 0; i < 4; i++) {
	    h_tmp = (data.oMf[1].translation() - data.oMf[indexes[i]].translation())(2, 0);
	    if (h_tmp > h_init) {
	      h_init = h_tmp;
	    }
	  }

	  // Assumption that all feet are initially in contact on a flat ground
	  fsteps_init.row(2).setZero();

	  // Initialisation of the position of shoulders
	  Matrix34 shoulders_init = Matrix34::Zero();
	  int indexes_sh[4] = {4, 12, 20, 28};  //  Shoulder indexes
	  for (int i = 0; i < 4; i++) {
	    shoulders_init.col(i) = data.oMf[indexes_sh[i]].translation();
	    shoulders_init(0,i) -= 1.0;
	  }

	  // Saving data
	  params->h_ref = h_init;        // Reference height
	  params->mass = data.mass[0];  // Mass

	  // Inertia matrix
	  Vector6 Idata = data.Ycrb[1].inertia().data();
	  Matrix3 inertia;
	  // Composite rigid body inertia in q_init position
	  inertia << Idata(0, 0), Idata(1, 0), Idata(3, 0), Idata(1, 0), Idata(2, 0), Idata(4, 0), Idata(3, 0), Idata(4, 0),
	      Idata(5, 0);
	  for (int i = 0; i < 3; i++) {
	    for (int j = 0; j < 3; j++) {
	      params->I_mat[3 * i + j] = inertia(i, j);
	    }
	  }

	  // Offset between center of base and CoM
	  Vector3 CoM = data.com[0].head(3) - q.head(3);
     CoM(1,0) = 0; // assume we are symmetric

     for (int i = 0;i<3;i++) {
   	  params->CoM_offset[i] = CoM(i, 0);
     }

	  for (int i = 0; i < 4; i++) {
	    for (int j = 0; j < 3; j++) {
	      params->shoulders[3 * i + j] = shoulders_init(j, i);
	      params->footsteps_init[3 * i + j] = fsteps_init(j, i);
	      params->footsteps_under_shoulders[3 * i + j] = fsteps_init(j, i);  // Use initial feet pos as reference
	    }
	  }
}


void Controller::initialize(Params& params_in) {
	  // Params store parameters
	  params = &params_in;

	  // Init robot parameters
	  init_robot();

	  // Initialization of the control blocks
	  bodyPlanner.setup(params_in);
	  gait.initialize(params_in);
     gait.update(true,  GaitType::NoMovement);

	  footstepPlanner.initialize(params_in, gait);
	  mpcController.initialize(params_in);
	  footTrajectoryGenerator.initialize(params_in, gait);
	  estimator.initialize(params_in, gait);
	  wbcController.initialize(params_in);

	  filter_mpc_q.initialize(params_in);
	  filter_mpc_v.initialize(params_in);
	  filter_mpc_vref.initialize(params_in);

	  // Other variables
	  params->h_ref = params_in.h_ref;
	  P = (Vector3(params_in.Kp_main.data())).replicate<4, 1>();
	  D = (Vector3(params_in.Kd_main.data())).replicate<4, 1>();
	  FF = params_in.Kff_main * Vector12::Ones();
}

void Controller::security_check() {
  Vector12 q_security_ = (Vector3(1.2, 2.1, 3.14)).replicate<4, 1>();

  if (((estimator.getQEstimate().tail(12).cwiseAbs()).array() > q_security_.array()).any()) {
    std::cout << "Position limit error "
              << ((estimator.getQEstimate().tail(12).cwiseAbs()).array() > q_security_.array()).transpose()
              << std::endl;
    error_flag = 1;
  } else if (((estimator.getVSecurity().cwiseAbs()).array() > 100.0).any()) {
    std::cout << "Velocity limit error " << ((estimator.getVSecurity().cwiseAbs()).array() > 100.0).transpose()
              << std::endl;
    error_flag = 2;
  } else if (((tau_ff.cwiseAbs()).array() > 8.0).any()) {
    std::cout << "Feedforward limit error " << ((tau_ff.cwiseAbs()).array() > 8.0).transpose() << std::endl;
    error_flag = 3;
  } else {
    error_flag = 0;
  }

  if (error_flag == 0 && !error) {
    if (error_flag != 0) {
      error = true;
      switch (error_flag) {
        case 1:  // Out of position limits
          error_value = estimator.getQEstimate().tail(12) * 180 / 3.1415;
          break;
        case 2:  // Out of velocity limits
          error_value = estimator.getVSecurity();
          break;
        default:  // Out of torques limits
          error_value = tau_ff;
      }
    }
  }

  // If something wrong happened in the controller we stick to a security controller
  if (error) {
    // Quantities sent to the control board
    P = Vector12::Zero();        // No position control
    D = 0.1 * Vector12::Ones();  // Damping
    q_des = Vector12::Zero();
    v_des = Vector12::Zero();
    FF = Vector12::Zero();  // No feedforward torques
    tau_ff = Vector12::Zero();
  }
}

Matrix34 cross_replicate(Vector3 a, Matrix34 b) {
	Matrix34 result;
	for (int i = 0;i<b.cols();i++) {
		  result.col(i) = a.cross(b.col(i));

	}

	return result;
}

void Controller::compute(Vector3 const& imuLinearAcceleration,
			 Vector3 const& imuGyroscopse,
			 Vector3 const& imuAttitudeEuler,
			 Vector4 const& imuAttitudeQuat,
			 Vector12 const& jointsPositions,
			 Vector12 const& jointsVelocities)
{
	static uint64_t avr_total = 0;
	static uint64_t avr_wbc = 0;
	uint64_t start_total = get_micros();
	uint64_t start_wbc = 0;
	uint64_t end_wbc = 0;
	int k = params->get_k();
	// std::cout << "--- C++ ---" << k << " " << k % params->get_k_mpc() << " " << params->get_k_mpc() - (k % params->get_k_mpc())<< std::endl;

	estimator.run(footTrajectoryGenerator.getFootPosition(),
		  	  	imuLinearAcceleration,imuGyroscopse, imuAttitudeEuler,  imuAttitudeQuat,
				jointsPositions,jointsVelocities);

	// Update state vectors of the robot (q and v) + transformation matrices between world and horizontal frames
	estimator.updateReferenceState(cmd_v_ref);
	// Quantities go through a 1st order low pass filter with fc = 15 Hz (avoid >25Hz foldback)
	q_filt_mpc = estimator.getQReference();
	q_filt_mpc.head(6) = filter_mpc_q.filter(estimator.getQReference().head(6), true);

	h_v_filt_mpc = filter_mpc_v.filter(estimator.getHV().head(6), false);
	vref_filt_mpc = filter_mpc_vref.filter(estimator.getBaseVelRef().head(6), false);

	// automatically turn on previous gait when we start moving
	if ((gait.getCurrentGaitType() == GaitType::NoMovement)  and !cmd_stop and cmd_is_moving) {
		std::cout << "command received, start moving" << std::endl;
		if (gait.getPrevGaitType() == GaitType::NoGait)
			cmd_gait = GaitType::Trot;
		else
			cmd_gait =  gait.getPrevGaitType();
	}

	//  automatically go to static mode if no movement is detected
	bool is_steady = estimator.isSteady();
	if (gait.isNewPhase() && gait.getCurrentGaitType() != GaitType::NoMovement && is_steady && !cmd_stop && !cmd_is_moving) {
		std::cout << "no movement, calm down" << std::endl;
	 	cmd_gait = GaitType::NoMovement;
	}

	// at a new gait cycle we need create the next gait round and start MPC
	bool startNewGaitCycle = params->is_new_mpc_cycle();

	gait.update(startNewGaitCycle, cmd_gait);
	cmd_gait = GaitType::NoGait;

	// Compute target footstep based on current and reference velocities
	o_targetFootstep = footstepPlanner.updateFootsteps(estimator.getQReference(),
										estimator.getHVFiltered(), estimator.getBaseVelRef());

	// Update pos, vel and acc references for feet
	footTrajectoryGenerator.update(startNewGaitCycle, o_targetFootstep);

	// Run state planner (outputs the reference trajectory of the base)
	bodyPlanner.update(q_filt_mpc.head(6), h_v_filt_mpc, vref_filt_mpc);
	const Matrix12N& bodyTrajectory = bodyPlanner.getBodyTrajectory();

	// Solve MPC problem once every params->get_k_mpc() iterations of the main loop
	if (startNewGaitCycle) {
		mpcController.solve(bodyTrajectory, footstepPlanner.getFootsteps(), gait.getCurrentGaitMatrix());

		// this returns the result of the previous mpc run, this one just started
		f_mpc = mpcController.get_latest_result();
	}

	if (startNewGaitCycle) {
		mpcController.solve(bodyTrajectory, footstepPlanner.getFootsteps(), gait.getCurrentGaitMatrix());
		f_mpc = mpcController.get_latest_result();
	}
	if ((params->get_k() % params->get_k_mpc() >=2) || (mpcController.is_ready() && params->enable_early_mpc_result)) {
		f_mpc = mpcController.get_latest_result();
	}


	// Whole Body Control
	// If nothing wrong happened yet in the WBC controller
	if (!error && !cmd_stop) {
	    // Desired position, orientation and velocities of the base
	    base_targets.head(6).setZero();
	    base_targets.block<2,1>(3,0) = bodyTrajectory.block<2,1>(3,1);
	    base_targets.block<6,1>(6,0) = vref_filt_mpc;// Velocities (in horizontal frame!)

	    Vector3 T = -estimator.getoTh() - Vector3(0.0, 0.0, params->h_ref);
	    Matrix3 R = estimator.gethRb() * estimator.getoRh().transpose();

	    Matrix3N feet_a_cmd = R * footTrajectoryGenerator.getFootAcceleration();
	    Matrix3N feet_v_cmd = R * footTrajectoryGenerator.getFootVelocity();
	    Matrix3N feet_p_cmd = R * (footTrajectoryGenerator.getFootPosition()  + T.replicate(1,4));

	    Vector3 v_ref36 = estimator.getBaseVelRef().block<3,1>(3,0);
	    Vector3 v_ref03 = estimator.getBaseVelRef().block<3,1>(0,0);

	    feet_a_cmd += - cross_replicate(v_ref36,cross_replicate( v_ref36, feet_p_cmd))
        		      	- 2.0* cross_replicate(v_ref36, feet_v_cmd);
	    feet_v_cmd += - v_ref03.replicate(1,4)
	    		         - cross_replicate (v_ref36, feet_p_cmd);

	    // Update configuration vector for wbc
       q_wbc.block<3,1>(0,0) = Vector3(0,0,params->h_ref);
	    q_wbc(3, 0) = q_filt_mpc(3, 0);         	 	// Roll
	    q_wbc(4, 0) = q_filt_mpc(4, 0);          	// Pitch
	    q_wbc.tail(12) = wbcController.get_qdes();  // with reference angular positions of previous loop

	    // Update velocity vector for wbc
	    dq_wbc.head(6) = estimator.getVEstimate().head(6);  		// Velocities in base frame (not horizontal frame!)
	    dq_wbc.tail(12) = wbcController.get_vdes();            	// with reference angular velocities of previous loop

	    // Run InvKin + WBC QP
	 	 start_wbc = get_micros();
	    wbcController.compute(q_wbc, dq_wbc, f_mpc, gait.getCurrentGaitMatrix().row(0),
	    					  feet_p_cmd,feet_v_cmd,feet_a_cmd,
	    					  base_targets);
	 	 end_wbc = get_micros();

	    // Quantities sent to the control board
	    q_des = wbcController.get_qdes();
	    v_des = wbcController.get_vdes();
	    tau_ff = 0.8 * wbcController.get_tau_ff();
	    // P = 3.0 * Vector12::Ones();  // position
	    // D = 0.2 * Vector12::Ones();  // Damping
	  }

	  // Security check
	  security_check();

	  uint64_t end_total = get_micros();
	  avr_total = (avr_total + (end_total - start_total)) / 2;
	  avr_wbc = (avr_wbc + (end_wbc - start_wbc)) / 2;

	  if ((k % 1000) == 0) {
		 	std::cout << "c::loop t=" << avr_total << "us wbc=" << avr_wbc << std::endl;
	  }
}

void Controller::command_speed(double vX, double vY, double heightZ, double rotX, double rotY, double angSpeedZ) {
	cmd_v_ref(0,0) = vX;
	cmd_v_ref(1,0) = vY;
	cmd_v_ref(2,0) = heightZ;
	cmd_v_ref(3,0) = rotX;
	cmd_v_ref(4,0) = rotY;
	cmd_v_ref(5,0) = angSpeedZ;
	cmd_is_moving = (abs(vX) > 0.001) || (abs(vY) > 0.001) || (abs(rotX) > 0.001) || (abs(rotY) > 0.001) || (abs(angSpeedZ) > 0.001);
}
