jochenalt/Lisbeth/schematics/master-board-master/firmware/components/spi_manager/spi_manager.c

#include "driver/spi_master.h"
#include "soc/gpio_struct.h"
#include "driver/gpio.h"
#include "spi_manager.h"
#include <string.h>

static spi_device_handle_t spi;

typedef struct {
    bool is_finished;
    int demux_nb;
} spi_trans_info;

void config_demux() {
    gpio_config_t io_conf;

	//disable interrupt
	io_conf.intr_type = GPIO_PIN_INTR_DISABLE;
	
	//set as output mode
	io_conf.mode = GPIO_MODE_OUTPUT;
	
	//bit mask of the pins that you want to set
	io_conf.pin_bit_mask = GPIO_DEMUX_PIN_SEL;
	
	//disable pull-down mode
	io_conf.pull_down_en = 0;
	
	//disable pull-up mode
	io_conf.pull_up_en = 0;
	
	//configure GPIO with the given settings
	gpio_config(&io_conf);
}

void IRAM_ATTR spi_pre_transfer_callback(spi_transaction_t *trans) {
    uint slave_nb = ((spi_trans_info*) trans->user)->demux_nb;
    gpio_set_level(GPIO_DEMUX_A0, slave_nb&0x1);
    gpio_set_level(GPIO_DEMUX_A1, (slave_nb>>1)&0x1);
    gpio_set_level(GPIO_DEMUX_A2, (slave_nb>>2)&0x1);
}

void IRAM_ATTR spi_post_transfer_callback(spi_transaction_t *trans) {
    ((spi_trans_info*) trans->user)->is_finished = true;
}

void spi_init() {
	config_demux();

    spi_bus_config_t buscfg={
        .miso_io_num=PIN_NUM_MISO,
        .mosi_io_num=PIN_NUM_MOSI,
        .sclk_io_num=PIN_NUM_CLK,
        .quadwp_io_num=-1,
        .quadhd_io_num=-1,
        .max_transfer_sz=SPI_TOTAL_LEN*2
    };

    spi_device_interface_config_t devcfg={
        .clock_speed_hz=SPI_MASTER_FREQ_80M / CONFIG_SPI_DATARATE_FACTOR, //Clock out
        .mode=0,                                  //SPI mode 0
        .spics_io_num=GPIO_DEMUX_OE,              //CS pin
        .queue_size=10,                           //We want to be able to queue 10 transactions at a time
        .pre_cb=spi_pre_transfer_callback,        //Specify pre-transfer callback to handle D/C line
        .post_cb=spi_post_transfer_callback,      //Specify pre-transfer callback to handle D/C line
    };

    //Initialize the SPI bus
    ESP_ERROR_CHECK(spi_bus_initialize(HSPI_HOST, &buscfg, 0));
    ESP_ERROR_CHECK(spi_bus_add_device(HSPI_HOST, &devcfg, &spi));
}

bool spi_send(int slave, uint8_t *tx_data, uint8_t *rx_data, int len) {
	spi_transaction_t trans;
    memset(&trans, 0, sizeof(trans));

    spi_trans_info info;

    info.is_finished = false;
    info.demux_nb = slave;
	trans.user = &info;

	trans.rx_buffer = rx_data;
	trans.tx_buffer = tx_data;
	trans.length=8*len;
	
	esp_err_t err = spi_device_polling_transmit(spi, &trans);
	
	return err == ESP_OK;
}
