jochenalt/Lisbeth/code/controller/scripts/Controller.py

# coding: utf8

import numpy as np
import Utils
import time
import math

import pinocchio as pin
import libcontroller_core as core
from cmath import nan
import RemoteControl
import Types
import ModelLoader
import Utils

class Result:
    """Object to store the result of the control loop
    It contains what is sent to the robot (gains, desired positions and velocities,
    feedforward torques)"""

    def __init__(self):

        self.P = 0.0
        self.D = 0.0
        self.q_des = np.zeros(12)
        self.v_des = np.zeros(12)
        self.tau_ff = np.zeros(12)


class dummyHardware:
    """Fake hardware for initialisation purpose"""

    def __init__(self):

        pass

    def imu_data_attitude(self, i):

        return 0.0


class dummyDevice:
    """Fake device for initialisation purpose"""

    def __init__(self):

        self.hardware = dummyHardware()




class Controller:
        
    def init_robot(self,  params):
        ModelLoader.free_flyer = True
        robot = ModelLoader.ModelLoader().robot  
        #q = robot.q0.reshape((-1, 1))
        q = np.zeros((19,1))
        q[0,0] = 1.0            # x transition as defined in SRDF file
        q[2,0] = 0.235          # basic height as defined in SRDF file
        q[6,0] = 1
        q[7:, 0] = params.q_init

        # Initialisation of model quantities
        pin.centerOfMass(robot.model, robot.data, q, np.zeros((18, 1)))
        pin.updateFramePlacements(robot.model, robot.data)
        pin.crba(robot.model, robot.data, q)

        # Initialisation of the position of footsteps
        self.fsteps_init = np.zeros((3, 4))
        indexes = [
           robot.model.getFrameId("FL_FOOT"),
           robot.model.getFrameId("FR_FOOT"),
           robot.model.getFrameId("HL_FOOT"),
           robot.model.getFrameId("HR_FOOT"),
        ]
        for i in range(4):
            self.fsteps_init[:, i] = robot.data.oMf[indexes[i]].translation
            self.fsteps_init[0,i] = self.fsteps_init[0,i] - 1.0

        h_init = 0.0
        for i in range(4):
            h_tmp = (robot.data.oMf[1].translation - robot.data.oMf[indexes[i]].translation)[
                2
            ]
            if h_tmp > h_init:
                h_init = h_tmp
        
        # Assumption that all feet are initially in contact on a flat ground
        self.fsteps_init[2, :] = 0.0

        # Initialisation of the position of shoulders
        shoulders_init = np.zeros((3, 4))
        #indexes = [4, 12, 20, 28]  # Shoulder indexes
        indexes = [
           robot.model.getFrameId("FL_SHOULDER"),
           robot.model.getFrameId("FR_SHOULDER"),
           robot.model.getFrameId("HL_SHOULDER"),
           robot.model.getFrameId("HR_SHOULDER"),
        ]

        for i in range(4):
            shoulders_init[:, i] = robot.data.oMf[indexes[i]].translation
            shoulders_init[0,i] = shoulders_init[0,i] -1


        # Saving data
        params.h_ref = h_init
        params.mass = robot.data.mass[
            0
        ]  # Mass of the whole urdf model (also = to Ycrb[1].mass)
        params.I_mat = (
            robot.data.Ycrb[1].inertia.ravel().tolist()
        )  # Composite rigid body inertia in q_init position
        
        params.CoM_offset = (robot.data.com[0][:3] - q[0:3, 0]).tolist()
        params.CoM_offset[1] = 0.0

        for i in range(4):
            for j in range(3):
                params.shoulders[3 * i + j] = shoulders_init[j, i]
                params.footsteps_init[3 * i + j] = self.fsteps_init[j, i]
                params.footsteps_under_shoulders[3 * i + j] = self.fsteps_init[
                    j, i
                ]  #  Use initial feet pos as reference

        return robot
    
    def __init__(self, params, q_init):
        """Function that runs a simulation scenario based on a reference velocity profile, an environment and
        various parameters to define the gait

        Args:
            envID (int): identifier of the current environment to be able to handle different scenarios
            velID (int): identifier of the current velocity profile to be able to handle different scenarios
            dt_wbc (float): time step of the whole body control
            dt_mpc (float): time step of the MPC
            k_mpc (int): number of iterations of inverse dynamics for one iteration of the MPC
            t (float): time of the simulation
            T_gait (float): duration of one gait period in seconds
            T_mpc (float): duration of mpc prediction horizon
            N_SIMULATION (int): number of iterations of inverse dynamics during the simulation
            use_flat_plane (bool): to use either a flat ground or a rough ground
            predefined_vel (bool): to use either a predefined velocity profile or a gamepad
            enable_pyb_GUI (bool): to display PyBullet GUI or not
            N_gait (int): number of spare lines in the gait matrix
            isSimulation (bool): if we are in simulation mode
            N_periods (int): 1
            gait:  Initial gait matrix
            
        """

        ########################################################################
        #                        Parameters definition                         #
        ########################################################################

        # Lists to log the duration of 1 iteration of the MPC/TSID
        self.t_list_filter = [0] * int(params.N_SIMULATION)
        self.t_list_planner = [0] * int(params.N_SIMULATION)
        self.t_list_mpc = [0] * int(params.N_SIMULATION)
        self.t_list_wbc = [0] * int(params.N_SIMULATION)
        self.t_list_loop = [0] * int(params.N_SIMULATION)

        self.t_list_InvKin = [0] * int(params.N_SIMULATION)
        self.t_list_QPWBC = [0] * int(params.N_SIMULATION)

        # Enable/Disable perfect estimator
        perfectEstimator = False
        if not params.SIMULATION:
            perfectEstimator = False  # Cannot use perfect estimator if we are running on real robot

        # Load robot model and data
        self.robot = self.init_robot(params)

        self.wbcController = core.WbcController()
        self.wbcController.initialize(params)

        self.mpcController = core.MpcController()
        self.mpcController.initialize(params)

        self.h_ref = params.h_ref
        self.q_init = np.hstack((np.zeros(6), q_init.copy()))
        self.q_init[2] = params.h_ref

        self.SIMULATION = params.SIMULATION
        self.enable_pyb_GUI = params.enable_pyb_GUI

        self.h_ref = params.h_ref
        self.q = np.zeros(18)
        self.q[0:6] = np.array([0.0, 0.0, self.h_ref, 0.0, 0.0, 0.0])
        self.q[6:] = q_init
        self.mpc_f_cmd = np.zeros((12,1))

        self.gait = core.Gait()
        self.gait.initialize(params)
        self.gait.update(True,  Types.GaitType.NoMovement.value)

        # initialize Cpp state estimator
        self.estimator = core.Estimator()
        self.estimator.initialize(params, self.gait)


        self.bodyPlanner = core.BodyPlanner()
        self.bodyPlanner.initialize(params)

        self.shoulders = np.zeros((3, 4))
        self.footstepPlanner = core.FootstepPlanner()
        self.footstepPlanner.initialize(params, self.gait)

        self.footTrajectoryGenerator = core.FootTrajectoryGenerator()

        self.footTrajectoryGenerator.initialize(params, self.gait)

        # Wrapper that makes the link with the solver that you want to use for the MPC
        # First argument to True to have PA's MPC, to False to have Thomas's MPC
        self.velID = params.velID
        self.base_targets = np.zeros(12)

        self.filter_q = core.Filter()
        self.filter_q.initialize(params)
        self.filter_h_v = core.Filter()
        self.filter_h_v.initialize(params)
        self.filter_vref = core.Filter()
        self.filter_vref.initialize(params)

        self.v_ref = np.zeros(6)
        self.h_v = np.zeros(6)
        self.h_v_windowed = np.zeros(6)

        self.feet_a_cmd = np.zeros((3, 4))
        self.feet_v_cmd = np.zeros((3, 4))
        self.feet_p_cmd = np.zeros((3, 4))

        self.error = False  # True if something wrong happens in the controller
        self.error_flag = 0
        self.q_security = np.array([np.pi*0.4, np.pi*80/180, np.pi] * 4)

        # Interface with the PD+ on the control board
        self.result = Result()

        dDevice = dummyDevice()
        dDevice.q_mes = q_init         # actuators positions [0..12]
        dDevice.v_mes = np.zeros(12)
        dDevice.baseLinearAcceleration = np.zeros(3)
        dDevice.baseAngularVelocity = np.zeros(3)
        dDevice.baseOrientation = np.array([0.0, 0.0, 0.0])

        dDevice.dummyPos = np.array([0.0, 0.0, q_init[2]])
        dDevice.b_baseVel = np.zeros(3)
        
        # Run the control loop once with a dummy device for initialization
        #self.compute(params, dDevice)

        
    def compute(self, params, device, remoteControl):
        """Run one iteration of the main control loop

        Args:
            device (object): Interface with the masterboard or the simulation
        """
        
        k = params.get_k()
        k_mpc = params.get_k_mpc()
        print("---- PY---", k, k % k_mpc, k_mpc - k % k_mpc)
        t_start = time.time()

        # Update the reference velocity coming from the gamepad
        start = time.clock()
        
        baseHeight = np.array([0.0, 0.0, 0.0, device.dummyPos[2] - 0.0155])
        baseVelocity = device.b_baseVel

        oRh, hRb, oTh=  self.run_estimator(remoteControl, device)

        t_filter = time.time()
        
        # automatically turn on a gait if we start moving
        gaitCode = remoteControl.gaitCode
        if (self.gait.getCurrentGaitTypeInt() == Types.GaitType.NoMovement.value)  and remoteControl.isMoving:
            print ("command received, start moving")
            prevGaitCode = self.gait.getPrevGaitTypeInt()
            if gaitCode == Types.GaitType.NoGait.value:
               gaitCode = Types.GaitType.Trot.value # default gait
            else:
                gaitCode = prevGaitCode
                
        # automatically go to static mode if no movement is detected
        is_steady = self.estimator.isSteady()
        if self.gait.isNewPhase and self.gait.getCurrentGaitTypeInt() != Types.GaitType.NoMovement.value and is_steady and  not remoteControl.isMoving:
            print ("no movement, calm down")
            gaitCode = Types.GaitType.NoMovement.value
            

        # at a new gait cycle we need create the next gait round and start MPC
        startNewGaitCycle = params.is_new_mpc_cycle()
                
        self.gait.update(startNewGaitCycle, gaitCode)
        
        # Compute target footstep based on current and reference velocities
        o_targetFootstep = self.footstepPlanner.updateFootsteps(self.q,
                                                                self.h_v_windowed,
                                                                self.v_ref)

        # Update pos, vel and acc references for feet
        self.footTrajectoryGenerator.update(startNewGaitCycle, o_targetFootstep)

        # Run state planner (outputs the reference trajectory of the base)
        self.bodyPlanner.update(self.q_filtered[:6], self.h_v_filtered,self.vref_filtered)
        reference_state = self.bodyPlanner.getBodyTrajectory()
        t_planner = time.time()

        # Solve MPC problem once every k_mpc iterations of the main loop
        if startNewGaitCycle:
            self.mpcController.solve(reference_state,  self.footstepPlanner.getFootsteps(),self.gait.getCurrentGait())
            self.mpc_f_cmd = self.mpcController.get_latest_result() # solution should be there by now

        if (k % k_mpc) >= 2:
            self.mpc_f_cmd = self.mpcController.get_latest_result() # solution should be there by now

        t_mpc = time.time()

        # Target state for the whole body control

        self.wbc_f_cmd = np.zeros(12)
        self.wbc_f_cmd = (self.mpc_f_cmd).copy()

        # Whole Body Control
        # If nothing wrong happened yet in the WBC controller
        if (not self.error) and (not remoteControl.stop):

            self.q_wbc = np.zeros(18)
            self.dq_wbc = np.zeros(18)


            self.get_base_targets(reference_state, hRb)
            self.get_feet_targets(reference_state, oRh, oTh, hRb)
            
            self.q_wbc[2] = self.h_ref  # at position (0.0, 0.0, h_ref)
            self.q_wbc[3:5] = self.q_filtered[3:5]
            self.q_wbc[6:] = self.wbcController.qdes  # with reference angular positions of previous loop

            # Get velocity in base frame for Pinocchio (not current base frame but desired base frame)
            self.dq_wbc[:6] = self.estimator.get_v_estimate()[:6]
            self.dq_wbc[6:] = self.wbcController.vdes
            
            # Run InvKin + WBC QP
            self.wbcController.compute(self.q_wbc, self.dq_wbc,
                                    self.wbc_f_cmd, np.array([self.gait.getCurrentGait()[0, :]]),
                                    self.feet_p_cmd,
                                    self.feet_v_cmd,
                                    self.feet_a_cmd,
                                    self.base_targets)
                                    
            # Quantities sent to the control board
            self.result.P = 3.0 * np.ones(12)
            self.result.D = 0.2 * np.ones(12)
            self.result.q_des[:] = self.wbcController.qdes[:]
            self.result.v_des[:] = self.wbcController.vdes[:]
            self.result.tau_ff[:] = 0.8 * self.wbcController.tau_ff
            
        t_wbc = time.time()

        # Security check
        self.security_check(remoteControl)

        return 0.0


    def security_check(self, remoteControl):
        cpp_q_filt = np.transpose(np.array(self.estimator.get_q_estimate())[np.newaxis])
        
        if (self.error_flag == 0) and (not self.error) and (not remoteControl.stop) and self.gait.getCurrentGaitTypeInt() != 6:
            if np.any(np.abs(cpp_q_filt[7:, 0]) > self.q_security):
                self.error = True
                self.error_flag = 1
                self.error_value = cpp_q_filt[7:, 0] * 180 / 3.1415

            if np.any(np.abs(self.estimator.get_v_security()) > 50):
                print ("v_secu", self.estimator.get_v_Security())
            if np.any(np.abs(self.estimator.get_v_security()) > 100):
                self.error = True
                self.error_flag = 2
                self.error_value = self.estimator.get_v_vecurity()
                
            # @JA security level was 8 formerly
            if np.any(np.abs(self.wbcController.tau_ff) > 8):
                print ("tau_ff", self.wbcController.tau_ff)
            if np.any(np.abs(self.wbcController.tau_ff) > 22):
                self.error = True
                self.error_flag = 3
                self.error_value = self.wbcController.tau_ff

        # If something wrong happened in TSID controller we stick to a security controller
        if self.error or remoteControl.stop:

            # Quantities sent to the control board
            self.result.P = np.zeros(12)
            self.result.D = 0.1 * np.ones(12)
            self.result.q_des[:] = np.zeros(12)
            self.result.v_des[:] = np.zeros(12)
            self.result.tau_ff[:] = np.zeros(12)

       
    def run_estimator(self, remoteControl, device):
        """
        Call the estimator and retrieve the reference and estimated quantities.
        Run a filter on q, h_v and v_ref.

        @param device device structure holding simulation data
        @param q_perfect 6D perfect position of the base in world frame
        @param v_baseVel_perfect 3D perfect linear velocity of the base in base frame
        """
        #print ("PY self.gait.matrix,", self.gait.matrix)
        #print ("PY self.footTrajectoryGenerator.get_foot_position().", self.footTrajectoryGenerator.get_foot_position())

        self.estimator.run(self.footTrajectoryGenerator.get_foot_position().copy(),
                           device.baseLinearAcceleration.copy(), device.baseAngularVelocity.copy(), device.baseOrientation.copy(),device.baseOrientationQuad.copy(), # data from IMU
                           device.q_mes, device.v_mes) # data from joints

        self.estimator.update_reference_state(remoteControl.v_ref)
                
        oRh = self.estimator.get_oRh()                 # rotation between the world and horizontal frame
        hRb = self.estimator.get_hRb()                 # rotation between the horizontal and base frame
        oTh = self.estimator.get_oTh().reshape((3, 1)) # translation between the world and horizontal frame

        self.v_ref = self.estimator.get_base_vel_ref()
        self.h_v = self.estimator.get_h_v()
        self.h_v_windowed = self.estimator.get_h_v_filtered()
        self.q = self.estimator.get_q_reference();
        self.v = self.estimator.get_v_reference()

    
        self.q_filtered = self.q.copy()
        self.q_filtered[:6] = self.filter_q.filter(self.q[:6], True)

        self.h_v_filtered = self.filter_h_v.filter(self.h_v, False)
        self.vref_filtered = self.filter_vref.filter(self.v_ref, False)
        return oRh, hRb, oTh
    

    def get_base_targets(self, reference_state, hRb):
        """
        Retrieve the base position and velocity targets

        @params reference_state reference centroideal state trajectory
        @params hRb rotation between the horizontal and base frame
        """
        # hRb = np.eye(3)

        self.base_targets[:6] = np.zeros(6)
        self.base_targets[[3, 4]] = reference_state[[3, 4], 1]
        self.base_targets[6:] = self.vref_filtered
        

        return hRb

    def get_feet_targets(self, reference_state, oRh, oTh, hRb):
        """
        Retrieve the feet positions, velocities and accelerations to send to the WBC
        (in base frame)

        @params reference_state reference centroideal state trajectory
        @params footsteps footsteps positions over horizon
        @params oRh rotation between the world and horizontal frame
        @params oTh translation between the world and horizontal frame
        """
        T = -oTh - np.array([0.0, 0.0, self.h_ref]).reshape((3, 1))
        R = hRb @ oRh.transpose()
        #// print ("R",R)
        #// print ("T",T)
        

        self.feet_a_cmd = R @ self.footTrajectoryGenerator.get_foot_acceleration()
        self.feet_v_cmd = R @ self.footTrajectoryGenerator.get_foot_velocity()
        self.feet_p_cmd = R @ (self.footTrajectoryGenerator.get_foot_position() + T)
        #print("feet_p_cmd", self.footTrajectoryGenerator.get_foot_position() + T)

        # Feet command velocity in base frame
        v_ref_tmp =np.array([self.v_ref[3:6]]).transpose()
        v_ref_tiled = np.tile(v_ref_tmp, (1, 4))
        
        # Feet command acceleration in base frame
        self.feet_a_cmd = self.feet_a_cmd \
                -     np.cross(v_ref_tiled, np.cross(v_ref_tiled, self.feet_p_cmd, axis=0), axis=0) \
                -  2* np.cross(v_ref_tiled, self.feet_v_cmd, axis=0)
        self.feet_v_cmd = self.feet_v_cmd - np.array([self.v_ref[0:3]]).transpose() - np.cross(v_ref_tiled, self.feet_p_cmd, axis=0)
        
        #print("v_ref_tmp", v_ref_tmp)
        #print("feet_v_cmd", self.feet_v_cmd)
        #print ("np.cross(v_ref_tiled, self.feet_v_cmd, axis=0)",np.cross(v_ref_tiled, self.feet_v_cmd, axis=0))


        #print("feet_p_cmd", self.feet_p_cmd)
        #print("feet_v_cmd", self.feet_v_cmd)
        #print("feet_a_cmd", self.feet_a_cmd)

        #print("np.cross(v_ref_tiled, self.feet_p_cmd, axis=0)", np.cross(v_ref_tiled, self.feet_p_cmd, axis=0))
        #print("v_ref_tiled", v_ref_tiled)

        
