jochenalt/Lisbeth/code/controller/scripts/RemoteControl.py

# coding: utf8

import numpy as np
from Keyboard import KeyboardClient
import Types
from Utils import LowpassFilter 

class RemoteControl:
    """Joystick-like controller that outputs the reference velocity in local frame

    Args:
        predefined (bool): use either a predefined velocity profile (True) or a gamepad (False)
    """

    def __init__(self, dT, predefined, multi_simu=False):

        # Reference velocity in local frame
        self.v_ref = np.array([[0.0, 0.0, 0.0, 0.0, 0.0, 0.0]]).T

        self.reduced = False
        self.stop = False

        self.v_ref_lowpass = LowpassFilter (dT, 50, self.v_ref)

        # Bool to modify the update of v_ref
        # Used to launch multiple simulations
        self.multi_simu = multi_simu

        # If we are using a predefined reference velocity (True) or a joystick (False)
        self.predefined = predefined

        # If we are performing an analysis from outside
        self.analysis = False

        # Joystick variables (linear and angular velocity and their scaling for the joystick)
        self.vX = 0.
        self.vY = 0.
        self.vYaw = 0.
        self.VxScale = 0.6
        self.VyScale = 1.2
        self.vYawScale = 1.6

        self.Vx_ref = 0.3
        self.Vy_ref = 0.0
        self.Vw_ref = 0.0

        self.gaitCode = 0

    def update_v_ref(self, k_loop, velID):
        """Update the reference velocity of the robot along X, Y and Yaw in local frame by
        listening to a gamepad handled by an independent thread

        Args:
            k_loop (int): numero of the current iteration
            velID (int): Identifier of the current velocity profile to be able to handle different scenarios
        """

        if self.predefined:
            if self.multi_simu:
                self.update_v_ref_multi_simu(k_loop)
            elif self.analysis:
                self.handle_v_switch(k_loop)
            else:
                self.update_v_ref_predefined(k_loop, velID)
        else:
            self.update_v_ref_gamepad(k_loop)

        return 0

    def update_v_ref_gamepad(self, k_loop):
        """Update the reference velocity of the robot along X, Y and Yaw in local frame by
        listening to a gamepad handled by an independent thread

        Args:
            k_loop (int): numero of the current iteration
        """

        # Create the gamepad client
        if k_loop == 0:
            self.gp = KeyboardClient()

        # Get the velocity command based on the position of joysticks
        self.vX = self.gp.speedX.value * self.VxScale
        self.vY = self.gp.speedY.value * self.VyScale
        self.vYaw = self.gp.speedZ.value * self.vYawScale

        self.v_gp = np.array(
                [[self.vX, self.vY, - self.gp.bodyZ.value* 0.25, -self.gp.bodyY.value * 5, self.gp.bodyX.value * 2, self.vYaw]]).T

        self.isMoving = np.any(np.abs([self.vX, self.vY, self.vYaw]) > 0.001)
        # Reduce the size of the support polygon by pressing Start
        #self.reduced = not self.reduced

        # Switch to safety controller if the Back key is pressed
        if not self.gp.running.value:
            self.stop = True


        # Low pass filter to slow down the changes of velocity when moving the joysticks
        self.v_ref = self.v_ref_lowpass.compute(self.v_gp)
        self.v_ref[(self.v_ref < 0.005) & (self.v_ref > -0.005)] = 0.0
    
        # Update joystick code depending on which buttons are pressed
        # Check joystick buttons to trigger a change of gait type

        # Switch gaits
        self.gaitCode = Types.GaitType.NoGait.value
        if self.gp.gaitCode.value != 0:
            self.gaitCode = self.gp.gaitCode.value
            self.gp.gaitCode.value = 0

        return 0


    def handle_v_switch(self, k):
        """Handle the change of reference velocity according to the chosen predefined velocity profile

        Args:
            k (int): numero of the current iteration
        """

        i = 1
        while (i < self.k_switch.shape[0]) and (self.k_switch[i] <= k):
            i += 1
        if (i != self.k_switch.shape[0]):
            self.apply_velocity_change(k, i)

    def apply_velocity_change(self, k, i):
        """Change the velocity reference sent to the robot
        4-th order polynomial: zero force and force velocity at start and end
        (bell-like force trajectory)

        Args:
            k (int): numero of the current iteration
            i (int): numero of the active phase of the reference velocity profile
        """

        ev = k - self.k_switch[i-1]
        t1 = self.k_switch[i] - self.k_switch[i-1]
        A3 = 2 * (self.v_switch[:, (i-1):i] -
                  self.v_switch[:, i:(i+1)]) / t1**3
        A2 = (-3/2) * t1 * A3
        self.v_ref = self.v_switch[:, (i-1):i] + A2*ev**2 + A3*ev**3

        return 0

    def update_v_ref_predefined(self, k_loop, velID):
        """Update the reference velocity of the robot along X, Y and Yaw in local frame
        according to a predefined sequence

        Args:
            k_loop (int): numero of the current iteration
            velID (int): identifier of the current velocity profile to be able to handle different scenarios
        """

        if velID == 0:
            if (k_loop == 0):
                self.k_switch = np.array(
                    [0, 500, 2000, 3000, 4000, 13000, 20000, 30000])
                self.v_switch = np.array([[0.0, 0.0, 0.25, 0.25, 0.0, 0.0, 0.0, 0.0],
                                          [0.0, 0.0,  0.0, 0.0,
                                              0.0, 0.0, 0.0, 0.0],
                                          [0.0, 0.0,  0.0, 0.0,
                                              0.0, 0.0, 0.0, 0.0],
                                          [0.0, 0.0,  0.0, 0.0,
                                              0.0, 0.0, 0.0, 0.0],
                                          [0.0, 0.0,  0.0, 0.0,
                                              0.0, 0.0, 0.0, 0.0],
                                          [0.0, 0.0,  0.0, 0.0, 0.0, 0.0, 0.0, 0.0]])
        elif velID == 1:
            if (k_loop == 0):
                V_max = 1.0
                R_max = 0.3
                self.k_switch = np.array([0, 1000, 3000, 8000, 12000, 16000, 20000, 22000,
                                          23000, 26000, 30000, 33000, 34000, 40000, 41000, 43000,
                                          44000, 45000])
                self.v_switch = np.zeros((6, self.k_switch.shape[0]))
                self.v_switch[0, :] = np.array([0.0, 0.0, V_max, V_max, 0.0, 0.0, 0.0,
                                                0.0, -V_max, -V_max, 0.0, 0.0, 0.0, V_max, V_max, V_max,
                                                V_max, V_max])
                self.v_switch[1, :] = np.array([0.0, 0.0,  0.0, 0.0, -V_max*0.5, -V_max*0.5, 0.0,
                                                0.0, 0.0, 0.0, 0.0, 0.0, 0.0, 0.0, 0.0, 0.0,
                                                0.0, 0.0])
                self.v_switch[5, :] = np.array([0.0, 0.0,  R_max, R_max, R_max, 0.0, 0.0, 0.0,
                                                0.0, 0.0, 0.0, 0.0, R_max, R_max, 0.0, 0.0,
                                                -R_max, 0.0])
        elif velID == 2:
            self.k_switch = np.array([0, 7000, 14000, 20000, 30000])
            self.v_switch = np.array([[0.0, 0.7, 1.3, 1.3, 1.3],
                                      [0.0, 0.0, 0.0, 0.0, 0.0],
                                      [0.0, 0.0, 0.0, 0.0, 0.0],
                                      [0.0, 0.0, 0.0, 0.0, 0.0],
                                      [0.0, 0.0, 0.0, 0.0, 0.0],
                                      [0.0, 0.0, 0.0, 0.0, 0.0]])
        elif velID == 3:
            if (k_loop == 0):
                self.k_switch = np.array([0, 1000, 2000, 7000, 26000, 30000])
                self.v_switch = np.array([[0.0, 0.0,  0.0, 0.3, 0.3, 0.0],
                                          [0.0, 0.0,  0.0, 0.0, 0.0, 0.0],
                                          [0.0, 0.0,  0.0, 0.0, 0.0, 0.0],
                                          [0.0, 0.0,  0.0, 0.0, 0.0, 0.0],
                                          [0.0, 0.0,  0.0, 0.0, 0.0, 0.0],
                                          [0.0, 0.0,  0.3, 0.0, 0.0, 0.0]])
        elif velID == 4:
            if (k_loop == 0):
                self.k_switch = np.array([0, 1000, 3000, 7000, 9000, 30000])
                self.v_switch = np.array([[0.0, 0.0,  1.5, 1.5, 1.5, 1.5],
                                          [0.0, 0.0,  0.0, 0.0, 0.0, 0.0],
                                          [0.0, 0.0,  0.0, 0.0, 0.0, 0.0],
                                          [0.0, 0.0,  0.0, 0.0, 0.0, 0.0],
                                          [0.0, 0.0,  0.0, 0.0, 0.0, 0.0],
                                          [0.0, 0.0,  0.0, 0.0, 0.4, 0.4]])
        elif velID == 5:
            if (k_loop == 0):
                """self.k_switch = np.array([0, 500, 1500, 2600, 5000, 6500, 8000])
                self.v_switch = np.array([[0.0, 0.0,  0.7, 0.6, 0.3, 0.3, 0.0],
                                          [0.0, 0.0,  0.0, 0.0, 0.0, 0.0, 0.0],
                                          [0.0, 0.0,  0.0, 0.0, 0.0, 0.0, 0.0],
                                          [0.0, 0.0,  0.0, 0.0, 0.0, 0.0, 0.0],
                                          [0.0, 0.0,  0.0, 0.0, 0.0, 0.0, 0.0],
                                          [0.0, 0.0,  0.0, 0.4, 0.6, 0.0, 0.0]])"""
                self.k_switch = np.array([0, 500, 1500, 2600, 5000, 6500, 7000, 8000, 9000])
                self.v_switch = np.array([[0.0, 0.0,  0.5, 0.6, 0.3, 0.6, -0.5, 0.7, 0.0],
                                          [0.0, 0.0,  0.0, 0.0, 0.0, 0.0, 0.0, 0.0, 0.0],
                                          [0.0, 0.0,  0.0, 0.0, 0.0, 0.0, 0.0, 0.0, 0.0],
                                          [0.0, 0.0,  0.0, 0.0, 0.0, 0.0, 0.0, 0.0, 0.0],
                                          [0.0, 0.0,  0.0, 0.0, 0.0, 0.0, 0.0, 0.0, 0.0],
                                          [0.0, 0.0,  0.2, 0.7, 0.7, 0.0, -0.4, -0.6, 0.0]])

        elif velID == 6:
            if (k_loop == 0):
                self.k_switch = np.array(
                    [0, 1000, 2500, 5000, 7500, 8000, 10000])
                self.v_switch = np.array([[0.0, 0.0,  0.8, 0.4, 0.8, 0.8, 0.0],
                                          [0.0, 0.0,  0.0, 0.0, 0.0, 0.0, 0.0],
                                          [0.0, 0.0,  0.0, 0.0, 0.0, 0.0, 0.0],
                                          [0.0, 0.0,  0.0, 0.0, 0.0, 0.0, 0.0],
                                          [0.0, 0.0,  0.0, 0.0, 0.0, 0.0, 0.0],
                                          [0.0, 0.0,  0.0, 0.55, 0.3, 0.0, 0.0]])

        self.handle_v_switch(k_loop)
        return 0

    def update_v_ref_multi_simu(self, k_loop):
        """Update the reference velocity of the robot along X, Y and Yaw in local frame
        according to a predefined sequence

        Args:
            k_loop (int): number of MPC iterations since the start of the simulation
            velID (int): Identifier of the current velocity profile to be able to handle different scenarios
        """

        # Moving forwards
        """if k_loop == self.k_mpc*16*3:
            self.v_ref = np.array([[1.0, 0.0, 0.0, 0.0, 0.0, 0.0]]).T"""

        beta_x = int(max(abs(self.Vx_ref)*10000, 100.0))
        alpha_x = np.max([np.min([(k_loop-self.k_mpc*16*3)/beta_x, 1.0]), 0.0])

        beta_y = int(max(abs(self.Vy_ref)*10000, 100.0))
        alpha_y = np.max([np.min([(k_loop-self.k_mpc*16*3)/beta_y, 1.0]), 0.0])

        beta_w = int(max(abs(self.Vw_ref)*2500, 100.0))
        alpha_w = np.max([np.min([(k_loop-self.k_mpc*16*3)/beta_w, 1.0]), 0.0])

        # self.v_ref = np.array([[0.3*alpha, 0.0, 0.0, 0.0, 0.0, 0.0]]).T
        self.v_ref = np.array(
            [[self.Vx_ref*alpha_x, self.Vy_ref*alpha_y, 0.0, 0.0, 0.0, self.Vw_ref*alpha_w]]).T

        return 0

    def update_for_analysis(self, des_vel_analysis, N_analysis, N_steady):

        self.analysis = True

        self.k_switch = np.array([0, 500, N_analysis, N_analysis + N_steady])
        self.v_switch = np.zeros((6, 4))
        self.v_switch[:, 2] = des_vel_analysis
        self.v_switch[:, 3] = des_vel_analysis

        return 0
