jochenalt/Lisbeth/(commit log)

2022-01-27 Demo runs
    [bauzil_stairs.stl, bauzil_stairs.urdf]
2022-02-06 Moved code to ./code and added kedyboard input
    [bauzil_stairs.stl, bauzil_stairs.urdf]
2022-02-11 Corrected silkscreen on Footsensor
    [FootSensor.brd, FootSensor.sch]
2022-02-11 added pinocchio installation for ARM
2022-02-14 created description
    [solo.urdf, solo12.urdf, solo12_hip_fe_fl.stl, solo12_hip_fe_fr.stl, solo12_hip_fe_hl.stl, solo12_hip_fe_hr.stl, solo12_lower_leg_left_side.stl, solo12_lower_leg_right_side.stl]
2022-02-20 datasheet IMU
2022-02-20 Check Imu and set_joints
2022-02-26 Bugfix: wrong size of basevelocity
    [Controller.py]
2022-03-02 Printed Toe, Foot & Thigh
    [0717A0BA99C.ipt, 1304300140.ipt, 1601000990.ipt, 1652503109.ipt, 1654801010.ipt, 1654809302.ipt, 1654818301.ipt, 1654907009.ipt]
2022-03-04 Printed ToeMold and designed BodyDampener
    [Battery Pack.ipt, BodyCover.ipt, BodySiliconeRubber.ipt, BodyStructure Centre.ipt, BodyStructure Front.ipt, BodyStructure HipSupport.ipt, BodyStructure.iam, Foot.iam]
2022-03-06 replaced compass buttons by gaitcode
    [Controller.py, Gait.cpp, Gait.hpp, Joystick.py, Types.h]
2022-03-07 Added filtered acceleration to implement Estimator::isStead
2022-03-09 added body dampener and makeing off photos
    [BodyDamepenerMold.ipt, BodyDampener.ipt, BodyDampener.stp, BodyDampenerMold.ipt, BodySiliconeRubber.ipt, BodyStructure Plate.ipt, BodyStructure Side.ipt, BodyStructure.iam]
2022-03-09 replaced gamepad by keyboard
    [Controller.py, Gait.cpp, Joystick.py]
2022-03-10 removed walkgen and removed dependency to robot-example-data
    [solo.urdf, solo12.urdf, solo12.urdf.xacro]
2022-03-14 removed buggy Kalman filter
    [Controller.py, Estimator.cpp, Estimator.hpp, FootTrajectoryGenerator.cpp, FootstepPlanner.cpp, Gait.cpp, Gait.hpp, ModelLoader.py]
2022-03-24 Print lower Leg
    [BodyDamepenerMold.ipt, BodyDampener Mold.ipt, BodyDampener.ipt, BodyDampener.stp, BodyDampenerMold.ipt, BodyStructure Centre Bottom.ipt, BodyStructure Centre Top.ipt, BodyStructure Centre.ipt]
2022-03-24 cleanup description
    [base.stl, body.stl, foot.stl, hip_fe_fl.stl, hip_fe_fr.stl, hip_fe_hl.stl, hip_fe_hr.stl, lower_leg_left_side.stl]
2022-03-25 new Body Dampener
    [BodyDampener Mold Left.stl, BodyDampener Mold Lid.stl, BodyDampener Mold Mid.stl, BodyDampener Mold Right.stl, BodyDampener Mold.ipt]
2022-03-25 unified Lowpass filters
2022-04-11 Printed complete Leg
    [BodyDampener Holes.stl, BodyDampener Mold Left.stl, BodyDampener Mold Lid.stl, BodyDampener Mold Mid.stl, BodyDampener Mold Right.stl, BodyDampener Mold.ipt, BodyDampener MoldSleeve.stl, BodyDampener.ipt]
2022-04-20 Starting ODrive
    [ADIMP_MDPCS_B_CNS_MDPCS_B.ipt, AMPHE_SATA0012207_A_CNS_SATA00122073_A.ipt, ANT_ANT016008_A_ANT_ANT016008_A.ipt, BGA111_85x114H2_PMX_A_INTEL_Curie_BGA111_A.ipt, BGA1170_25x27H13_P06_A_INTEL_Pentium_BGA1170_A.ipt, BGA153_13X115H1_P05_B_THGBMB_BGA153_D.ipt, BGA64_5x5H12_P05_A_STM32F100R_BGA64_A.ipt, BGA6_14x09H06_P05_A_FPF1321UCX_BGA6_A.ipt]
2022-05-02 Position query in firmware
    [0717A0BA99C.ipt, 1304300140.ipt, 1601000990.ipt, 1652503109.ipt, 1654801010.ipt, 1654809302.ipt, 1654818301.ipt, 1654907009.ipt]
2022-05-02 Space for bigger batteries and flashing ODrive
    [Battery Pack.ipt, BodyStructure Front.ipt, BodyStructure HipSupport.ipt, BodyStructure.iam, Leg Long.iam, Leg Short.iam, Lumbar Long.iam, Lumbar Long.ipt]
2022-05-03 Implemented Group of ODrives
2022-05-05 implemented calibration via teensy
2022-05-15 IMU connected via RS232 Adapter
    [CentralBoard.brd, CentralBoard.sch, esp32_master_board.brd, esp32_master_board.csv, esp32_master_board.sch, seeed_BOM.csv]
2022-05-15 IMU datastream is working
2022-05-16 Starting schematics
    [CentralBoard.brd, CentralBoard.sch]
2022-05-16 new schematics eagle libs
2022-05-18 used MAX3232 IC for IMU connection now
    [CentralBoard.brd, CentralBoard.sch, bom.xlsx]
2022-05-20 Added sockets for IMU, Sensors and ODrives
    [BodyStructure Back.ipt, CentralBoard less-smd.brd, CentralBoard less-smd.sch, CentralBoard.brd, CentralBoard.sch, bom.xlsx]
2022-05-21 removed old SMD version
    [CentralBoard less-smd.brd, CentralBoard less-smd.sch, CentralBoard.brd, CentralBoard.sch]
2022-05-26 new head and tail
    [Adafruit 2.4 OLED display.ipt, Battery Pack.ipt, BodyStructure Back.ipt, BodyStructure Centre Bottom.ipt, BodyStructure Centre Top.ipt, BodyStructure Front.ipt, BodyStructure Head.ipt, BodyStructure HipSupport.ipt]
2022-06-05 added Filter
2022-06-16 removed InvKin.py and replaced by C++ code
    [Estimator.cpp, InvKin.cpp, InvKin.hpp, Types.h]
2022-06-16 validation for correctness for c++ WBC
    [Controller.py, main.py]
2022-06-17 replaced QP_WBC with C++
    [Controller.py, InvKin.cpp, QPWBC.cpp]
2022-06-17 replace Controller params by class
    [Controller.py, main.py]
2022-06-17 replace estimator initialize parameter
    [Controller.py, Estimator.cpp, Estimator.hpp]
2022-06-17 bugfix in Estimator: update_state is called now
    [Controller.py, Estimator.cpp, Estimator.hpp]
2022-06-18 new class Filter
2022-06-19 replaced MPC Wrapper by C++ implementation
    [Controller.py, MPC.cpp]
2022-06-20 BugFix: body rotation has been ignored in feet position calculation
    [Controller.py, FootTrajectoryGenerator.cpp, FootTrajectoryGenerator.hpp, main.py]
2022-06-20 replaced Gait::getCurrentGait by matrix
    [Controller.py, FootTrajectoryGenerator.cpp, FootstepPlanner.cpp, Gait.cpp, Gait.hpp]
2022-06-21 unified urdf consumption
2022-06-21 fixed initialisation of Controller.cpp
    [Controller.cpp, Controller.py, Estimator.cpp, ModelLoader.py, main.py]
2022-06-24 Bugfix: Params to WBC were swapped :-(
    [Controller.cpp, Controller.py, main.py]
2022-06-25 BugFix: wrong body rotation in feet computation
    [Controller.cpp]
2022-06-25 Fixed PY gait change
    [Controller.py, main.py]
2022-06-25 Bugfix: Remove remotecontrol logic from PY controller
    [Controller.py, main.py]
2022-06-25 BUGFIX: cross product in feet target computation had the wrong sign
    [Controller.cpp, main.py]
2022-06-25 Damping was too low, is now 0.2
    [Controller.cpp]
2022-06-26 Made InvKin Eigen types fixed
    [Controller.cpp, Controller.py, InvKin.cpp, InvKin.hpp, Types.h, config.yaml, main.py]
2022-06-26 made some Eigen types in WBC fixed
    [Types.h]
2022-06-26 replaced dynamic Eigen types by fixed ones
    [InvKin.hpp]
2022-06-26 Use of fixed Eigen types
    [Controller.cpp, Controller.py, Estimator.cpp, Estimator.hpp, Types.h]
2022-06-26 used fixed Eigen types in Stateplanner
    [Params.cpp, Params.hpp, QPWBC.cpp, QPWBC.hpp, Utils.cpp, Utils.hpp]
2022-06-26 use of fixed Eigen types in FootStepPlanner
    [FootstepPlanner.cpp, FootstepPlanner.hpp, MPCController.cpp, MPCController.hpp, Types.h]
2022-06-26 more fixed Eigen types
    [Controller.cpp, MPCController.cpp, MPCController.hpp]
2022-06-26 even more fixed types
    [Gait.cpp, Gait.hpp, MPCController.cpp, MPCController.hpp]
2022-06-26 Bugfix: MPC result matrix dims were wrong
    [MPCController.cpp, MPCController.hpp]
2022-06-26 BUGFIX: CoM_offset was missing in python stub
    [Controller.cpp, Controller.py, main.py]
2022-06-26 replaced hard coded footstep positions by computation
    [MPCSolver.cpp]
2022-06-26 replaced hardcoded inertia by computation
    [MPCSolver.cpp]
2022-06-26 added collision model (not yet evaluated though)
    [Controller.cpp, ModelLoader.py]
2022-06-27 IMU docs
2022-06-28 IMU cable
2022-06-28 imu to USB
2022-06-28 Connected new Microstrain IMU
2022-06-29 IMU video
2022-06-30 Created class unscented kalman filter
2022-07-01 added magnetssensor
    [cerebellar.brd, cerebellar.sch]
2022-07-01 added timeout to Magnetometer reading
2022-07-01 added Magnetometer to UKF
    [cerebellar.brd]
2022-07-01 added 3.3V power supply
    [cerebellar.brd, cerebellar.sch]
2022-07-01 Added Standby Line for 3.3. power supply
    [cerebellar.brd, cerebellar.sch]
2022-07-02 Magnetometer works
2022-07-02 Magnetometer works with interrupt now
2022-07-03 Blindly coded hard iron calibration and north calibration
2022-07-03 aligned axes of magnetometer with IMU
    [Lord Microstrain 3DM-CX5 OEM.ipt]
2022-07-03 IMU Holder
    [IMU Holder Bottom.stl, IMU Holder Top.stl, IMU Holder.ipt, IMU+Mag.iam, Lord Microstrain 3DM-CX5 OEM.ipt]
2022-07-04 integrated Magnetometer into IMU Manager
    [IMU Holder.ipt, cerebellar.sch]
2022-07-07 Fixed calibration and storage in EEPROM
    [IMU Holder Bottom.stl, IMU Holder Top.stl]
2022-07-07 IMU returns quaternion + euler now
2022-07-07 Fixed Serial line of IMU
2022-07-07 fixed socket of IMU layout
    [cerebellar.brd, cerebellar.sch]
2022-07-08 Fusion with Magnetometer works
    [BodyStructure.iam, IMU Holder.ipt, IMU+Mag.iam, cerebellar.brd]
2022-07-08 Fixed hard iron magnetometer
    [cerebellar.brd, cerebellar.sch]
2022-07-09 IMU Holder
    [AHRS.iam, BodyStructure HipSupport.ipt, BodyStructure.iam, IMU Holder.ipt]
2022-07-09 Rounded body
    [Battery Pack.ipt, BodyStructure Centre Bottom.ipt, BodyStructure Centre Top.ipt, BodyStructure Head.ipt, BodyStructure HipSupport.ipt, BodyStructure LumbarSupport.ipt, BodyStructure Side.ipt, BodyStructure Tail.ipt]
2022-07-10 Aligned Head
    [BodyStructure Centre Bottom.ipt, BodyStructure Centre Top.ipt, BodyStructure Head.ipt, BodyStructure HipSupport.ipt, BodyStructure LumbarSupport.ipt, BodyStructure Side.ipt, BodyStructure Tail.ipt, BodyStructure.iam]
2022-07-11 new power supply
    [cerebellar.brd, cerebellar.sch]
2022-07-15 implemented linear acceleration
    [BodyStructure Head.ipt, BodyStructure Side.ipt, BodyStructure.iam]
2022-07-21 New tail
    [BodyStructure Head.ipt, BodyStructure Tail.ipt, BodyStructure.iam]
2022-07-21 reimplemented computation of filter cut off frequency
2022-07-21 bugfix get MPCs result
    [Controller.cpp]
2022-07-21 started new cerebellar board
    [cerebellar.brd, cerebellar.sch]
2022-07-21 forgot files
    [cerebellar V1.0.brd, cerebellar V1.0.sch, cerebellar V1.1.brd, cerebellar V1.1.sch]
2022-07-22 Schematics with power supply and INA works
    [cerebellar V1.1.brd, cerebellar V1.1.sch]
2022-07-22 MOSFET Driver tested
    [cerebellar V1.1.brd, cerebellar V1.1.sch]
2022-07-22 new schematics layout
    [cerebellar V1.1.brd]
2022-07-22 buffersize in UART7 for less checksum errors
    [cerebellar V1.0.brd, cerebellar V1.0.sch, cerebellar V1.1.brd, cerebellar V1.1.sch]
2022-07-22 new layout
    [cerebellar V1.1.brd]
2022-07-23 Added LED Power Manager
    [cerebellar V1.1.brd, cerebellar V1.1.sch]
2022-07-23 docs magnetometer
    [IMU Holder.ipt]
2022-07-23 images magnetometer
2022-07-23 magnetometer docs
2022-07-23 improved schmeatics
    [cerebellar V1.1.brd, cerebellar V1.1.sch]
2022-07-25 started Raspi
    [cerebellar V1.1.brd]
2022-07-26 It runs on a Raspberry now!
2022-07-28 Main Board V3 with 5V 3A power supply for Raspberry
    [BodyStructure Head.ipt, IMU+Mag.iam, RasPi-HAT.brd, RasPi-HAT.sch, cerebellar V1.1.brd, cerebellar V1.2.brd, cerebellar V1.2.sch]
2022-07-29 restart ODrive
    [cerebellar V1.2.brd, cerebellar V1.2.sch]
2022-07-30 Ordered PCB V1.2
    [BodyStructure Head.ipt, cerebellar V1.2.brd, cerebellar V1.2.sch]
2022-07-31 Display is now connected to Raspi instead of Teensy
    [cerebellar V1.2.brd, cerebellar V1.2.sch]
