jochenalt/Lisbeth/(notices)

Notices in the files:
parts and their libraries:
microchip-smsc-lan8720: (C) 2014 Tomasz Boleslaw CEDRO, cederom@tlen.pl, http://www.tomek.cedro.info.
dicons: Copyright (C) 2004, Bob Starr (rtzaudio@mindspring.com)
