jochenalt/Lisbeth/docs/source/images/all/2022-04-17 13.24.56.jpg

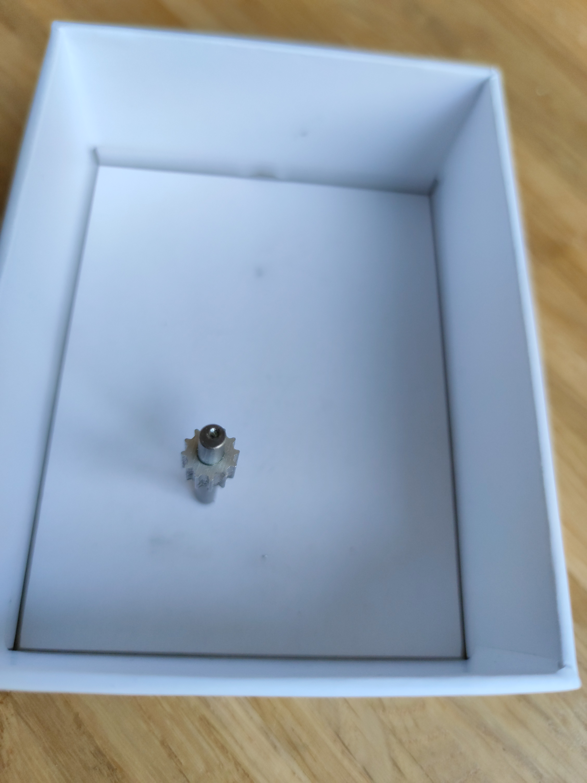
docs/source/images/all/2022-04-17 13.24.56.jpg
