jochenalt/Lisbeth/docs/source/images/all/2022-04-17 13.25.22.jpg

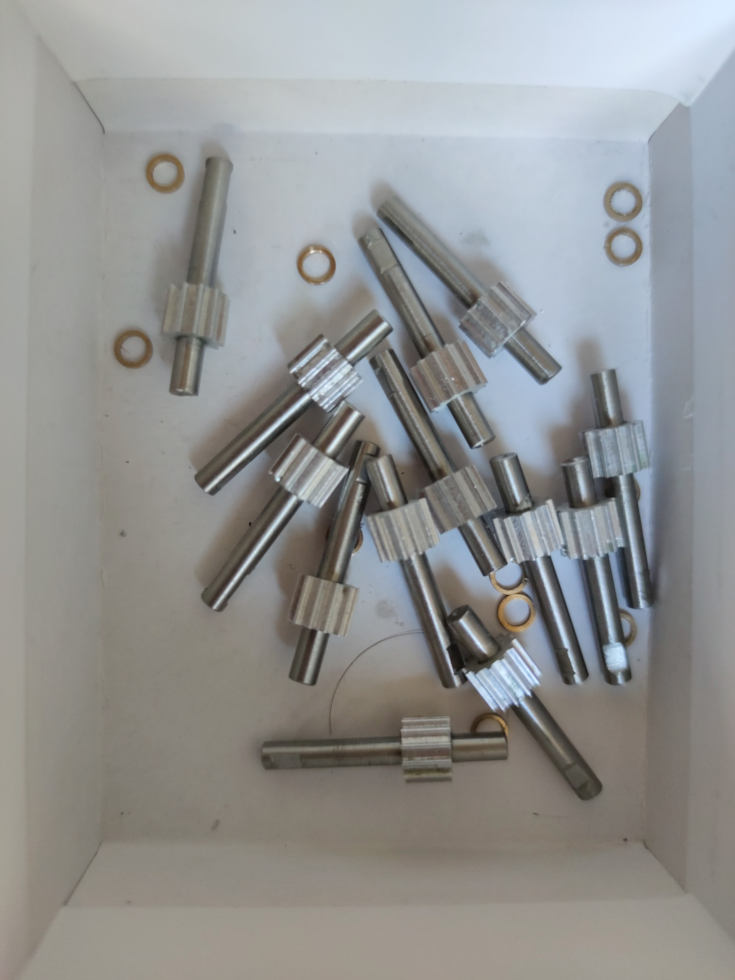
docs/source/images/all/2022-04-17 13.25.22.jpg
