jochenalt/Lisbeth/docs/source/images/all/2022-04-17 13.26.15.jpg

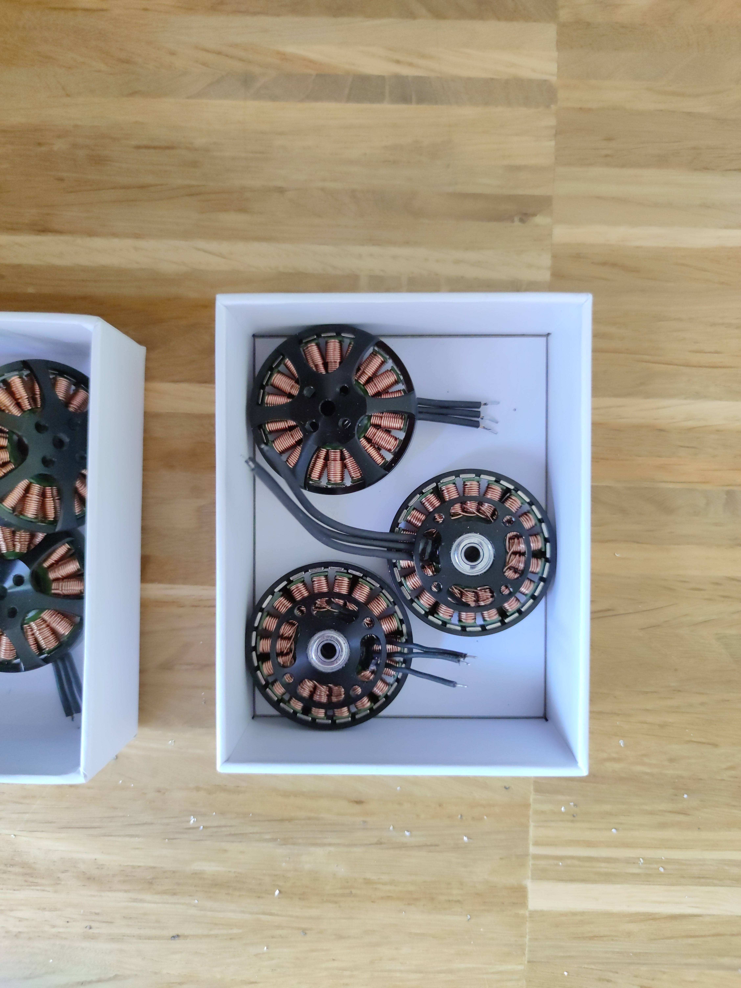
docs/source/images/all/2022-04-17 13.26.15.jpg
